MEC-ETS/KiCad_Library/3D_Models/IC/Master_Board.step.SLDASM

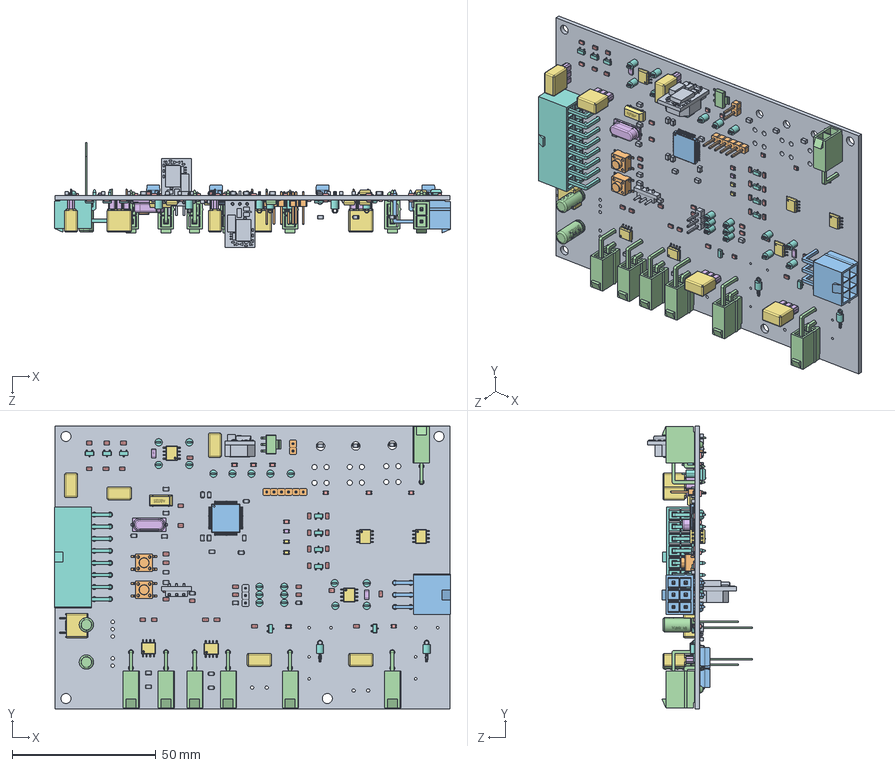
[picture p1: CAD file, 2025-02-11]
3D_Models/IC/Master_Board.step.SLDASM
137.8 x 98.3 x 36.7 mm
COMPOUND.step x 47
COMPOUND-0.step
SOLID.step x 4
COMPOUND-2.step x 2
COMPOUND-5.step x 9
COMPOUND-13.step x 2
COMPOUND-7.step x 2
SOLID-2.step x 11
SOLID-9.step x 2
SOLID-14.step x 5
SOLID-15.step x 5
SOLID-16.step x 5
SOLID-17.step x 5
SOLID-18.step x 5
COMPOUND-19.step x 6
COMPOUND-14.step
COMPOUND-20.step
COMPOUND-16.step
COMPOUND-29.step
COMPOUND-6.step x 7
COMPOUND-1.step x 57
COMPOUND-21.step x 2
SOLID-26.step x 8
COMPOUND-23.step x 21
COMPOUND-24.step x 2
COMPOUND-22.step x 2
SOLID-0.step
SOLID-25.step
SOLID-8.step x 2
SOLID-28.step
SOLID-27.step
SOLID-33.step
COMPOUND-34.step
