MEC-ETS/KiCad_Library/3D_Models/Assembly/KTT0003B.stp

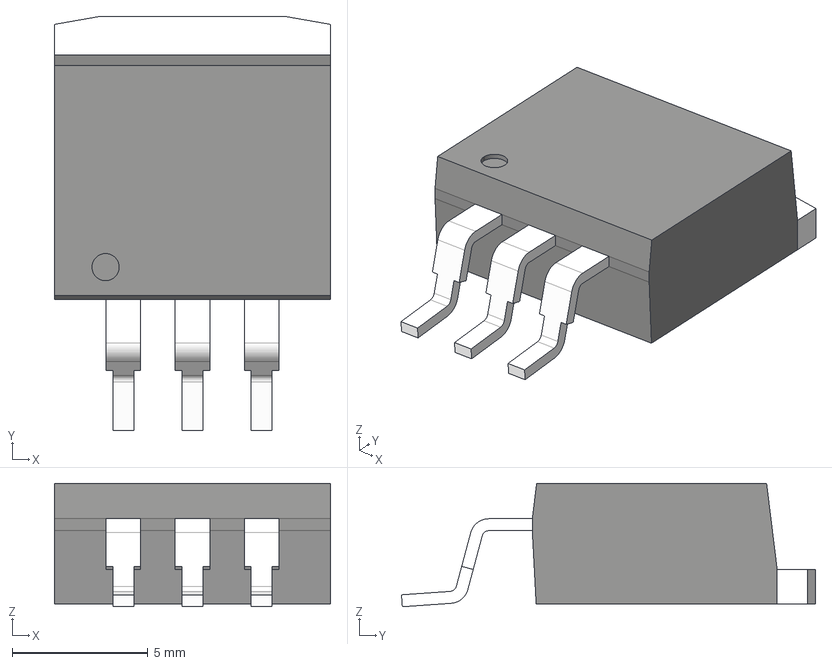
[picture p2: CAD file, 2025-03-18]
3D_Models/Assembly/KTT0003B.stp
10.2 x 15.2 x 4.54 mm
BODY-TO
HTSINK-TO263
LEAD-TO263 x 3
