MEC-ETS/KiCad_Library/3D_Models/Capacitors/DE2E3SA102MN3AY02F.step

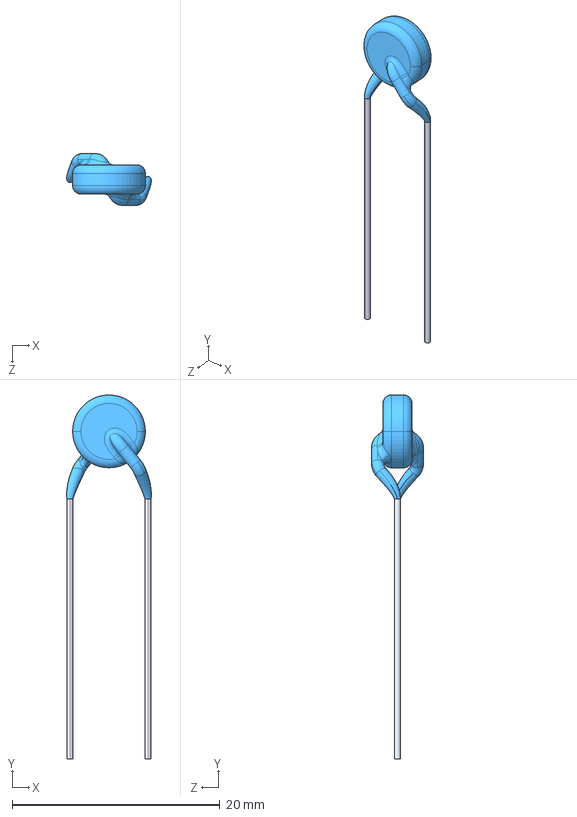
[picture p3: CAD file, 2025-02-28]
3D_Models/Capacitors/DE2E3SA102MN3AY02F.step
8.16 x 35.0 x 5.00 mm
