MEC-ETS/KiCad_Library/3D_Models/Crystals/XTAL_ABL-16_ABR.step

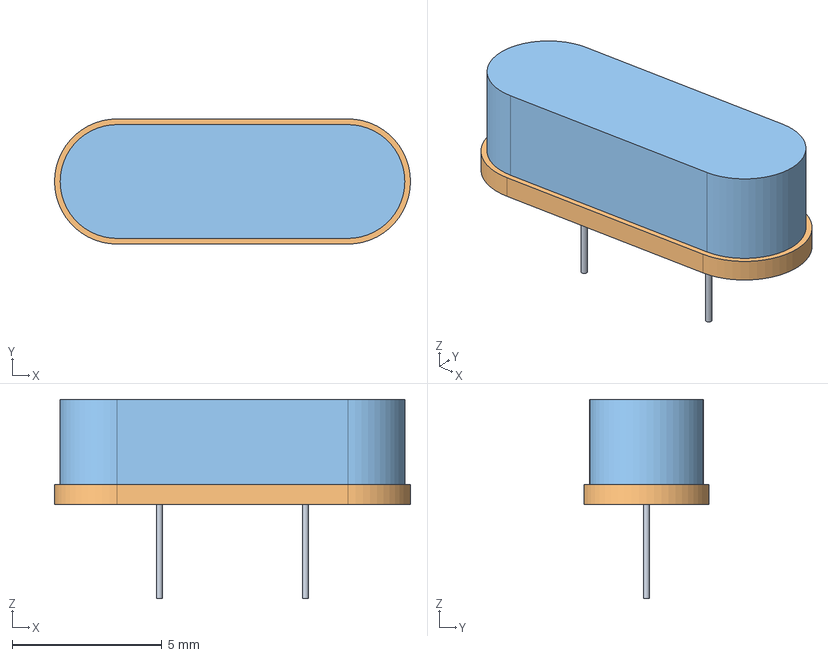
[picture p4: CAD file, 2025-03-23]
3D_Models/Crystals/XTAL_ABL-16_ABR.step
11.9 x 4.18 x 6.65 mm
