MEC-ETS/KiCad_Library/3D_Models/Diodes/CR_DO-41_SDS.step

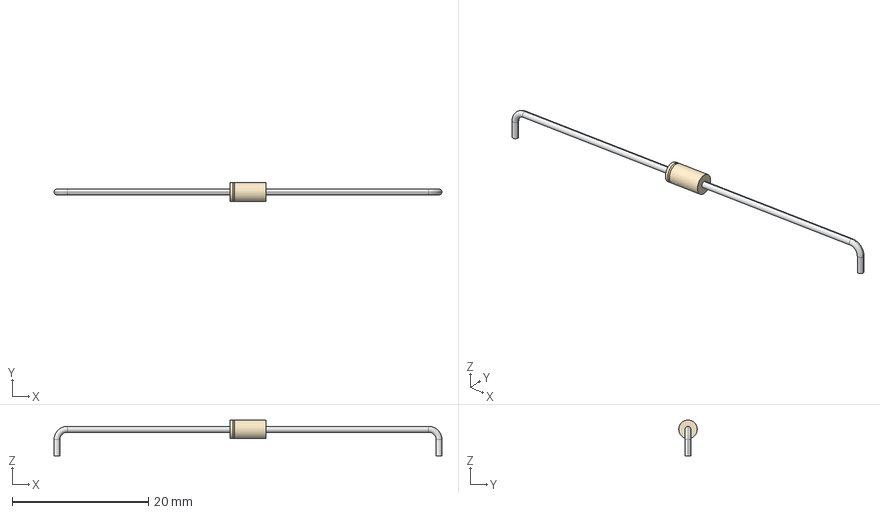
[picture p5: CAD file, 2025-03-19]
3D_Models/Diodes/CR_DO-41_SDS.step
56.9 x 2.72 x 5.26 mm
