MEC-ETS/KiCad_Library/3D_Models/Filter/FB-0603.stp

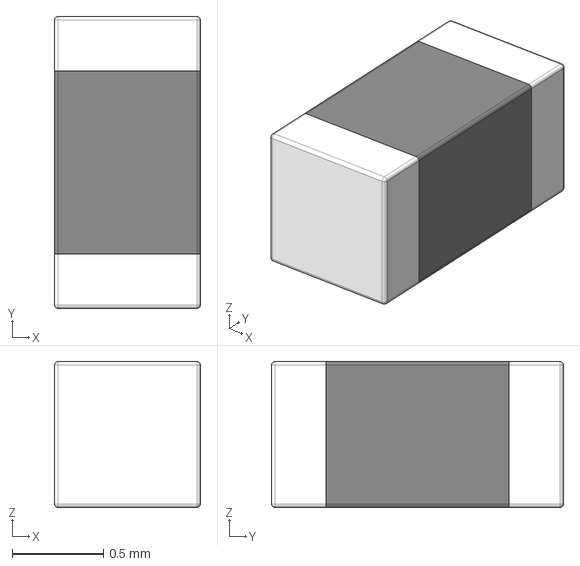
[picture p6: CAD file, 2025-02-11]
3D_Models/Filter/FB-0603.stp
0.8 x 1.60 x 0.8 mm
