MEC-ETS/KiCad_Library/3D_Models/Fuses/4628.step

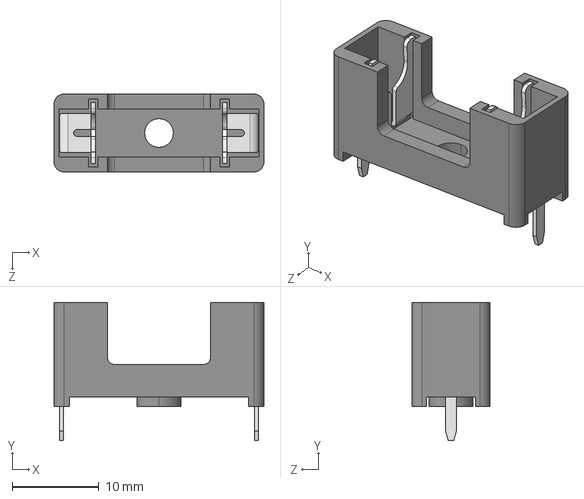
[picture p7: CAD file, 2025-02-28]
3D_Models/Fuses/4628.step
24.2 x 16.0 x 8.99 mm
