MEC-ETS/KiCad_Library/3D_Models/IC/STM32F103C8T6.STEP

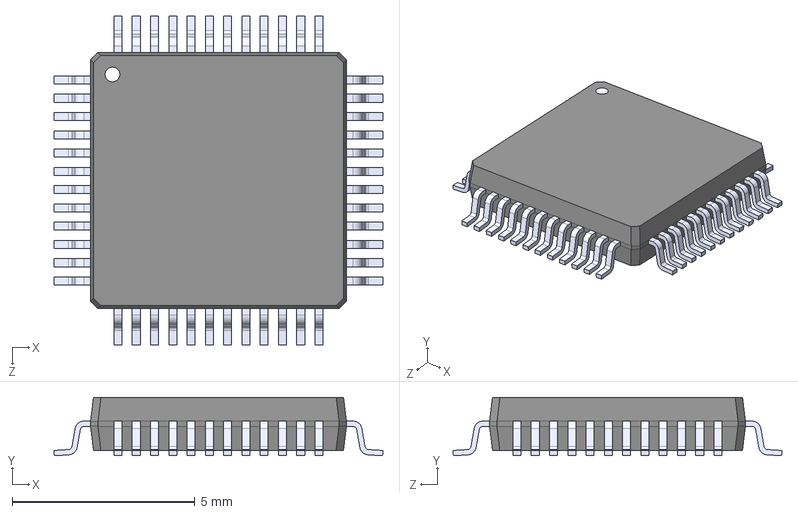
[picture p8: CAD file, 2025-03-27]
3D_Models/IC/STM32F103C8T6.STEP
9.00 x 1.60 x 9.00 mm
