MEC-ETS/KiCad_Library/3D_Models/Inductors/IND_BOURNS_SRR1240.step

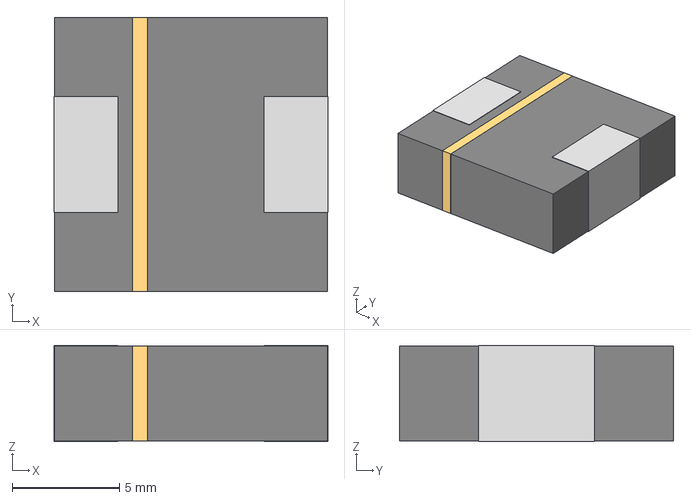
[picture p9: CAD file, 2025-02-28]
3D_Models/Inductors/IND_BOURNS_SRR1240.step
12.8 x 12.8 x 4.50 mm
