MEC-ETS/KiCad_Library/3D_Models/LED/OBJ_GREGS-SK6812MINI-E-DOWN-POINTING.obj

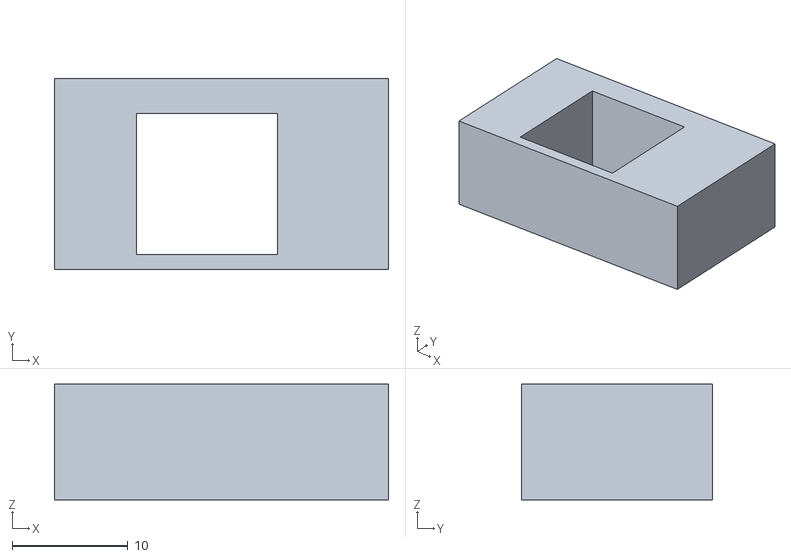
[picture p10: CAD file, 2025-03-18]
3D_Models/LED/OBJ_GREGS-SK6812MINI-E-DOWN-POINTING.obj
28.9 x 16.5 x 10.0
