MEC-ETS/KiCad_Library/3D_Models/Relays/PR23-5V-900-1C.step

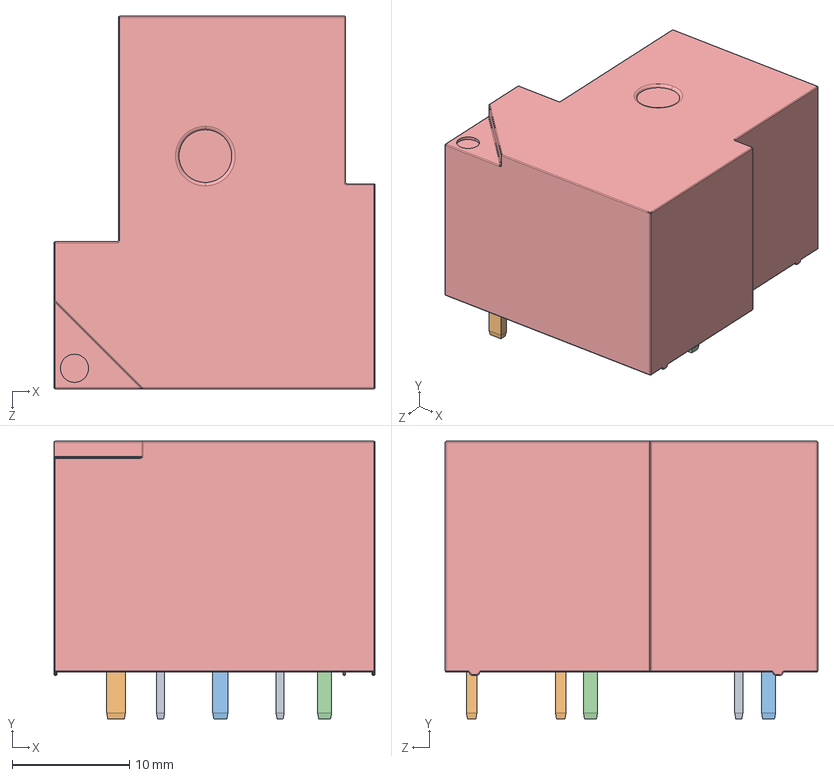
[picture p11: CAD file, 2025-02-28]
3D_Models/Relays/PR23-5V-900-1C.step
27.4 x 23.7 x 31.8 mm
