MEC-ETS/KiCad_Library/3D_Models/Resistors/PT01-D115D-B503.step

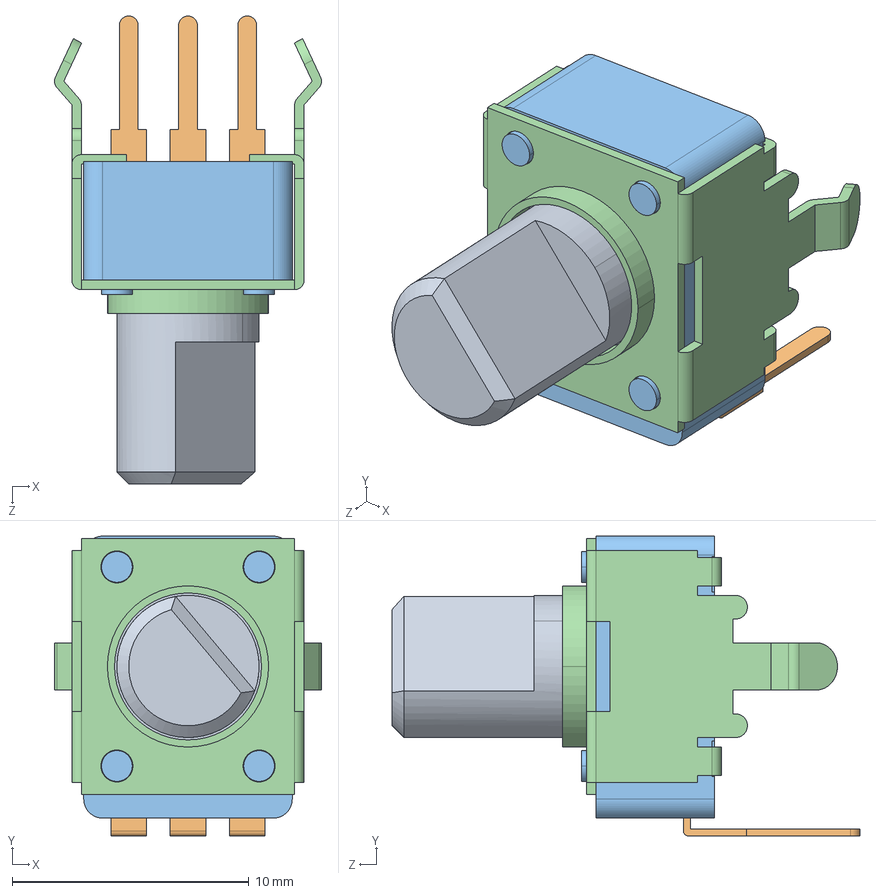
[picture p12: CAD file, 2025-03-23]
3D_Models/Resistors/PT01-D115D-B503.step
11.3 x 12.7 x 19.8 mm
PT01_15D_SHAFT
PT01-D_BODY
PT01-D_SHELL
