MEC-ETS/KiCad_Library/3D_Models/Switches/D501J12S2APQA.stp

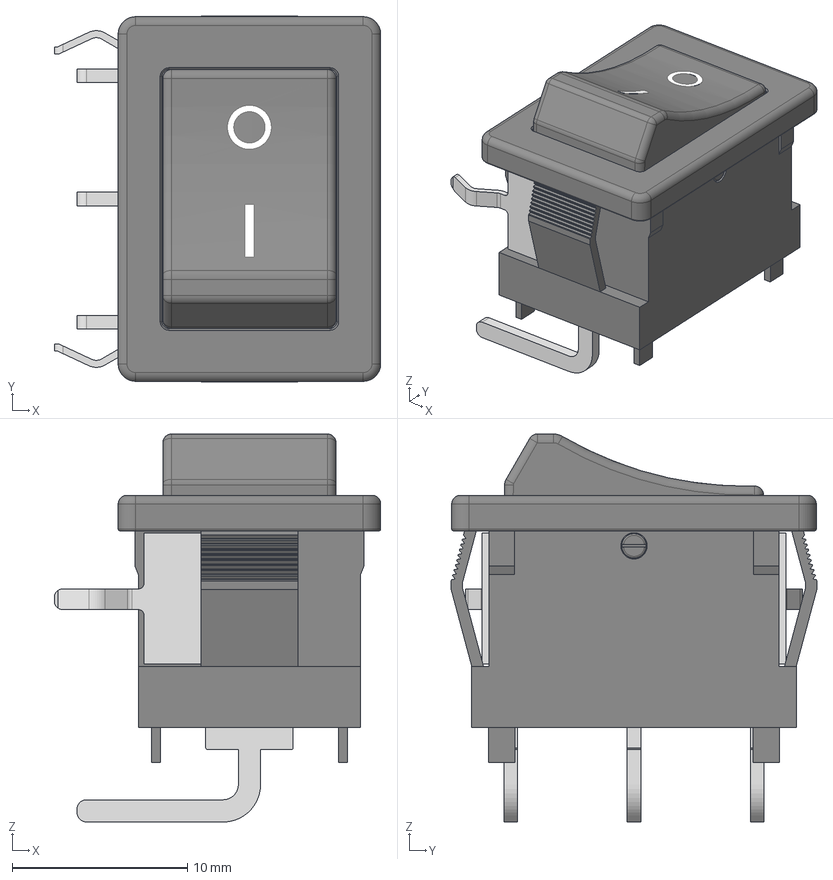
[picture p13: CAD file, 2025-03-18]
3D_Models/Switches/D501J12S2APQA.stp
18.6 x 20.9 x 22.2 mm
