MEC-ETS/KiCad_Library/SRD-05VDC-SL-C.step

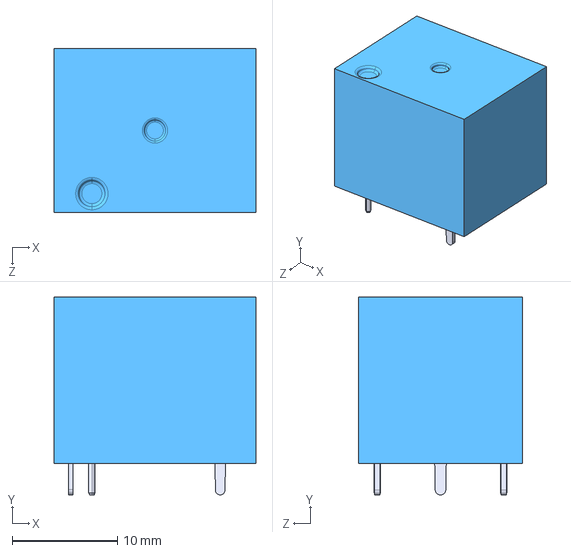
[picture p14: CAD file, 2025-08-30]
SRD-05VDC-SL-C.step
19.2 x 18.8 x 15.6 mm
