MEC-ETS/KiCad_Library/3D_Models/Assembly/LD1117DT33CTR.step

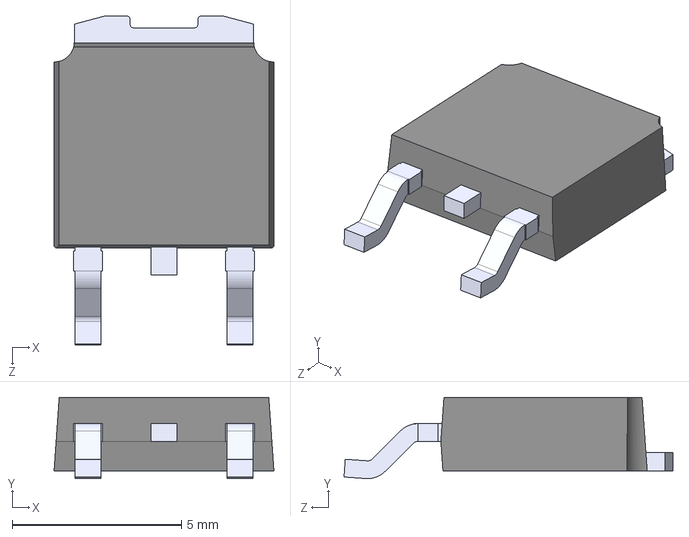
[picture p15: CAD file, 2025-03-18]
3D_Models/Assembly/LD1117DT33CTR.step
6.50 x 2.40 x 9.72 mm
