MEC-ETS/KiCad_Library/3D_Models/Capacitors/CCS_CCSTDNOS_1812_L4.8W3.5T2.3B0.95.step

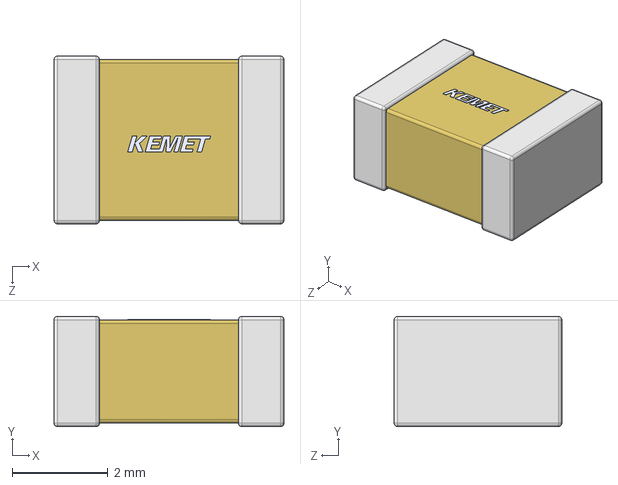
[picture p16: CAD file, 2025-02-28]
3D_Models/Capacitors/CCS_CCSTDNOS_1812_L4.8W3.5T2.3B0.95.step
4.80 x 2.30 x 3.50 mm
