MEC-ETS/KiCad_Library/3D_Models/Crystals/HC49_US.step

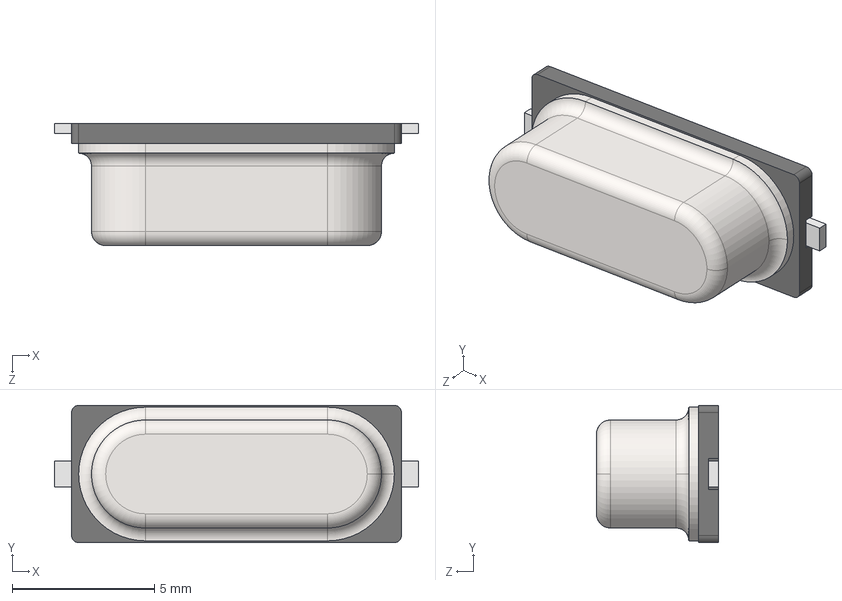
[picture p17: CAD file, 2025-02-11]
3D_Models/Crystals/HC49_US.step
12.8 x 4.83 x 4.30 mm
