MEC-ETS/KiCad_Library/3D_Models/Diodes/DO-35_DO-204AH__MCH.step

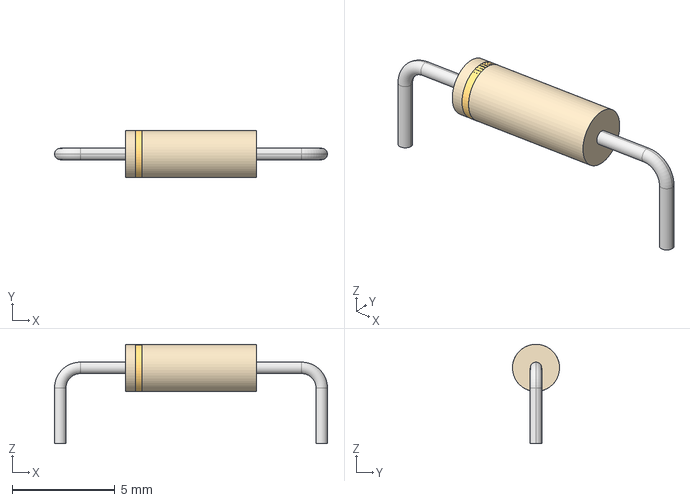
[picture p18: CAD file, 2025-03-19]
3D_Models/Diodes/DO-35_DO-204AH__MCH.step
13.3 x 2.29 x 4.83 mm
