MEC-ETS/KiCad_Library/3D_Models/Filter/WE-CNSW-0603.stp

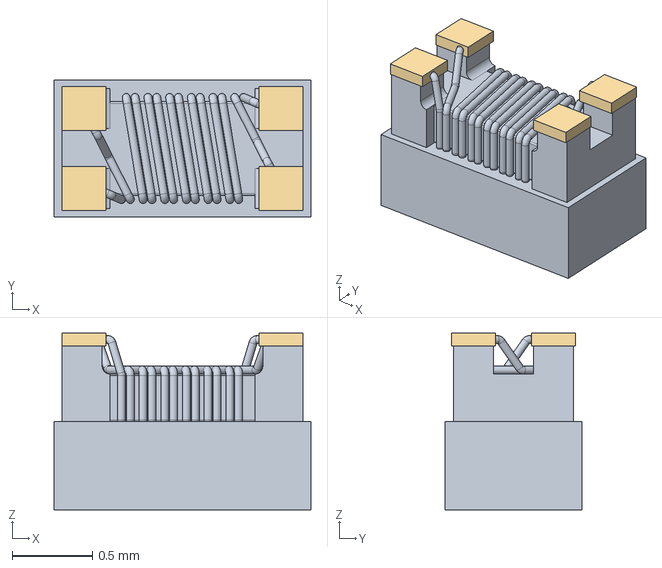
[picture p19: CAD file, 2025-02-11]
3D_Models/Filter/WE-CNSW-0603.stp
1.60 x 0.85 x 1.10 mm
