MEC-ETS/KiCad_Library/3D_Models/Fuses/ATO_BLADE_FUSE.STEP

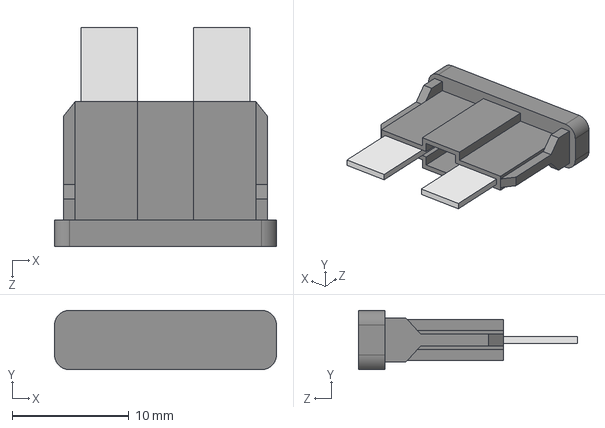
[picture p20: CAD file, 2025-02-11]
3D_Models/Fuses/ATO_BLADE_FUSE.STEP
19.0 x 5.08 x 18.8 mm
