MEC-ETS/KiCad_Library/3D_Models/IC/TO-92_2.step

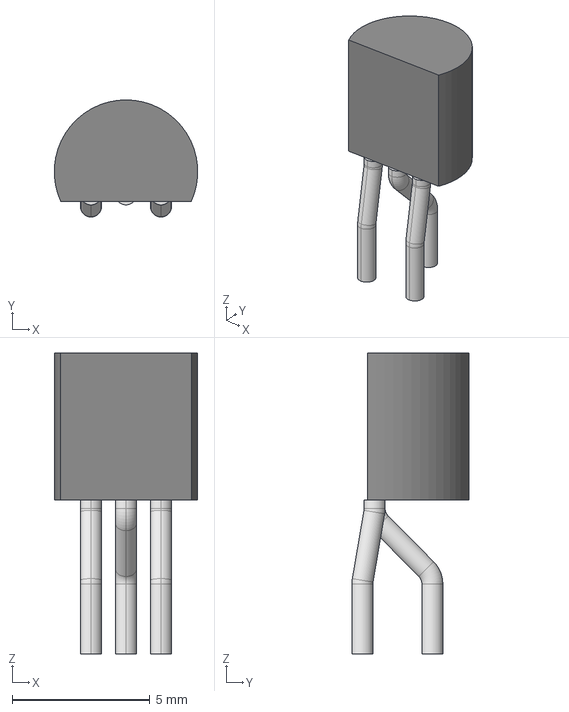
[picture p21: CAD file, 2025-03-19]
3D_Models/IC/TO-92_2.step
5.20 x 4.25 x 10.9 mm
