MEC-ETS/KiCad_Library/3D_Models/LED/SMD WS2812B Mini.step

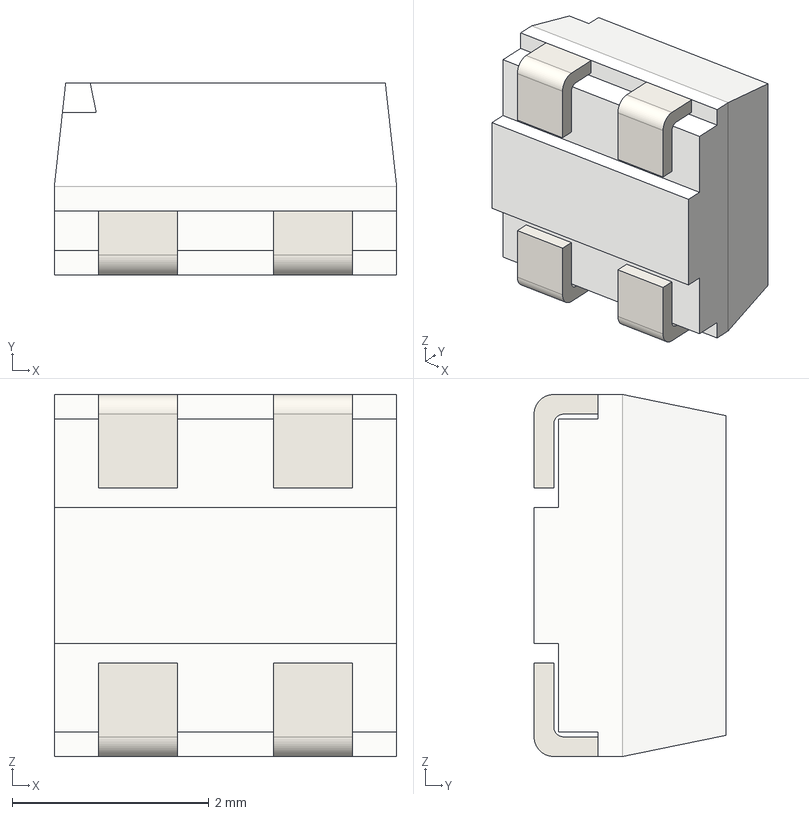
[picture p22: CAD file, 2025-03-18]
3D_Models/LED/SMD WS2812B Mini.step
3.48 x 1.95 x 3.68 mm
