MEC-ETS/KiCad_Library/3D_Models/Relays/G6C_2117P_US.step

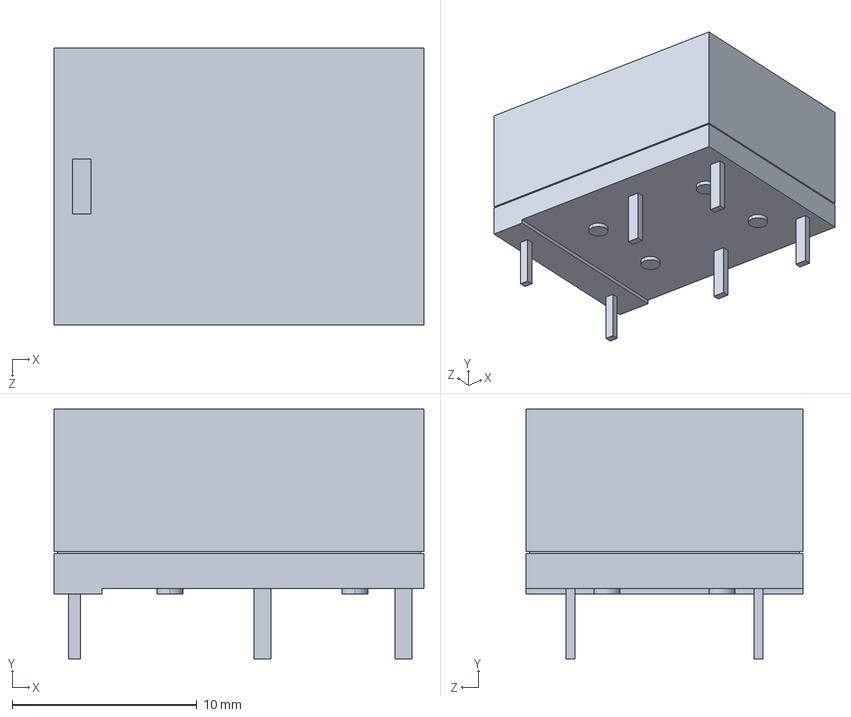
[picture p23: CAD file, 2025-02-11]
3D_Models/Relays/G6C_2117P_US.step
20.0 x 13.5 x 15.0 mm
