MEC-ETS/KiCad_Library/3D_Models/Resistors/RES_2512_SUS.step

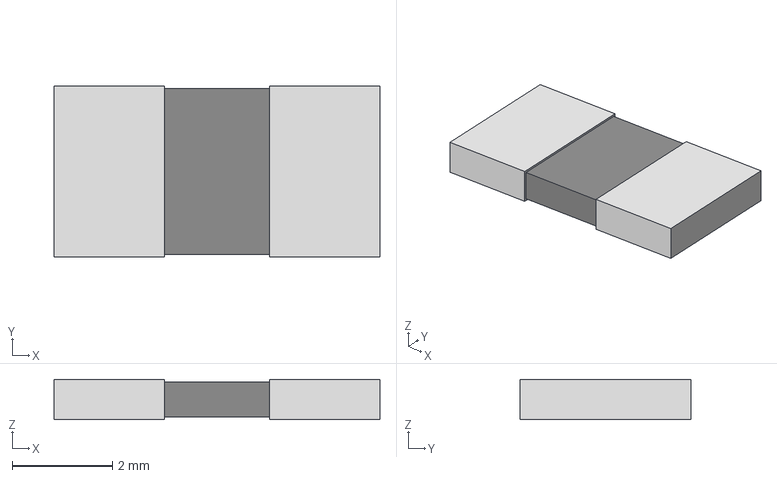
[picture p24: CAD file, 2025-02-28]
3D_Models/Resistors/RES_2512_SUS.step
6.50 x 3.40 x 0.8 mm
