MEC-ETS/KiCad_Library/3D_Models/Transformers/LD30-23BxxR2_MNS.step

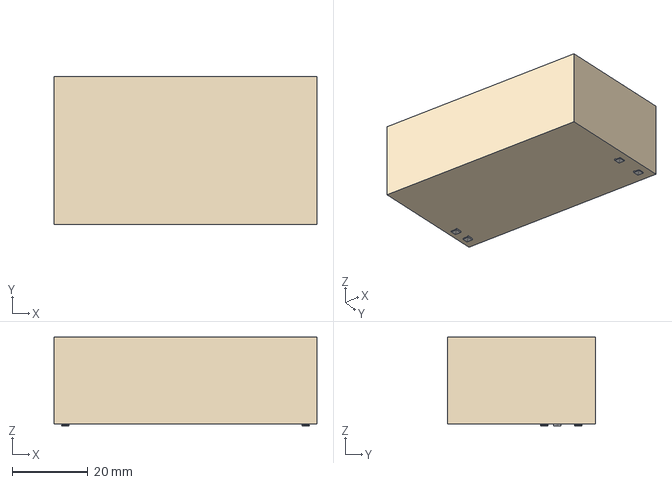
[picture p26: CAD file, 2025-02-28]
3D_Models/Transformers/LD30-23BxxR2_MNS.step
69.5 x 39.0 x 23.5 mm
