MEC-ETS/KiCad_Library/3D_Models/Assembly/74LVC1G14GW_125.step

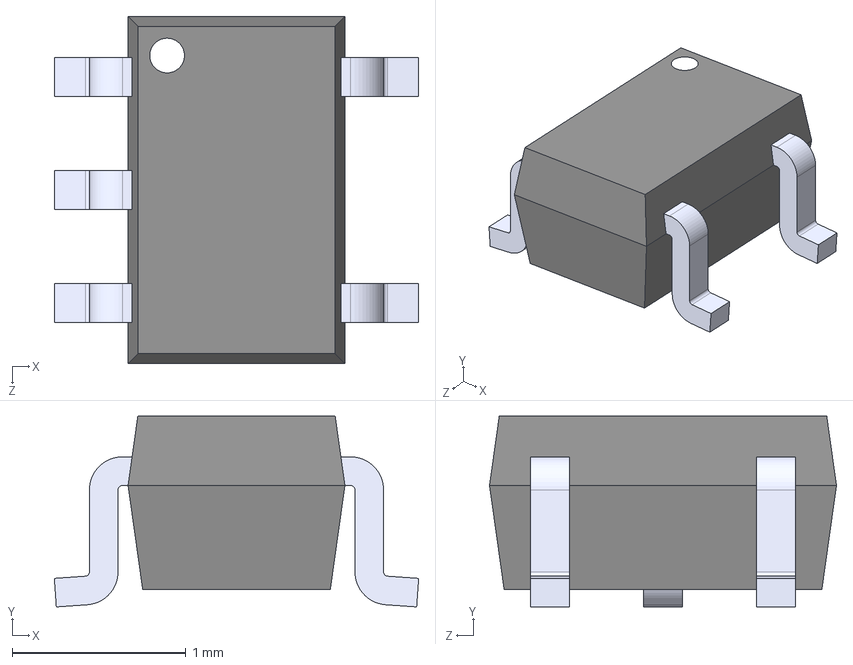
[picture p27: CAD file, 2025-02-28]
3D_Models/Assembly/74LVC1G14GW_125.step
2.10 x 1.10 x 2.00 mm
