MEC-ETS/KiCad_Library/3D_Models/Capacitors/GRM55DR72E105KW01L.step

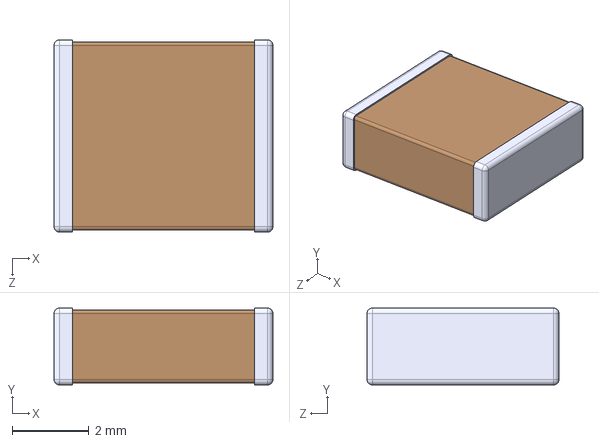
[picture p28: CAD file, 2025-02-28]
3D_Models/Capacitors/GRM55DR72E105KW01L.step
5.70 x 2.00 x 5.00 mm
