MEC-ETS/KiCad_Library/3D_Models/Connectors/3220-14-0100-00.STEP

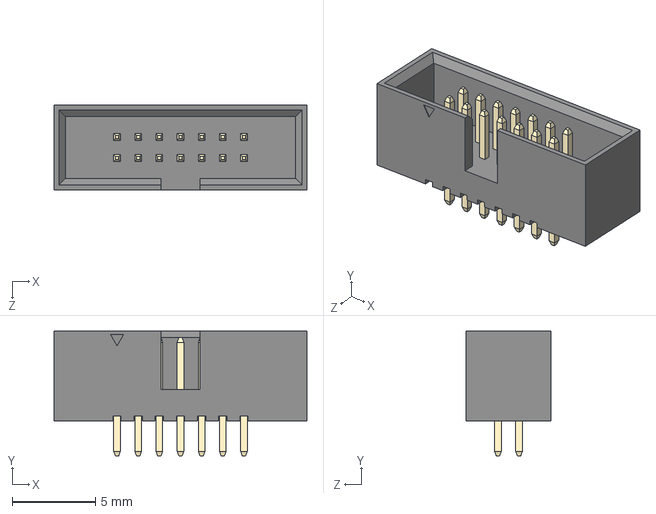
[picture p29: CAD file, 2025-08-23]
3D_Models/Connectors/3220-14-0100-00.STEP
15.2 x 7.50 x 5.10 mm
3220-xx-0100-00 body_14
Pin^3220-xx-0100-00 x 14
