MEC-ETS/KiCad_Library/3D_Models/Crystals/TXC 7A Series.step

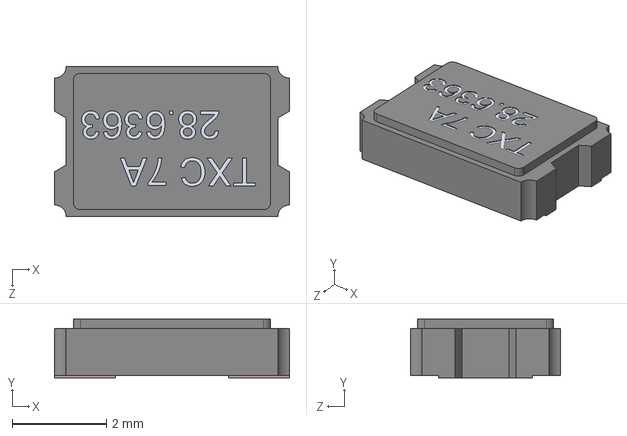
[picture p30: CAD file, 2025-02-11]
3D_Models/Crystals/TXC 7A Series.step
5.00 x 1.25 x 3.20 mm
