MEC-ETS/KiCad_Library/3D_Models/Diodes/DO-35_VIS.step

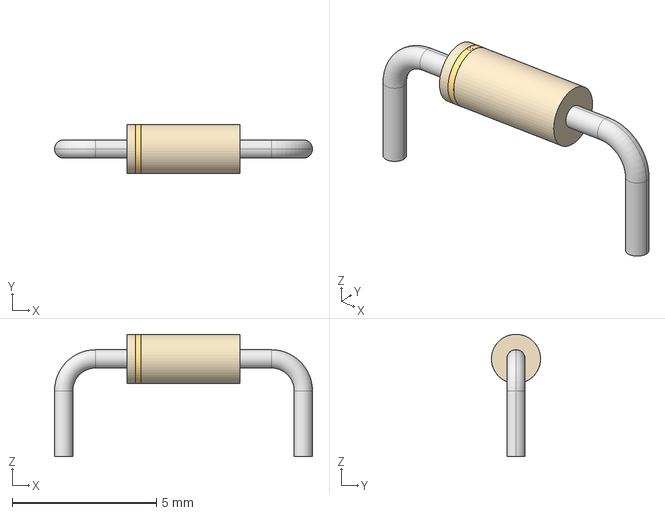
[picture p31: CAD file, 2025-03-19]
3D_Models/Diodes/DO-35_VIS.step
8.94 x 1.71 x 4.24 mm
