MEC-ETS/KiCad_Library/3D_Models/IC/NDE0003B.stp

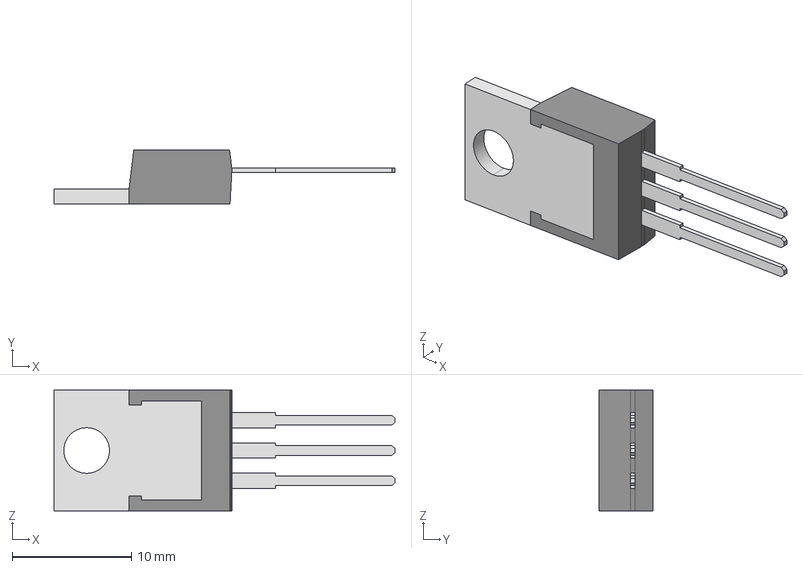
[picture p32: CAD file, 2025-03-19]
3D_Models/IC/NDE0003B.stp
28.7 x 4.57 x 10.2 mm
T03B_BODY
T03B_LEAD x 3
T03B_HS
