MEC-ETS/KiCad_Library/3D_Models/Inductors/WE-TPC-SMD.stp

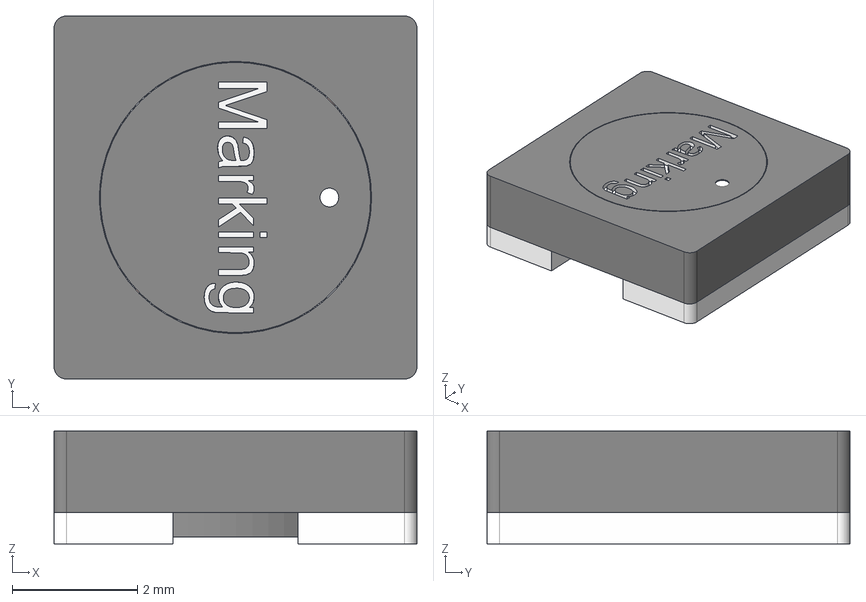
[picture p33: CAD file, 2025-02-11]
3D_Models/Inductors/WE-TPC-SMD.stp
5.80 x 5.80 x 1.80 mm
