MEC-ETS/KiCad_Library/3D_Models/LED/LED_STP_WL-SWTC-3535 (rev1).stp

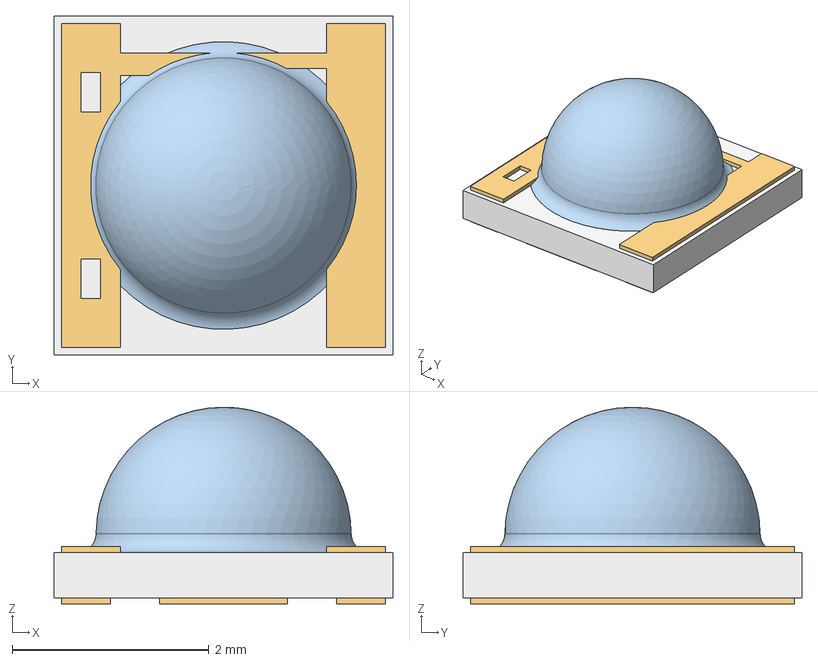
[picture p34: CAD file, 2025-02-11]
3D_Models/LED/LED_STP_WL-SWTC-3535 (rev1).stp
3.45 x 3.45 x 2.00 mm
contact x 3
LED x 2
platte
dome
