MEC-ETS/KiCad_Library/3D_Models/Relays/J107F1CS1224VDC.36.stp

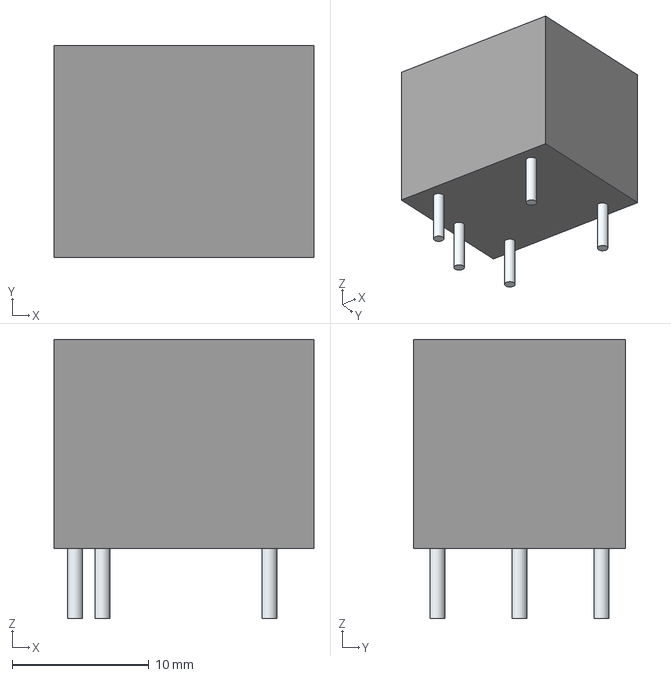
[picture p35: CAD file, 2025-02-11]
3D_Models/Relays/J107F1CS1224VDC.36.stp
19.0 x 15.5 x 20.4 mm
Leads
