MEC-ETS/KiCad_Library/3D_Models/Resistors/VARS_B72214S_15P5X5P6-7P5-2P2_TDK.step

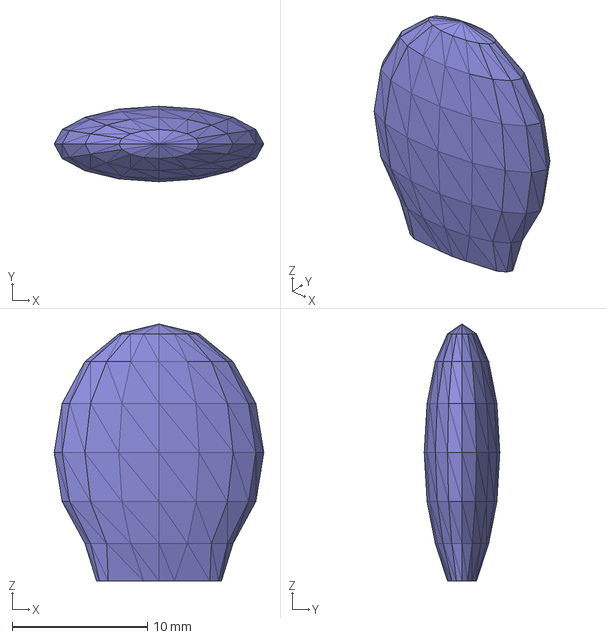
[picture p36: CAD file, 2025-02-28]
3D_Models/Resistors/VARS_B72214S_15P5X5P6-7P5-2P2_TDK.step
15.5 x 5.59 x 19.0 mm
