MEC-ETS/KiCad_Library/3D_Models/Switches/100DPxT1B2M2xE.stp

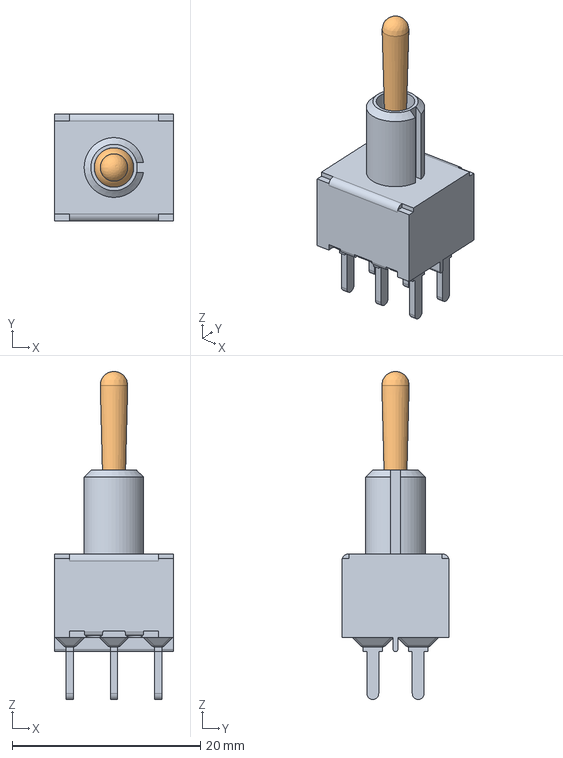
[picture p37: CAD file, 2025-02-11]
3D_Models/Switches/100DPxT1B2M2xE.stp
12.7 x 11.4 x 34.9 mm
