MEC-ETS/KiCad_Library/3D_Models/Transformers/power_supply_irm-30-5.stp

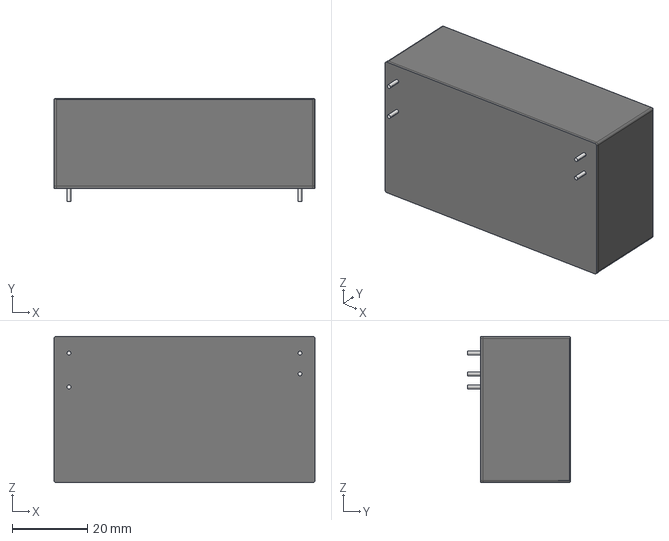
[picture p38: CAD file, 2025-02-26]
3D_Models/Transformers/power_supply_irm-30-5.stp
69.5 x 27.5 x 39.0 mm
