MEC-ETS/KiCad_Library/3D_Models/Capacitors/C5750X7R2E105K230KA.step

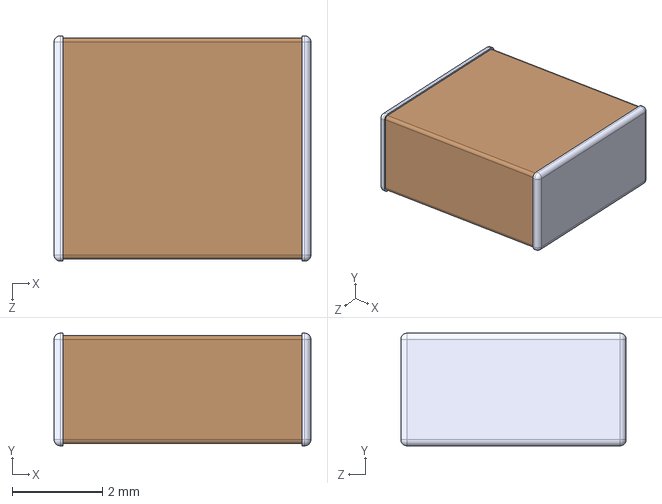
[picture p39: CAD file, 2025-02-28]
3D_Models/Capacitors/C5750X7R2E105K230KA.step
5.70 x 2.50 x 5.00 mm
