MEC-ETS/KiCad_Library/3D_Models/Crystals/ABS25.STEP

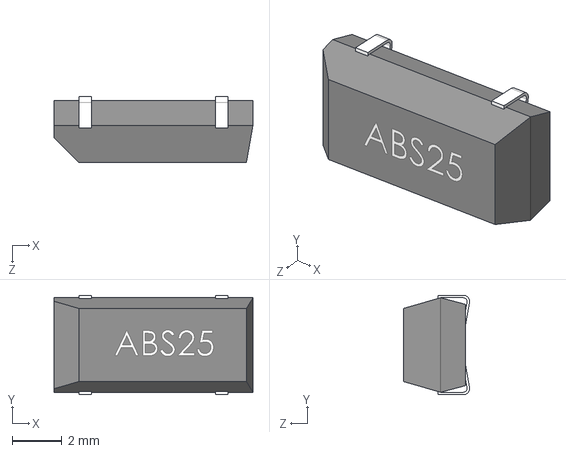
[picture p40: CAD file, 2025-02-11]
3D_Models/Crystals/ABS25.STEP
8.00 x 4.00 x 2.66 mm
