MEC-ETS/KiCad_Library/3D_Models/Diodes/SOT-23_ONS.step

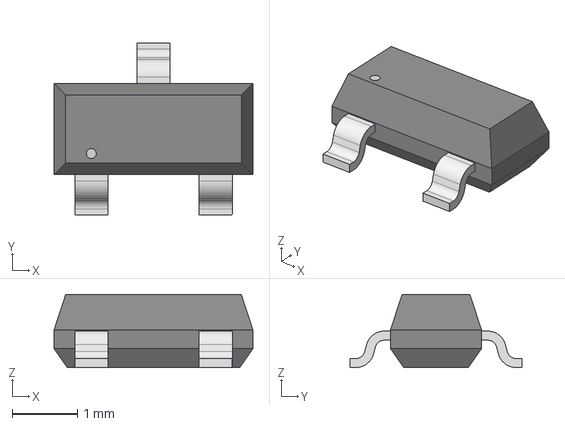
[picture p41: CAD file, 2025-03-18]
3D_Models/Diodes/SOT-23_ONS.step
3.05 x 2.64 x 1.12 mm
