MEC-ETS/KiCad_Library/3D_Models/Fuses/Littelfuse_TE5_395.step

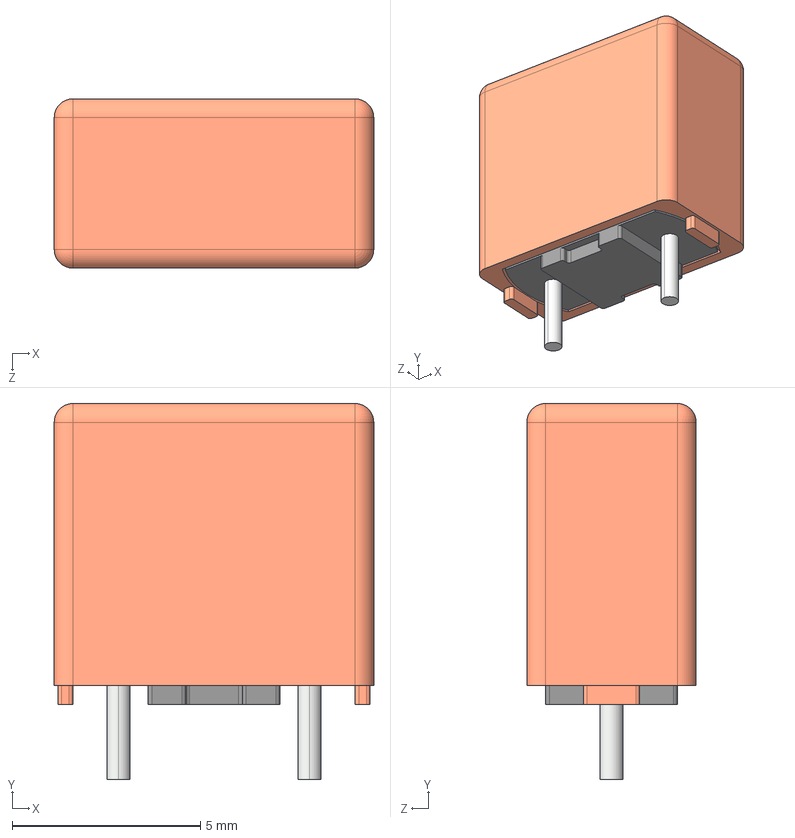
[picture p42: CAD file, 2025-02-11]
3D_Models/Fuses/Littelfuse_TE5_395.step
8.50 x 10.0 x 4.50 mm
