MEC-ETS/KiCad_Library/3D_Models/IC/TO-92-3_4P58X4P58_ONS.step

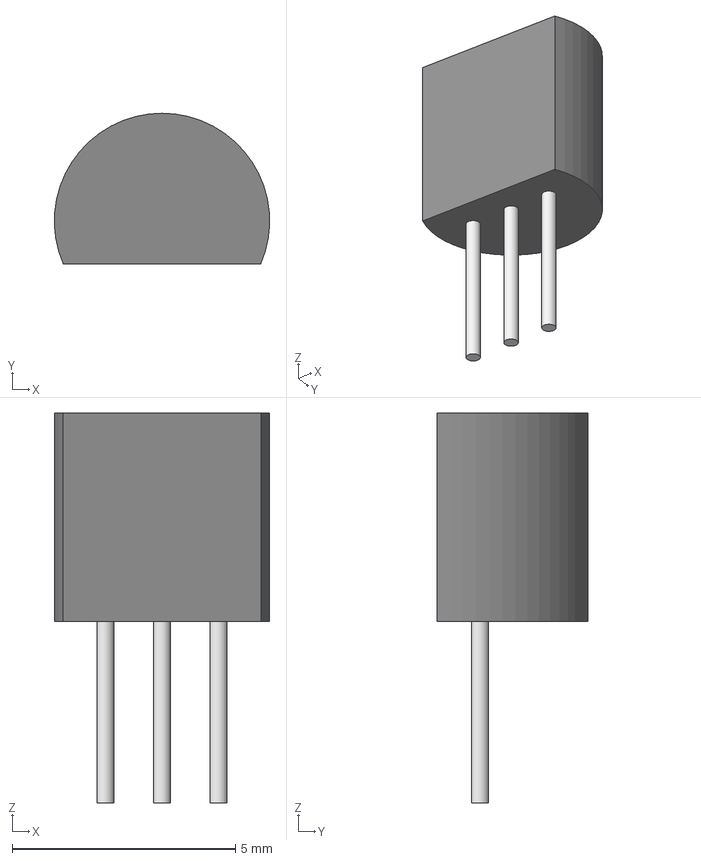
[picture p43: CAD file, 2025-03-19]
3D_Models/IC/TO-92-3_4P58X4P58_ONS.step
4.83 x 3.38 x 8.74 mm
