MEC-ETS/KiCad_Library/3D_Models/Inductors/LQH32PN100MNCL.step

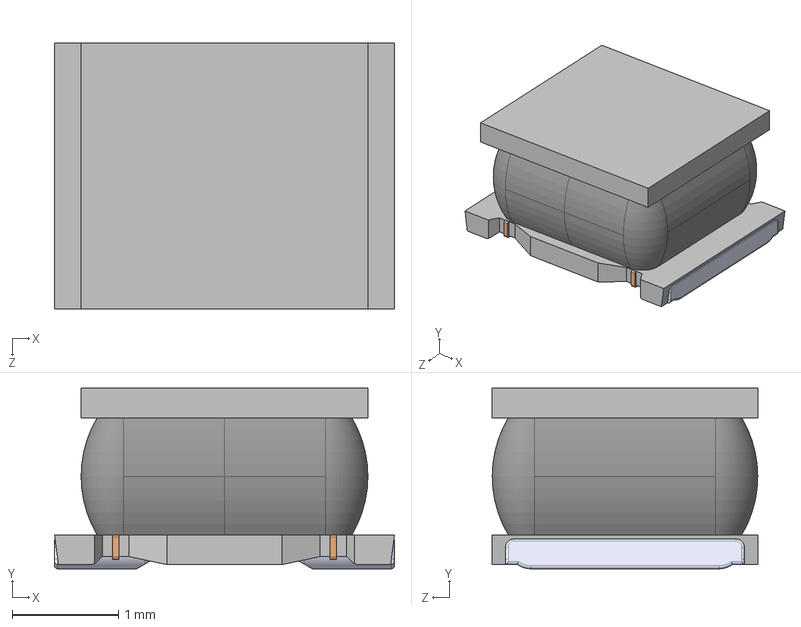
[picture p44: CAD file, 2025-02-11]
3D_Models/Inductors/LQH32PN100MNCL.step
3.20 x 1.70 x 2.50 mm
