MEC-ETS/KiCad_Library/3D_Models/LED/LED_D3.0mm_Horizontal_O1.27mm_Z2.0mm_Clear.step

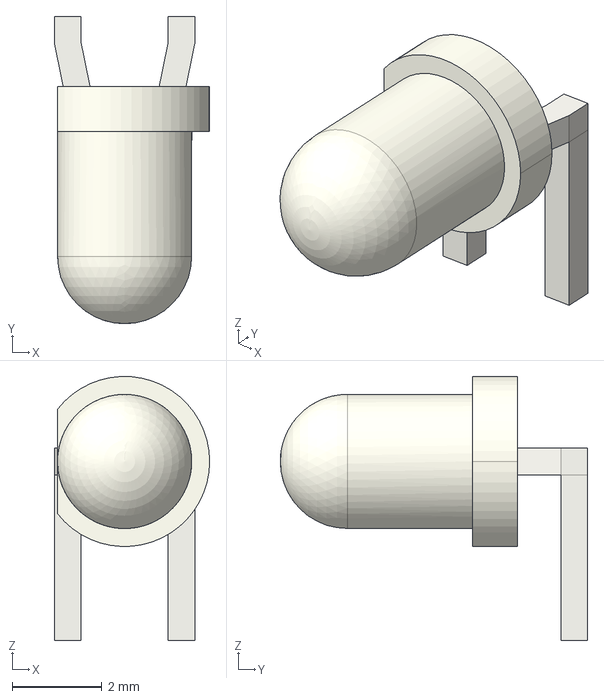
[picture p45: CAD file, 2025-02-11]
3D_Models/LED/LED_D3.0mm_Horizontal_O1.27mm_Z2.0mm_Clear.step
3.47 x 6.87 x 5.90 mm
