MEC-ETS/KiCad_Library/3D_Models/Relays/c-4-1462037-7-b5-3d.stp

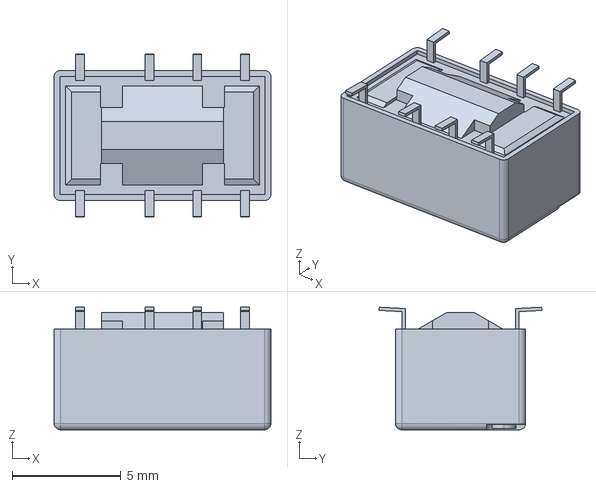
[picture p46: CAD file, 2025-02-11]
3D_Models/Relays/c-4-1462037-7-b5-3d.stp
10.0 x 7.50 x 5.65 mm
