MEC-ETS/KiCad_Library/3D_Models/Switches/Tactile_switch_6x6x5mm.step

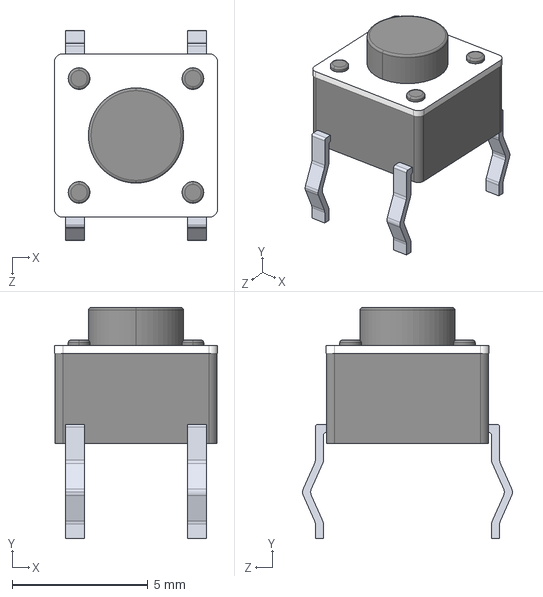
[picture p47: CAD file, 2025-02-11]
3D_Models/Switches/Tactile_switch_6x6x5mm.step
6.03 x 8.52 x 7.74 mm
