MEC-ETS/KiCad_Library/3D_Models/Capacitors/cap_10x10x10-1.STEP

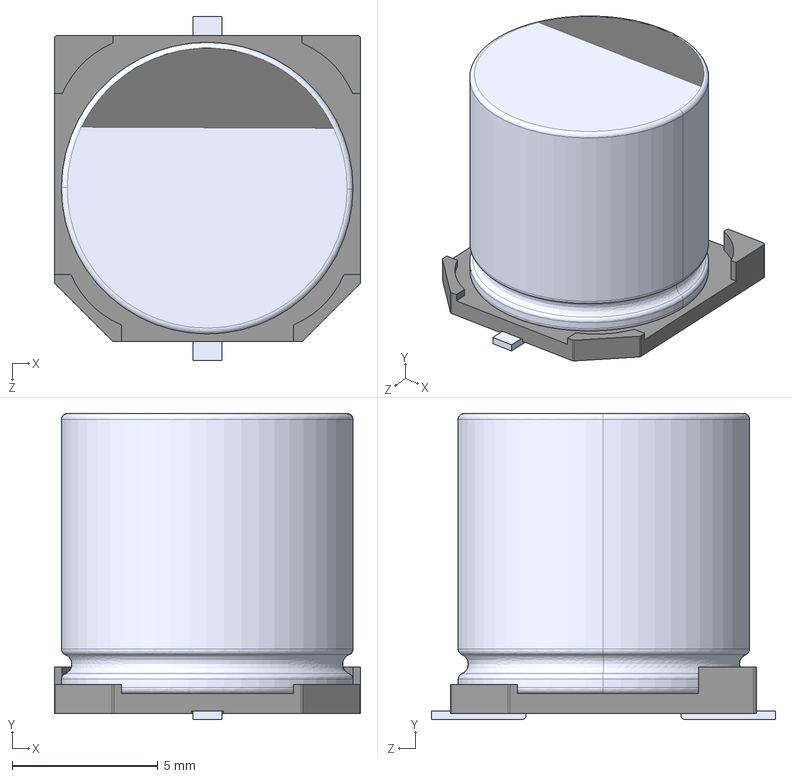
[picture p48: CAD file, 2025-02-11]
3D_Models/Capacitors/cap_10x10x10-1.STEP
10.5 x 10.5 x 11.8 mm
User Library-cap_10x10x10-1_can_10x10_1
User Library-cap_10x10x10-1_foot_cap_10x10_1 x 2
User Library-cap_10x10x10-1_alelcap_sm10x10_1
