MEC-ETS/KiCad_Library/3D_Models/Crystals/7M-16.000MAAJ-T.step

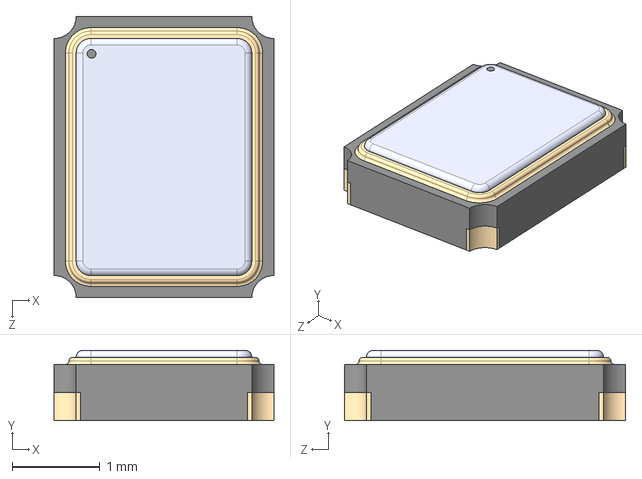
[picture p49: CAD file, 2025-02-11]
3D_Models/Crystals/7M-16.000MAAJ-T.step
2.50 x 0.8 x 3.20 mm
