MEC-ETS/KiCad_Library/3D_Models/Diodes/SMBJSeries_LTF.step

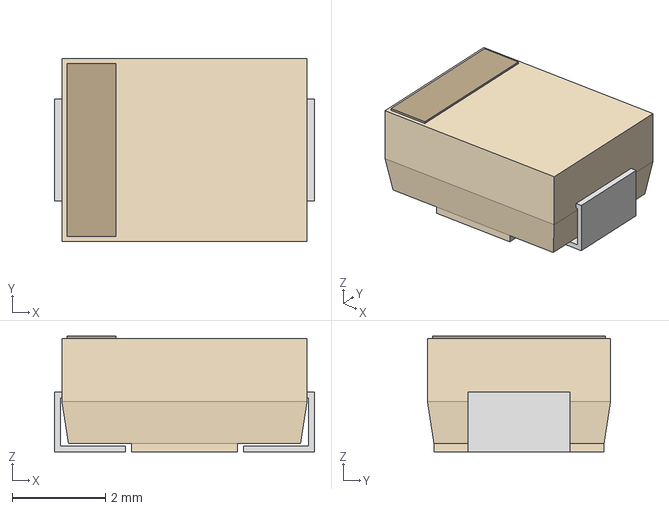
[picture p50: CAD file, 2025-02-28]
3D_Models/Diodes/SMBJSeries_LTF.step
5.59 x 3.94 x 2.49 mm
