MEC-ETS/KiCad_Library/3D_Models/Fuses/Littelfuse_562.stp

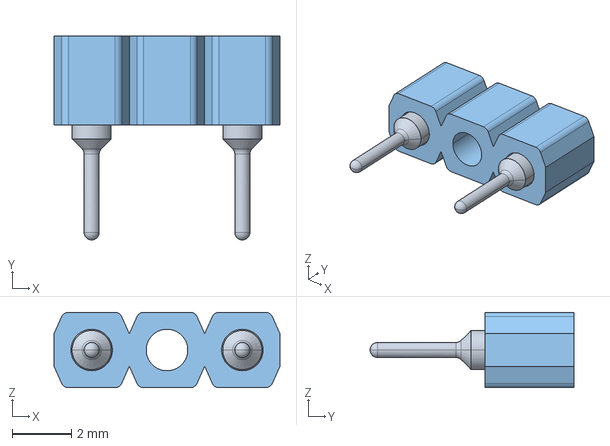
[picture p51: CAD file, 2025-02-11]
3D_Models/Fuses/Littelfuse_562.stp
7.62 x 6.88 x 2.54 mm
