MEC-ETS/KiCad_Library/3D_Models/IC/LQFP144-20x20mm.step

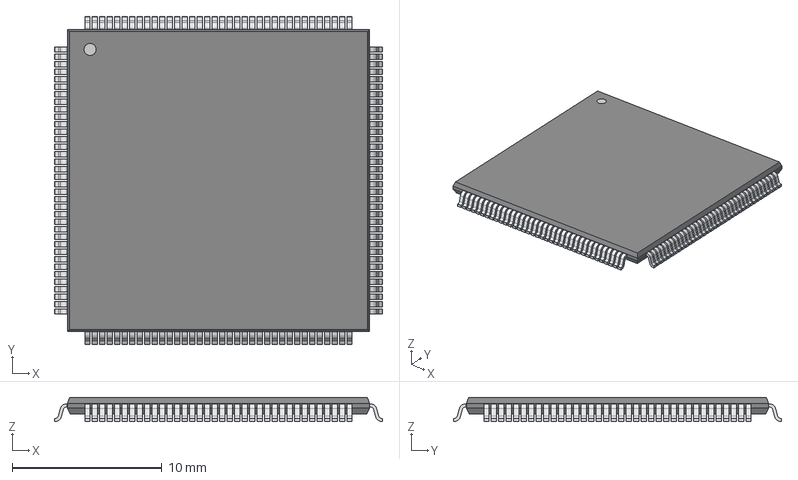
[picture p52: CAD file, 2025-03-18]
3D_Models/IC/LQFP144-20x20mm.step
21.9 x 21.9 x 1.60 mm
