MEC-ETS/KiCad_Library/3D_Models/Inductors/I1206.step

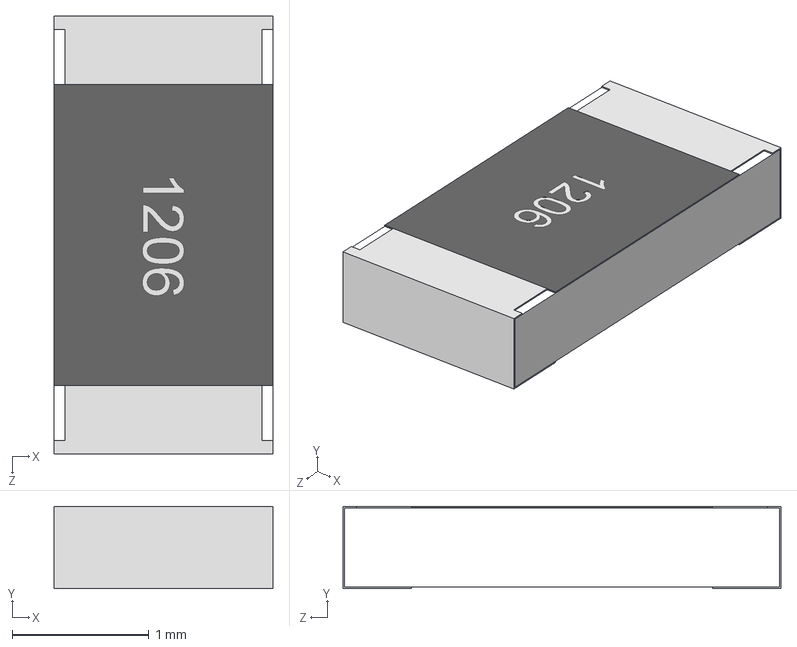
[picture p53: CAD file, 2025-02-11]
3D_Models/Inductors/I1206.step
1.60 x 0.6 x 3.20 mm
