MEC-ETS/KiCad_Library/3D_Models/Relays/adw11・・hlw.igs

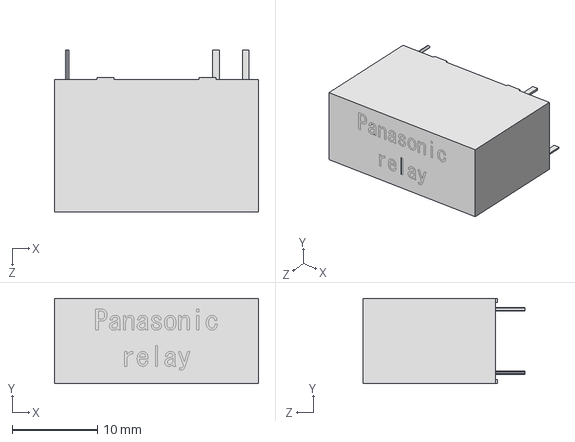
[picture p54: CAD file, 2025-02-11]
3D_Models/Relays/adw11・・hlw.igs
24.0 x 10.0 x 19.0 mm
