MEC-ETS/KiCad_Library/3D_Models/Switches/800AWSP9M2xE.stp

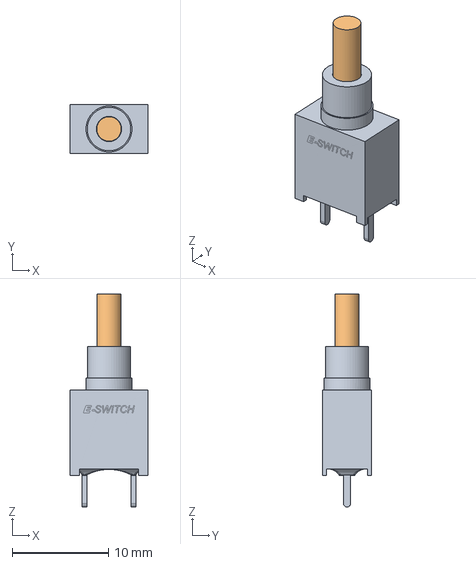
[picture p55: CAD file, 2025-02-11]
3D_Models/Switches/800AWSP9M2xE.stp
8.13 x 5.08 x 22.2 mm
