MEC-ETS/KiCad_Library/3D_Models/Assembly/4525DO-DS5AI001DP.stp

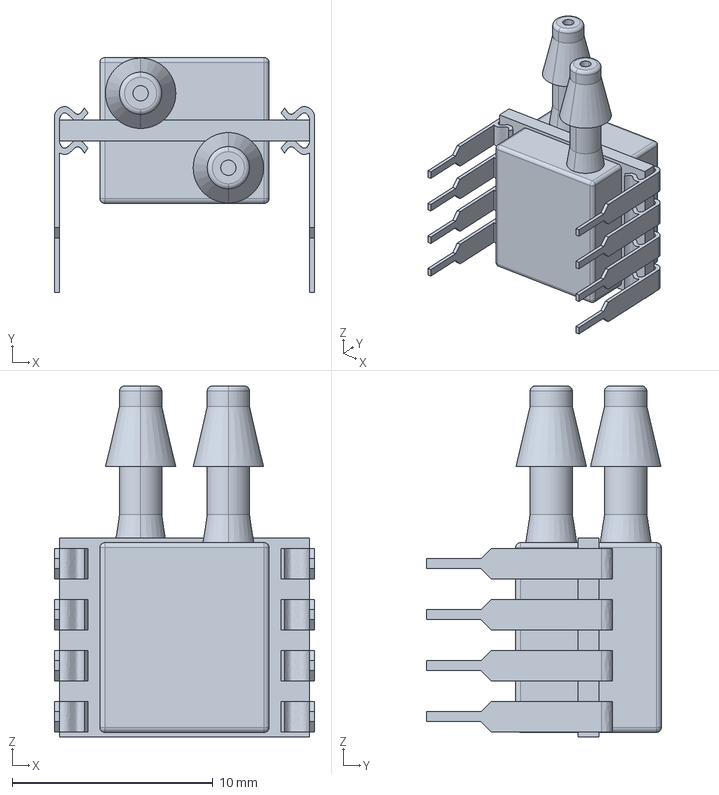
[picture p56: CAD file, 2025-02-11]
3D_Models/Assembly/4525DO-DS5AI001DP.stp
13.0 x 11.7 x 17.5 mm
