MEC-ETS/KiCad_Library/3D_Models/Capacitors/C1206.step

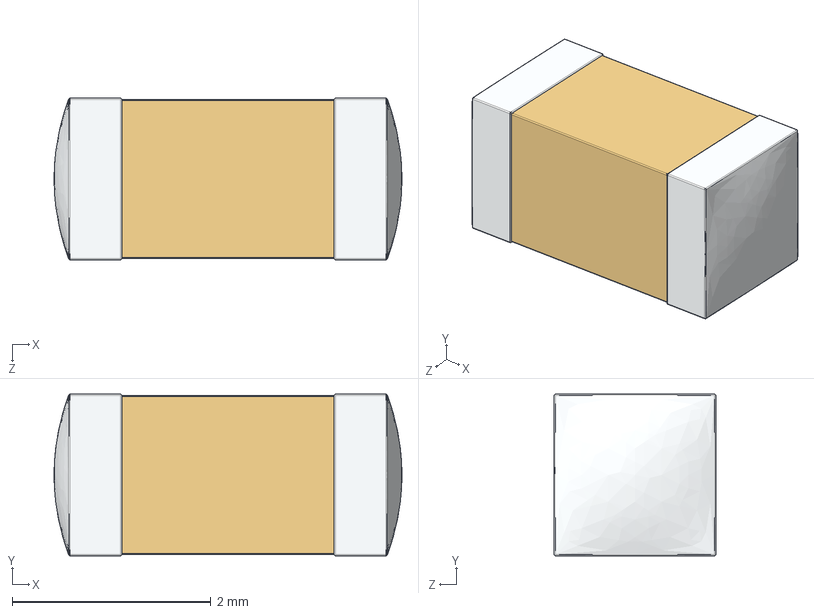
[picture p57: CAD file, 2025-02-11]
3D_Models/Capacitors/C1206.step
3.50 x 1.63 x 1.62 mm
