MEC-ETS/KiCad_Library/3D_Models/Diodes/DO-214AA_SMB.step

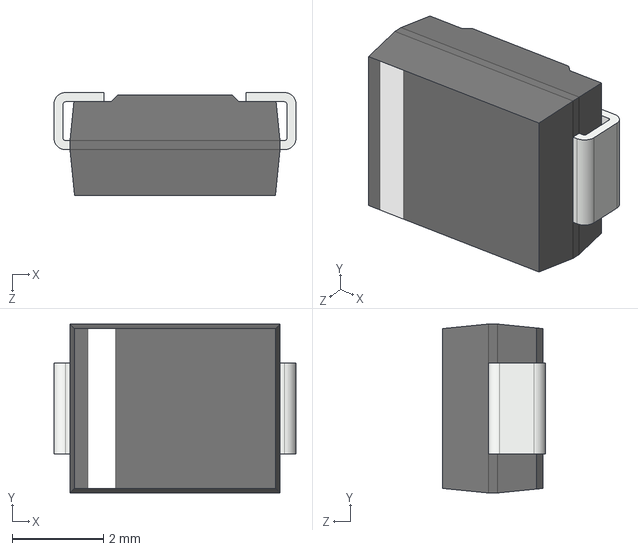
[picture p58: CAD file, 2025-02-11]
3D_Models/Diodes/DO-214AA_SMB.step
5.30 x 3.70 x 2.25 mm
