MEC-ETS/KiCad_Library/3D_Models/Relays/G5CA_1A_E.step

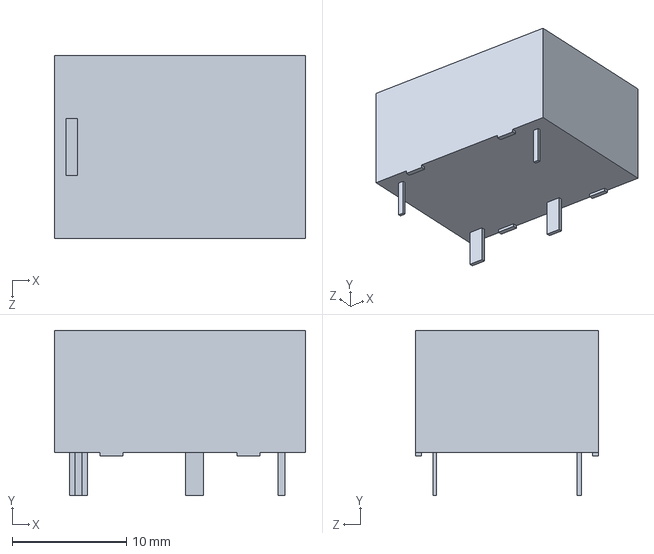
[picture p59: CAD file, 2025-02-11]
3D_Models/Relays/G5CA_1A_E.step
22.0 x 14.5 x 16.0 mm
