MEC-ETS/KiCad_Library/3D_Models/Resistors/R1218.step

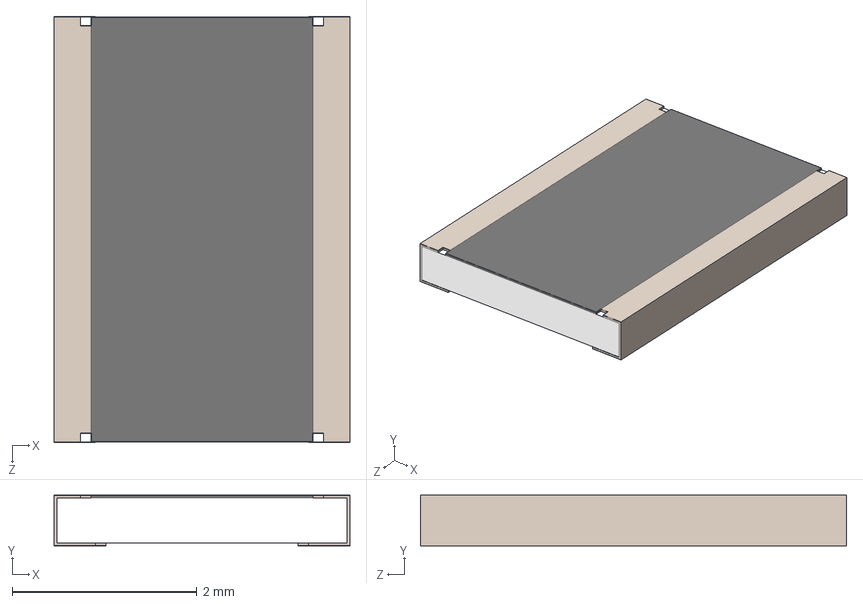
[picture p60: CAD file, 2025-02-11]
3D_Models/Resistors/R1218.step
3.20 x 0.55 x 4.61 mm
