MEC-ETS/KiCad_Library/3D_Models/Switches/GW12LBP.STEP

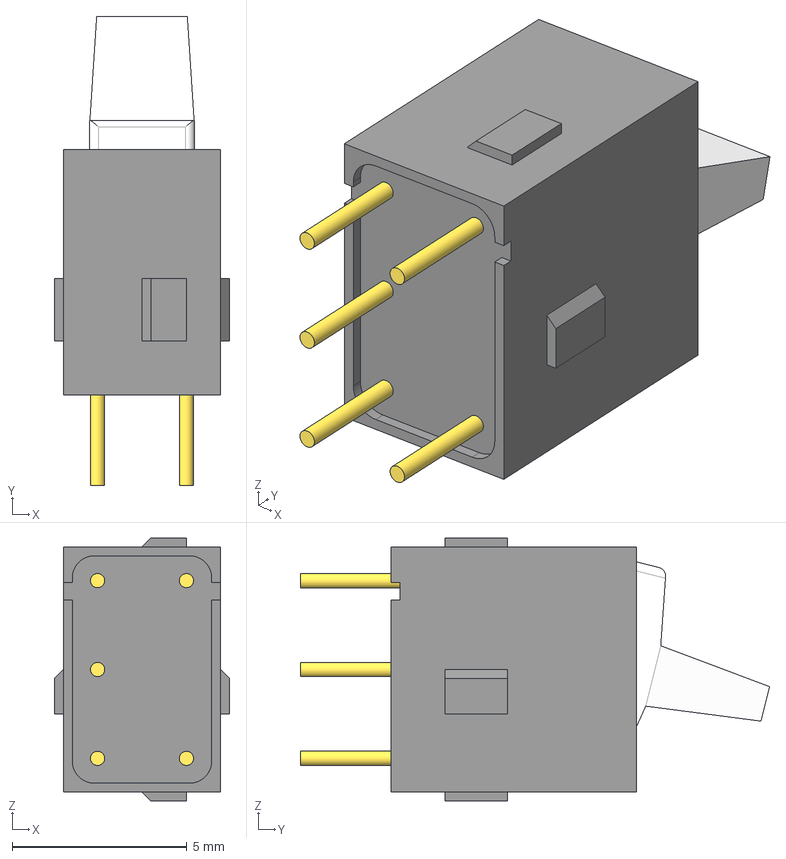
[picture p61: CAD file, 2025-02-11]
3D_Models/Switches/GW12LBP.STEP
5.00 x 13.4 x 7.52 mm
_GW1L-body-noill
_GW1P-terminals-noill
_GWLB-actuator-noill
