MEC-ETS/KiCad_Library/3D_Models/Assembly/mps_dcdc_oki_78sr_horiz_a.step

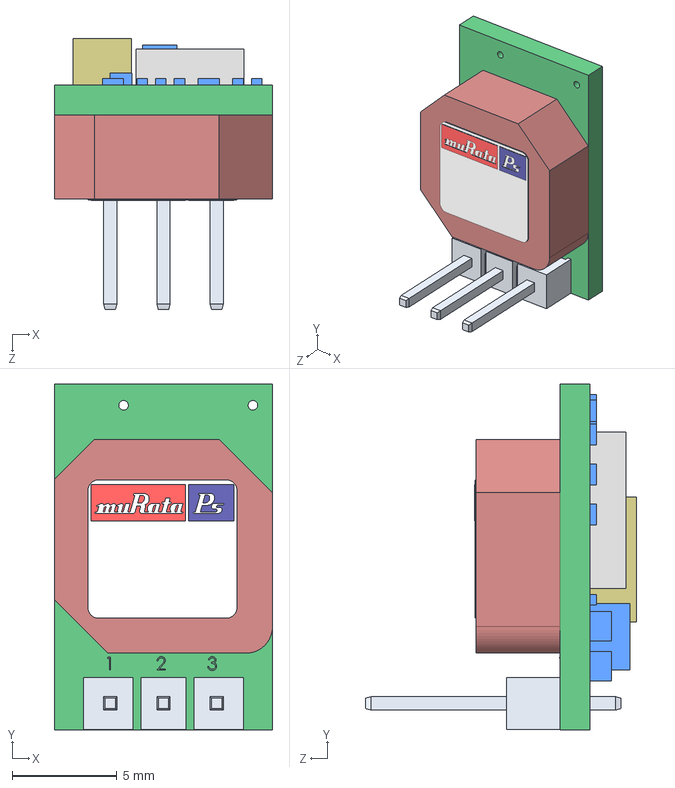
[picture p62: CAD file, 2025-02-11]
3D_Models/Assembly/mps_dcdc_oki_78sr_horiz_a.step
10.4 x 16.5 x 12.9 mm
