MEC-ETS/KiCad_Library/3D_Models/Capacitors/CAP_UCY_18X46_NCH.step

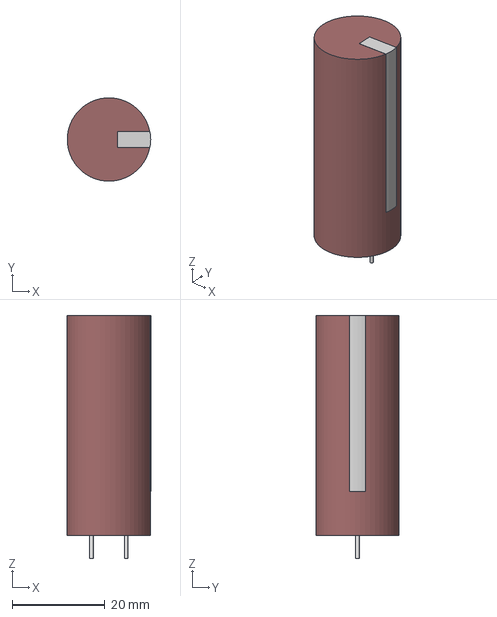
[picture p63: CAD file, 2025-02-11]
3D_Models/Capacitors/CAP_UCY_18X46_NCH.step
18.0 x 18.0 x 52.5 mm
