MEC-ETS/KiCad_Library/3D_Models/Diodes/D-FLAT.step

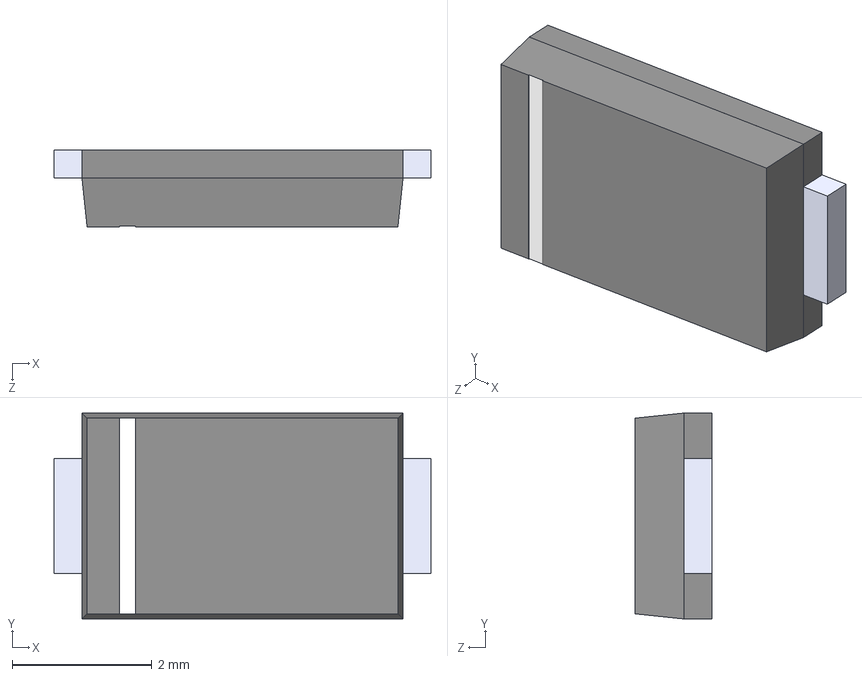
[picture p64: CAD file, 2025-02-11]
3D_Models/Diodes/D-FLAT.step
5.40 x 2.95 x 1.10 mm
