MEC-ETS/KiCad_Library/3D_Models/IC/TO-220_STM.step

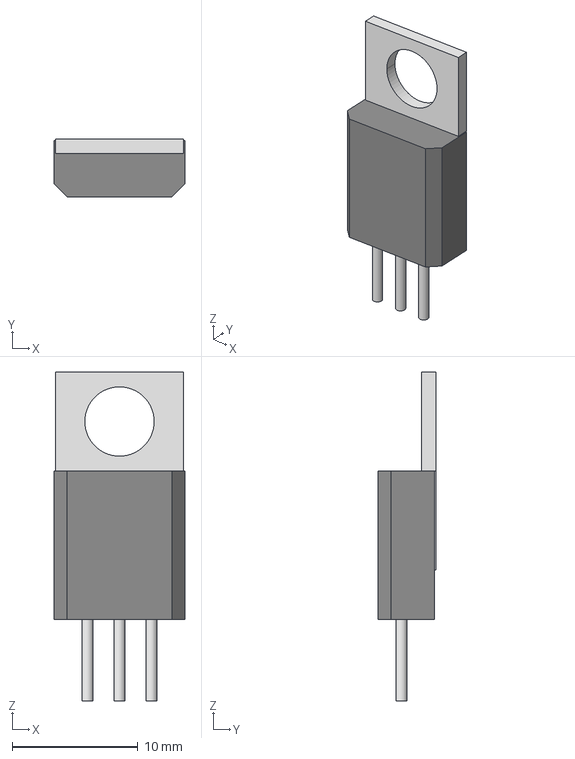
[picture p65: CAD file, 2025-03-04]
3D_Models/IC/TO-220_STM.step
10.4 x 4.60 x 26.2 mm
