MEC-ETS/KiCad_Library/3D_Models/Inductors/IND-1245.stp

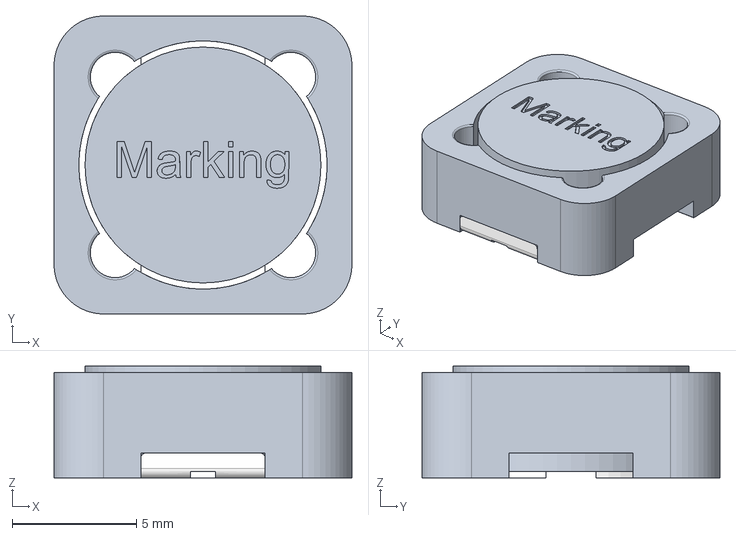
[picture p66: CAD file, 2025-02-11]
3D_Models/Inductors/IND-1245.stp
12.0 x 12.0 x 4.50 mm
