MEC-ETS/KiCad_Library/3D_Models/Resistors/T93YA.stp

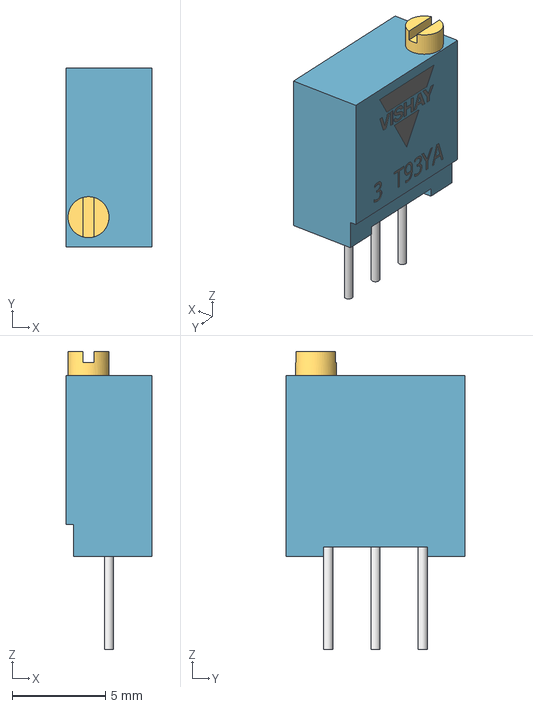
[picture p67: CAD file, 2025-02-11]
3D_Models/Resistors/T93YA.stp
4.60 x 9.60 x 16.0 mm
