MEC-ETS/KiCad_Library/3D_Models/Assembly/ACZ11BR4E.step

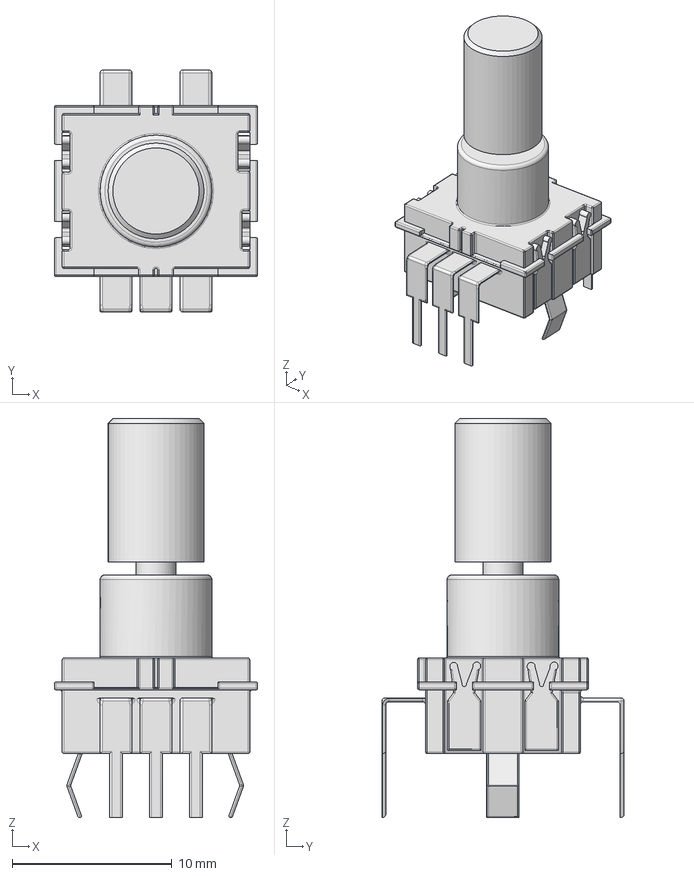
[picture p68: CAD file, 2025-02-11]
3D_Models/Assembly/ACZ11BR4E.step
12.8 x 15.2 x 25.0 mm
