MEC-ETS/KiCad_Library/3D_Models/Capacitors/CapAluRadial_D100H125P50.STEP

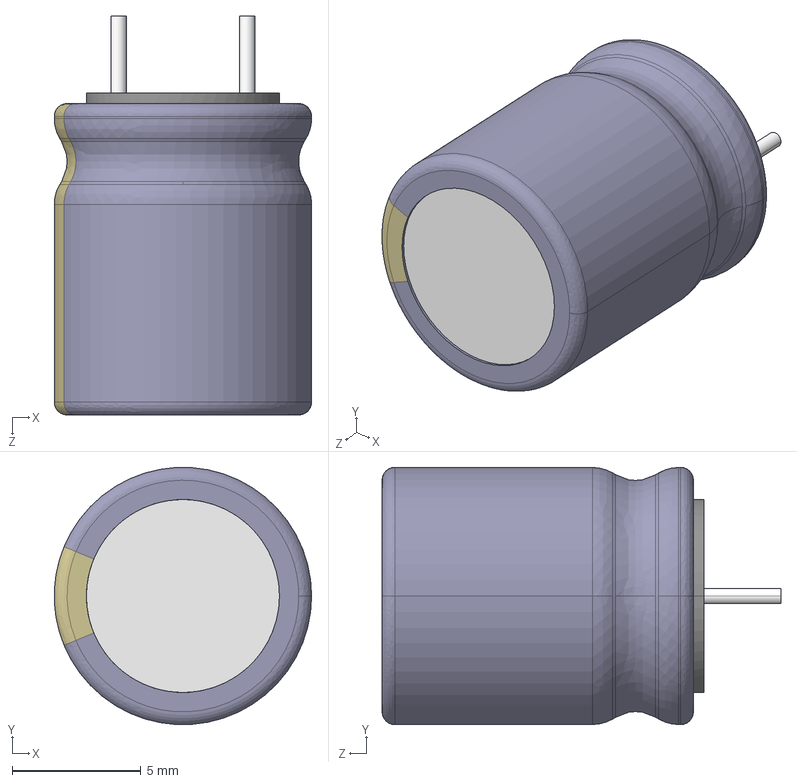
[picture p69: CAD file, 2025-02-11]
3D_Models/Capacitors/CapAluRadial_D100H125P50.STEP
9.99 x 9.99 x 15.5 mm
