MEC-ETS/KiCad_Library/3D_Models/Diodes/TO-277A.STEP

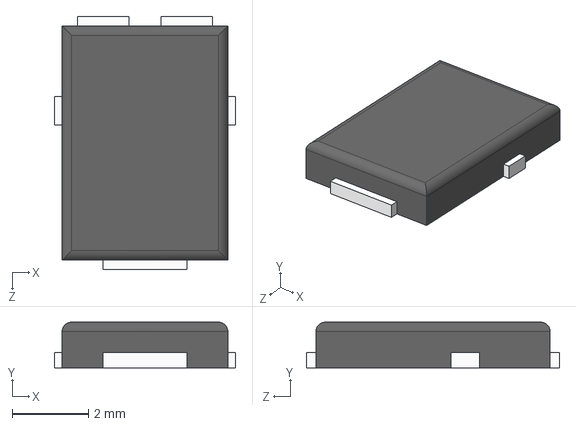
[picture p70: CAD file, 2025-02-11]
3D_Models/Diodes/TO-277A.STEP
4.75 x 1.20 x 6.65 mm
