MEC-ETS/KiCad_Library/3D_Models/IC/DBV0006A.stp

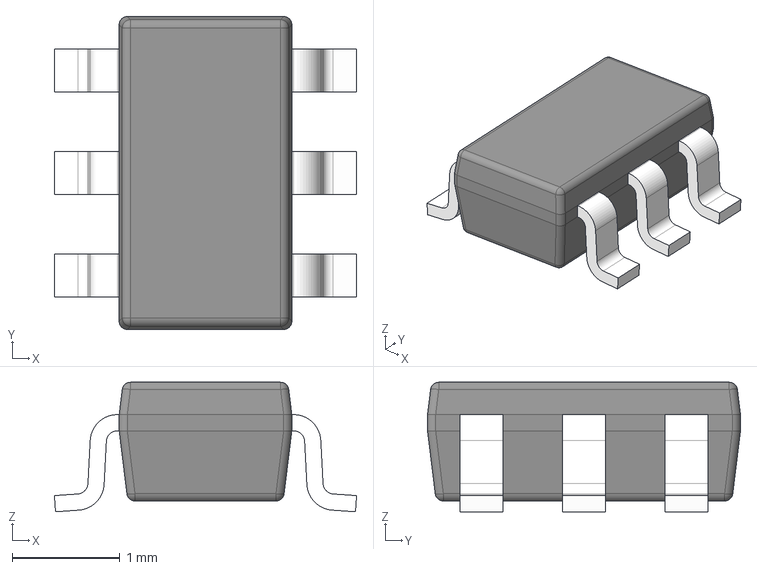
[picture p71: CAD file, 2025-03-04]
3D_Models/IC/DBV0006A.stp
2.80 x 2.90 x 1.20 mm
BODY-SOT
LEAD-SOT x 6
