MEC-ETS/KiCad_Library/3D_Models/Inductors/I0805.step

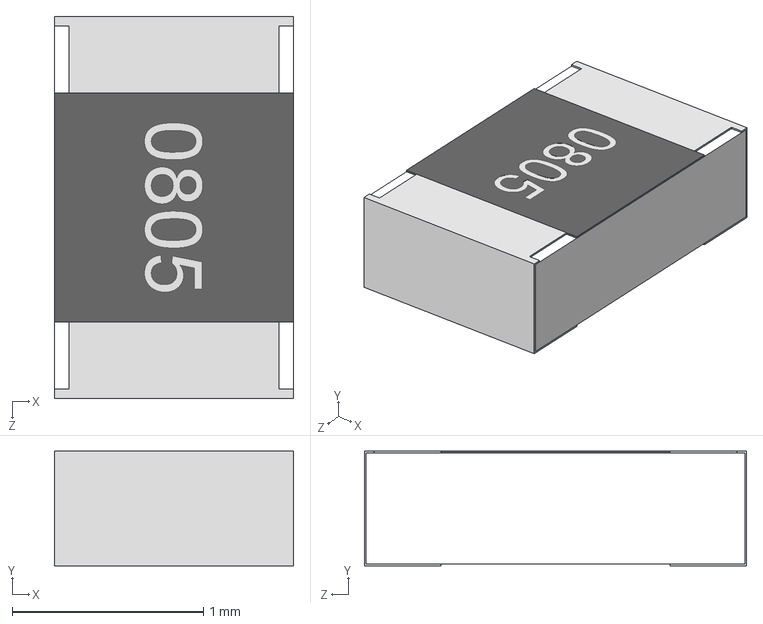
[picture p72: CAD file, 2025-02-11]
3D_Models/Inductors/I0805.step
1.25 x 0.6 x 2.00 mm
