MEC-ETS/KiCad_Library/3D_Models/Relays/c-9-1393792-0-c-3d.stp

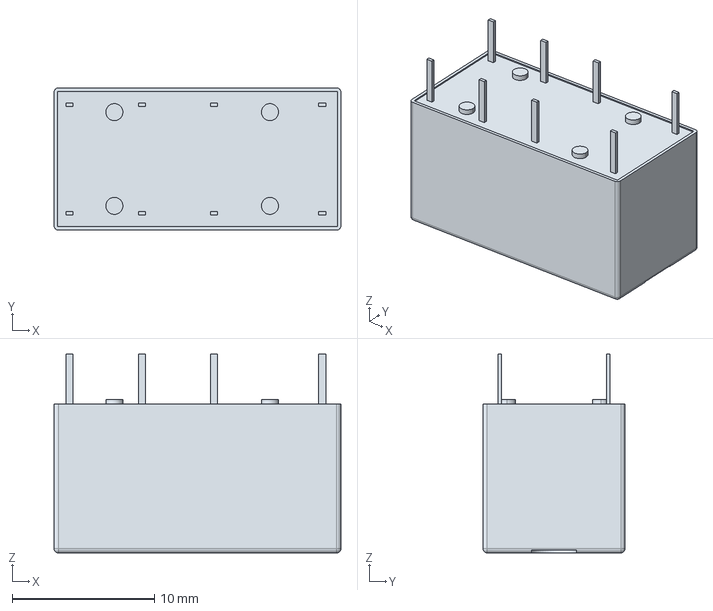
[picture p73: CAD file, 2025-02-11]
3D_Models/Relays/c-9-1393792-0-c-3d.stp
20.2 x 10.0 x 14.0 mm
