MEC-ETS/KiCad_Library/3D_Models/Switches/GW12LJPCF.stp

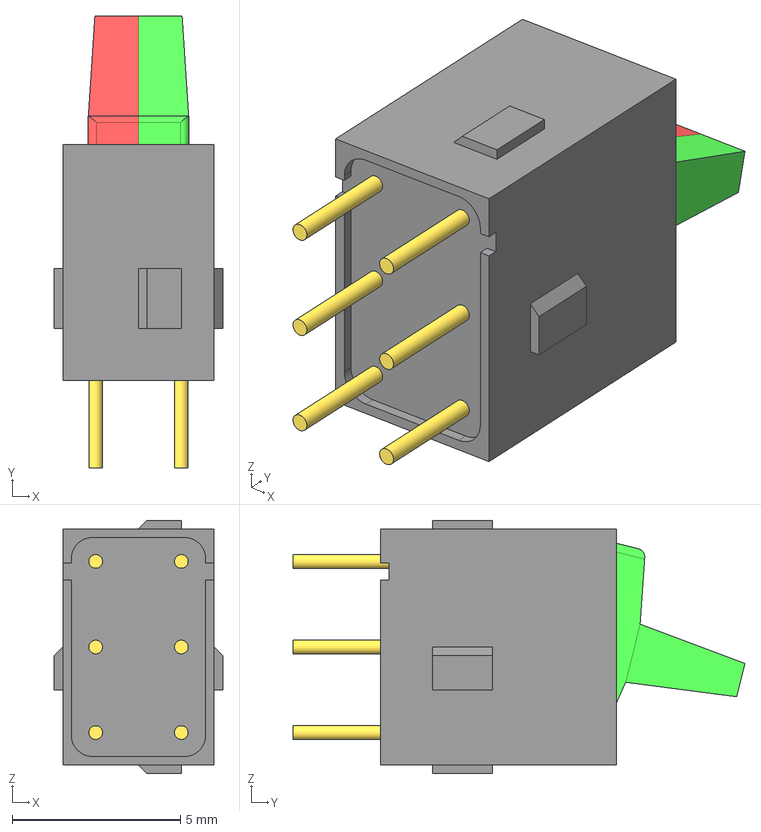
[picture p74: CAD file, 2025-02-11]
3D_Models/Switches/GW12LJPCF.stp
5.00 x 13.4 x 7.52 mm
_GW1-body
_GWP-terminals
_GWCF-act_green
_GWCF-act_red
