MEC-ETS/KiCad_Library/3D_Models/Assembly/ACZ09BRXE.STEP

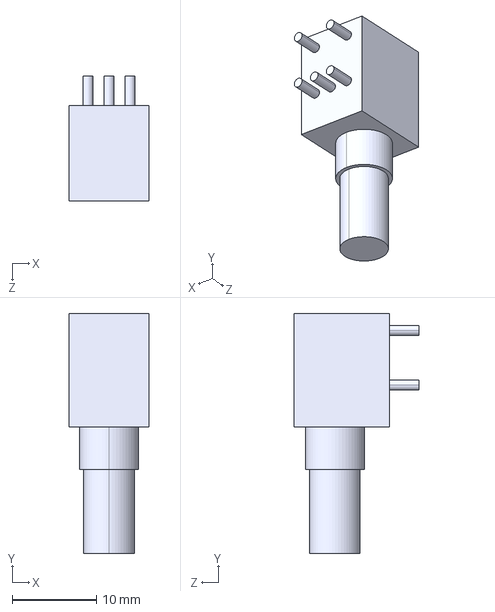
[picture p75: CAD file, 2025-02-11]
3D_Models/Assembly/ACZ09BRXE.STEP
9.50 x 28.5 x 14.8 mm
