MEC-ETS/KiCad_Library/3D_Models/Capacitors/C0603.stp

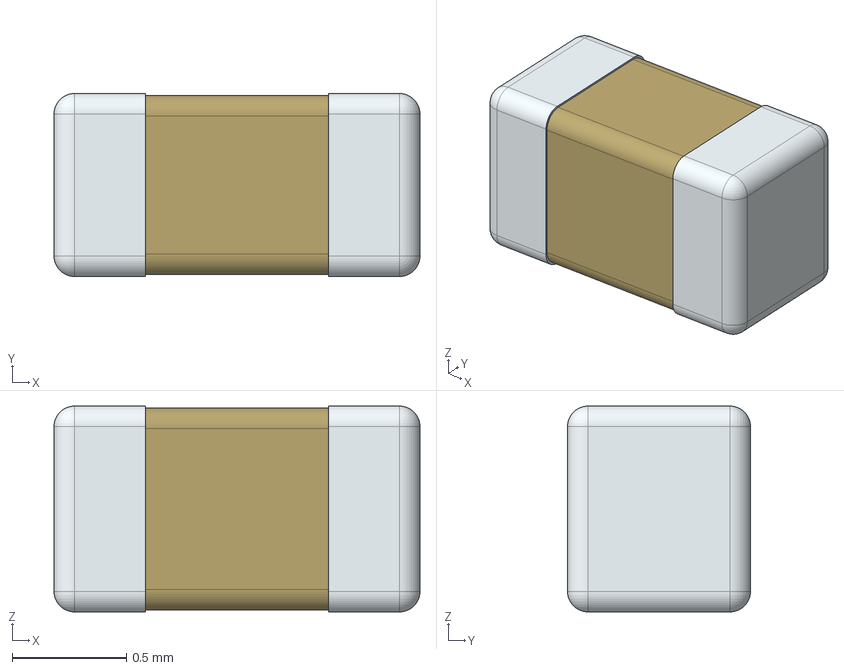
[picture p76: CAD file, 2025-02-11]
3D_Models/Capacitors/C0603.stp
1.60 x 0.8 x 0.9 mm
