MEC-ETS/KiCad_Library/3D_Models/Diodes/DIO_RFU02VS_ROM.step

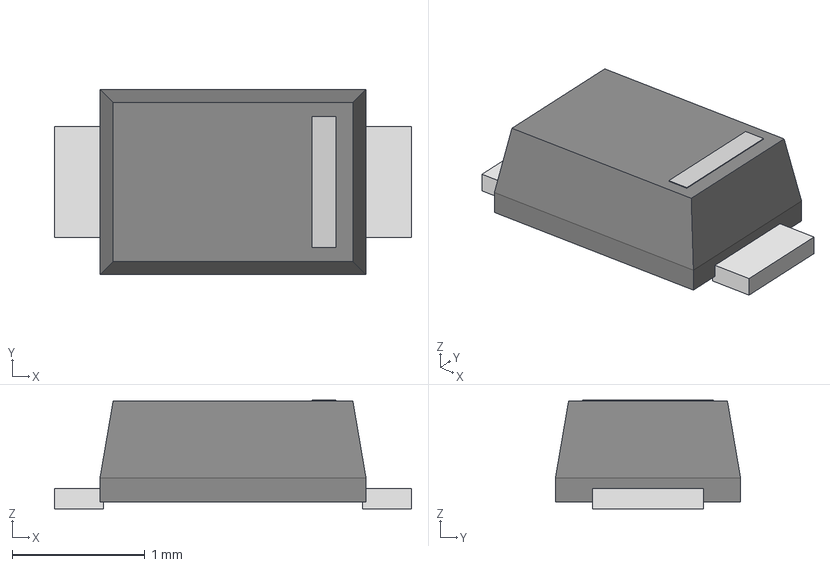
[picture p77: CAD file, 2025-02-11]
3D_Models/Diodes/DIO_RFU02VS_ROM.step
2.69 x 1.40 x 0.819 mm
