MEC-ETS/KiCad_Library/3D_Models/IC/SOIC8_4P9X3P9MC_MCH.step

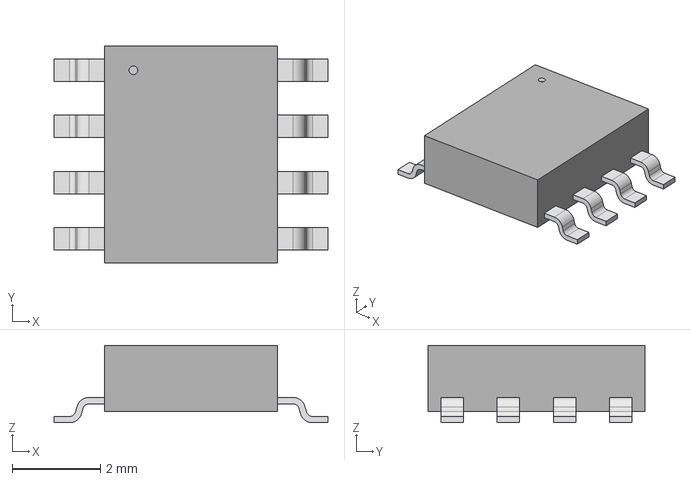
[picture p78: CAD file, 2025-02-28]
3D_Models/IC/SOIC8_4P9X3P9MC_MCH.step
6.20 x 4.90 x 1.75 mm
