MEC-ETS/KiCad_Library/3D_Models/Inductors/LBC3225.stp

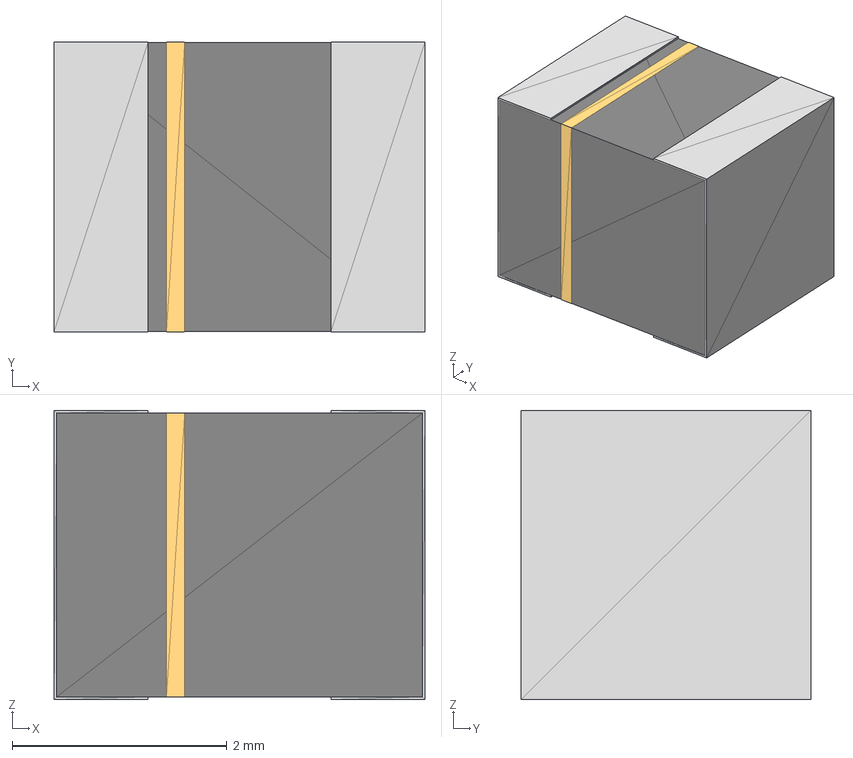
[picture p79: CAD file, 2025-02-11]
3D_Models/Inductors/LBC3225.stp
3.45 x 2.70 x 2.69 mm
