MEC-ETS/KiCad_Library/3D_Models/Relays/G5CA-1A-E-DC24.stp

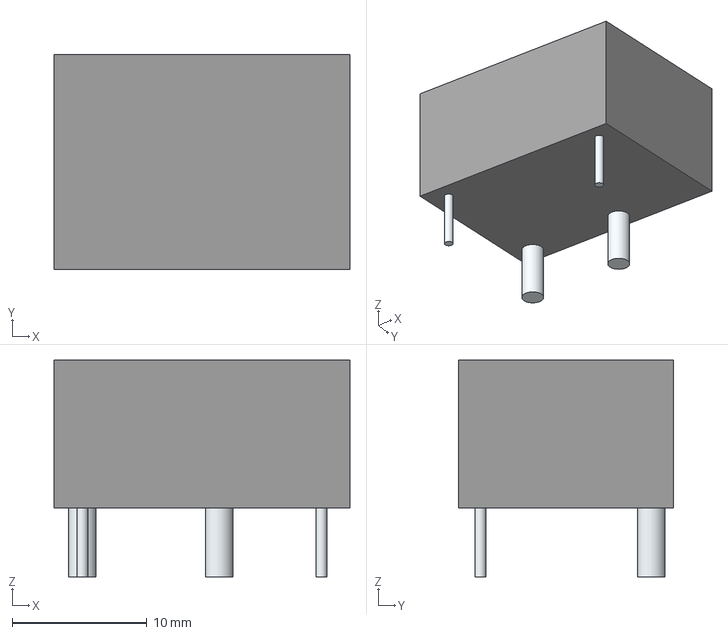
[picture p80: CAD file, 2025-02-11]
3D_Models/Relays/G5CA-1A-E-DC24.stp
22.0 x 16.0 x 16.1 mm
Leads
