MEC-ETS/KiCad_Library/3D_Models/Resistors/R2512.step

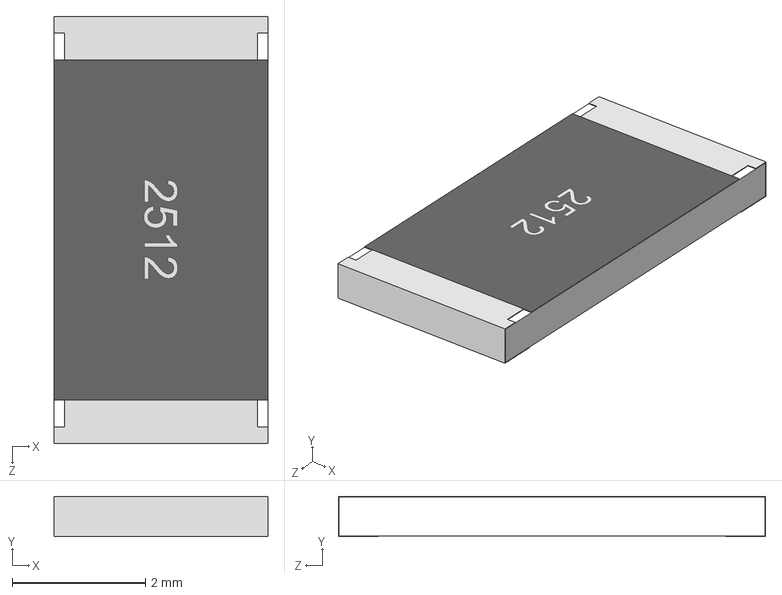
[picture p81: CAD file, 2025-02-11]
3D_Models/Resistors/R2512.step
3.20 x 0.6 x 6.40 mm
