MEC-ETS/KiCad_Library/3D_Models/Assembly/antenna_WiFi_RP-SMA_conn.step

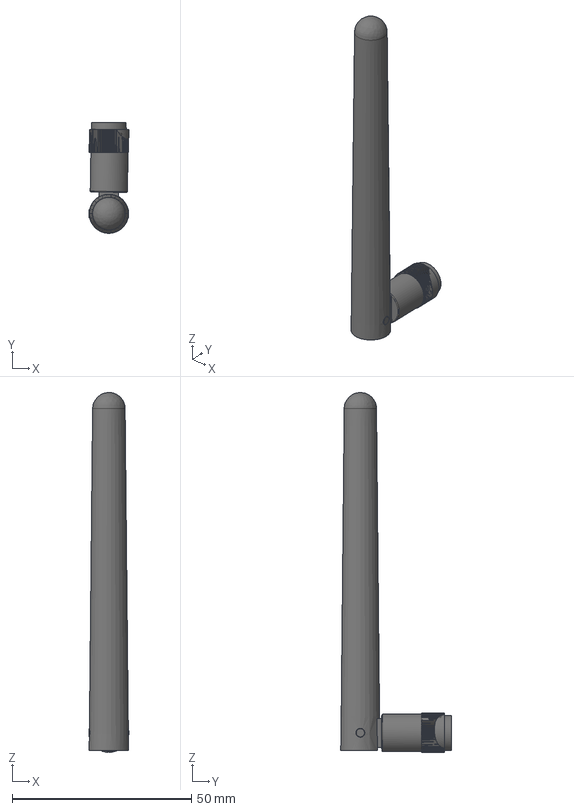
[picture p82: CAD file, 2025-02-11]
3D_Models/Assembly/antenna_WiFi_RP-SMA_conn.step
11.1 x 30.9 x 100.5 mm
ant
conn_body
SMA_threads
socket
