MEC-ETS/KiCad_Library/3D_Models/Capacitors/E-CAP 1500UF_SUNCON.STEP

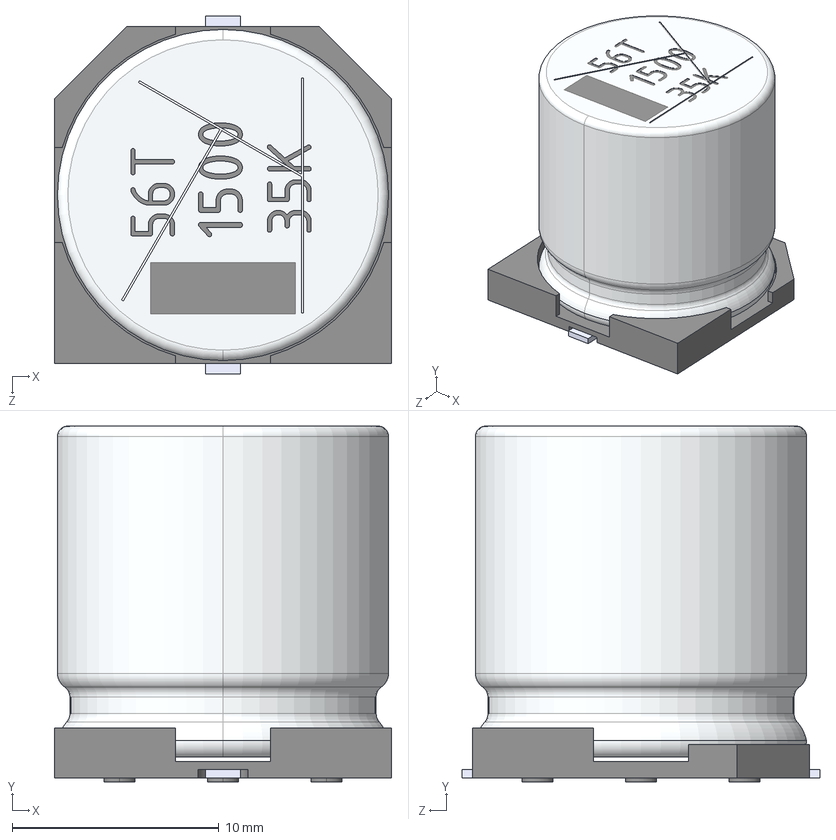
[picture p83: CAD file, 2025-02-11]
3D_Models/Capacitors/E-CAP 1500UF_SUNCON.STEP
16.3 x 17.2 x 17.3 mm
