MEC-ETS/KiCad_Library/3D_Models/Connectors/XT60PW MALE.STEP

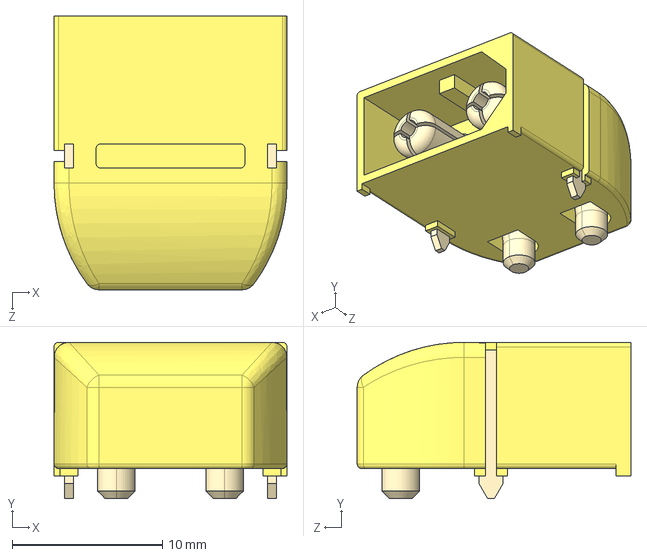
[picture p84: CAD file, 2025-03-14]
3D_Models/Connectors/XT60PW MALE.STEP
15.5 x 10.4 x 18.2 mm
