MEC-ETS/KiCad_Library/3D_Models/Diodes/R-6.step

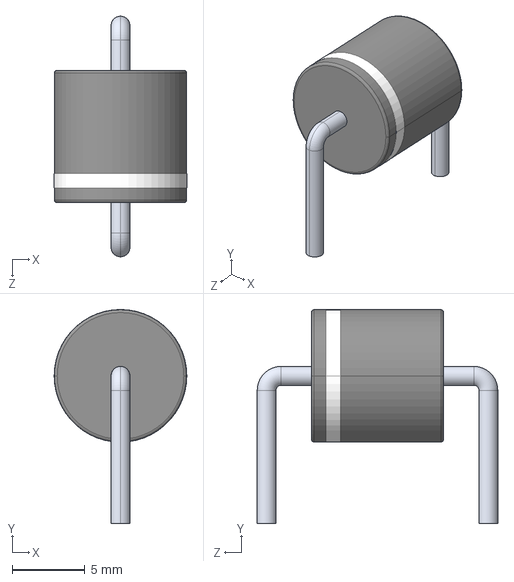
[picture p85: CAD file, 2025-02-11]
3D_Models/Diodes/R-6.step
9.12 x 14.7 x 16.5 mm
