MEC-ETS/KiCad_Library/3D_Models/IC/SOIC-20-300.STEP

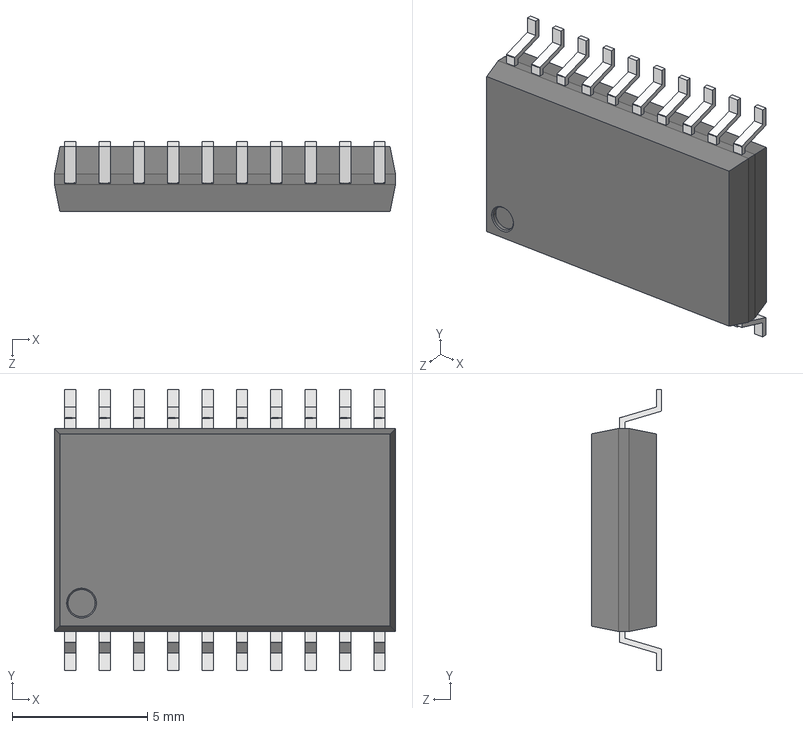
[picture p86: CAD file, 2025-02-11]
3D_Models/IC/SOIC-20-300.STEP
12.6 x 10.4 x 2.60 mm
User Library-SOIC_20-300_pino1
User Library-SOIC_20-300_pino002
User Library-SOIC_20-300_pino003
User Library-SOIC_20-300_pino004
User Library-SOIC_20-300_pino005
User Library-SOIC_20-300_pino006
User Library-SOIC_20-300_pino007
User Library-SOIC_20-300_pino008
User Library-SOIC_20-300_pino009
User Library-SOIC_20-300_pino010
User Library-SOIC_20-300_pino015
User Library-SOIC_20-300_pino016
User Library-SOIC_20-300_pino017
User Library-SOIC_20-300_pino018
User Library-SOIC_20-300_pino019
User Library-SOIC_20-300_pino020
User Library-SOIC_20-300_pino021
User Library-SOIC_20-300_pino022
User Library-SOIC_20-300_pino023
User Library-SOIC_20-300_pino024
User Library-SOIC_20-300_body_finished
