MEC-ETS/KiCad_Library/3D_Models/Relays/J104D2C24VDC.20S.stp

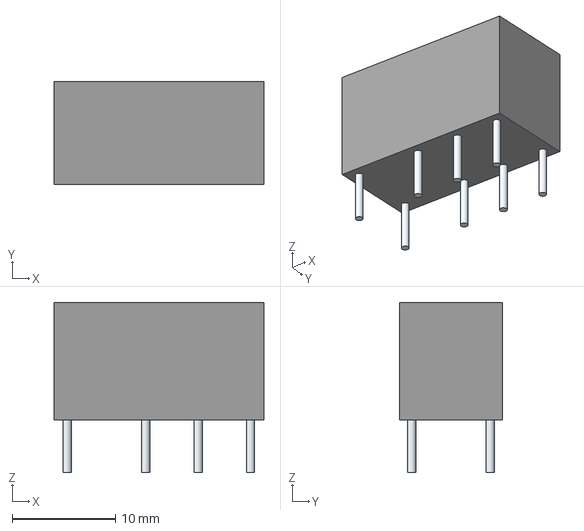
[picture p87: CAD file, 2025-02-11]
3D_Models/Relays/J104D2C24VDC.20S.stp
20.4 x 9.97 x 16.5 mm
Leads
