MEC-ETS/KiCad_Library/3D_Models/Resistors/R0603.step

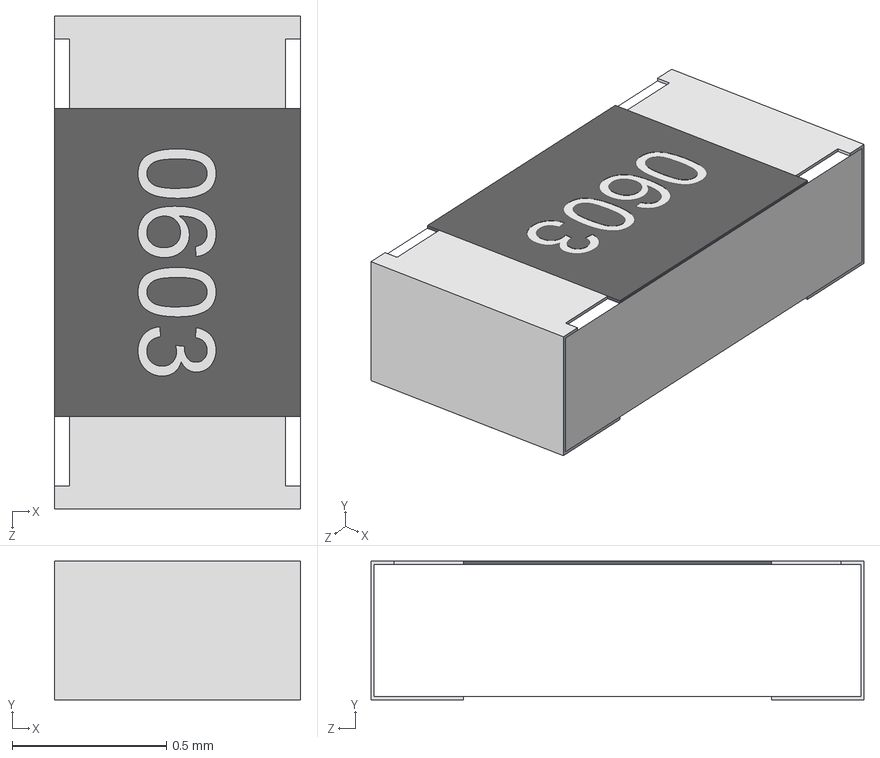
[picture p88: CAD file, 2025-02-11]
3D_Models/Resistors/R0603.step
0.8 x 0.45 x 1.60 mm
