MEC-ETS/KiCad_Library/3D_Models/Switches/K12PBK15N.step

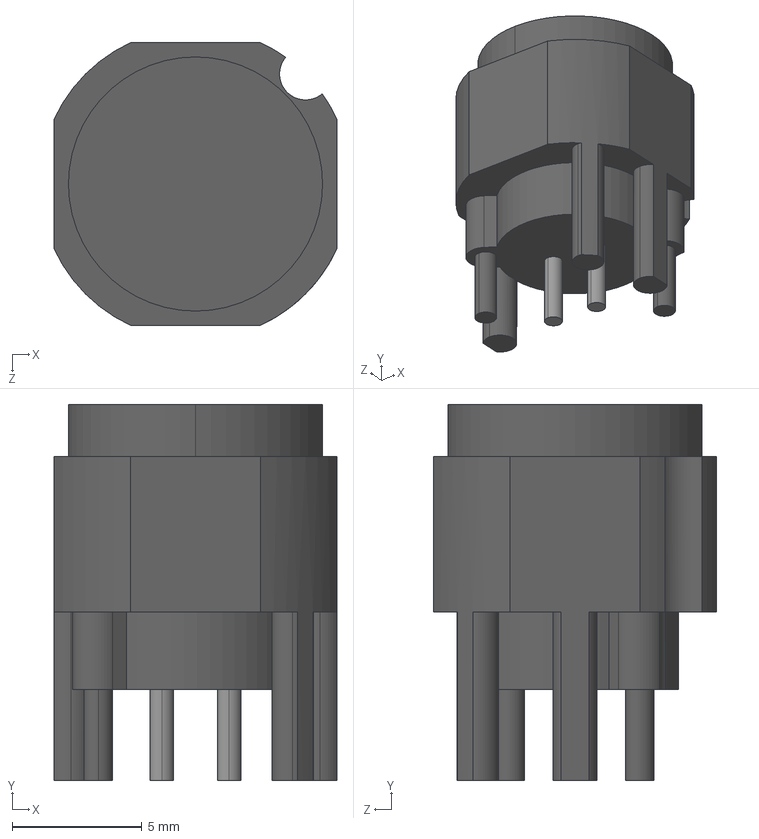
[picture p89: CAD file, 2025-02-11]
3D_Models/Switches/K12PBK15N.step
10.9 x 14.5 x 10.9 mm
