MEC-ETS/KiCad_Library/3D_Models/Assembly/pqmc3.stp

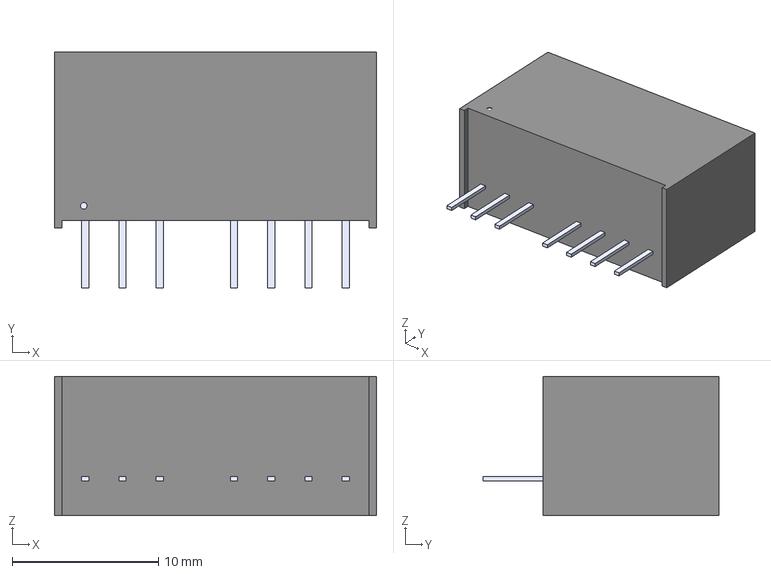
[picture p90: CAD file, 2025-02-11]
3D_Models/Assembly/pqmc3.stp
22.0 x 16.1 x 9.50 mm
