MEC-ETS/KiCad_Library/3D_Models/Capacitors/C1210.step

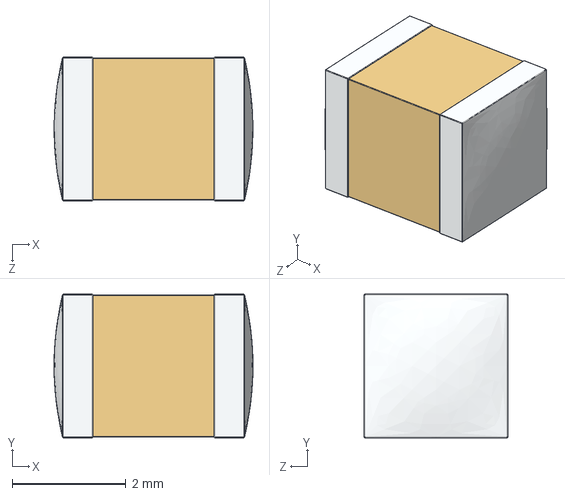
[picture p91: CAD file, 2025-02-11]
3D_Models/Capacitors/C1210.step
3.50 x 2.52 x 2.53 mm
