MEC-ETS/KiCad_Library/3D_Models/Connectors/B2B-XH-A.step

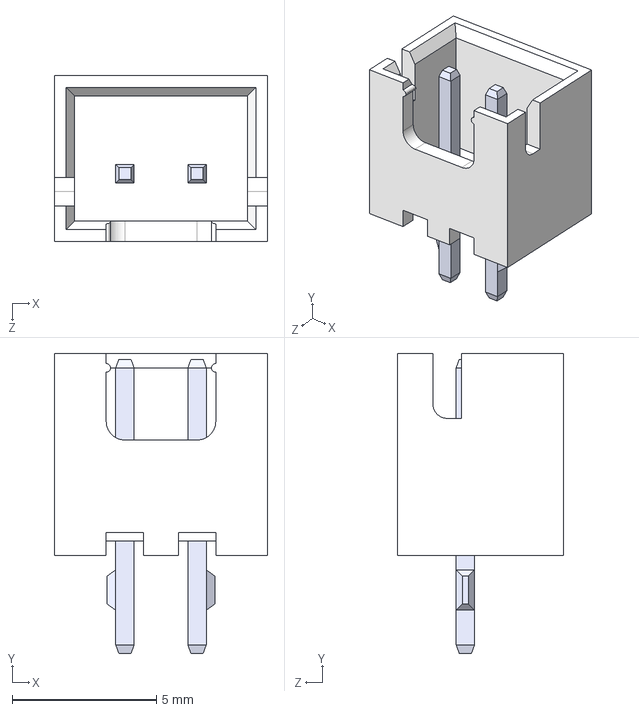
[picture p92: CAD file, 2025-03-13]
3D_Models/Connectors/B2B-XH-A.step
7.40 x 10.4 x 5.75 mm
