MEC-ETS/KiCad_Library/3D_Models/Diodes/SOD-523.step

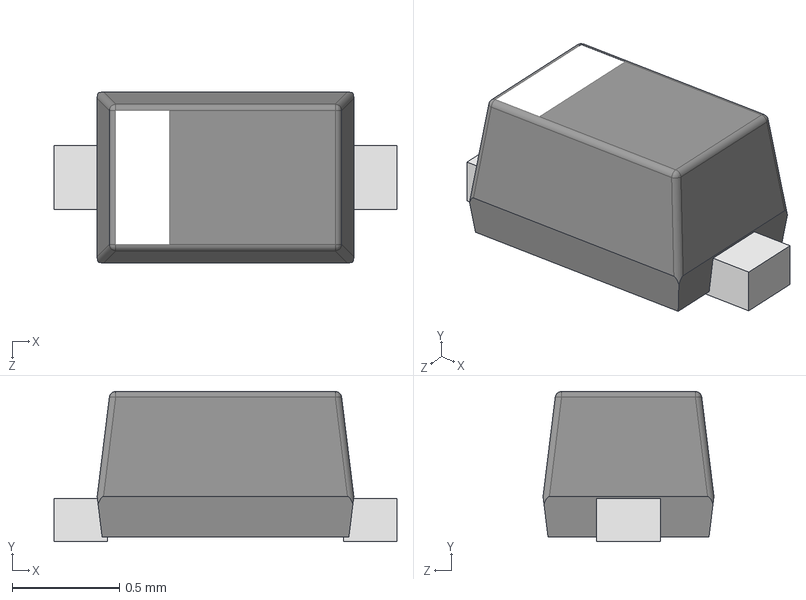
[picture p93: CAD file, 2025-02-11]
3D_Models/Diodes/SOD-523.step
1.60 x 0.7 x 0.798 mm
