MEC-ETS/KiCad_Library/3D_Models/IC/4-SOP.step

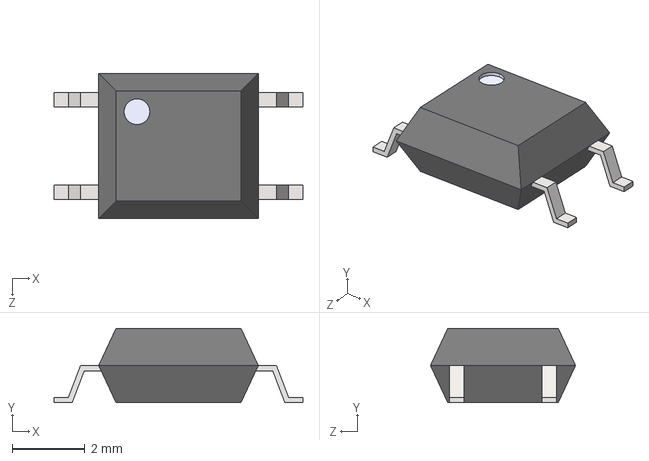
[picture p94: CAD file, 2025-02-11]
3D_Models/IC/4-SOP.step
6.86 x 2.05 x 4.00 mm
