MEC-ETS/KiCad_Library/3D_Models/Inductors/IND_8095-WE-TI_8p3x10x5_WRE.step

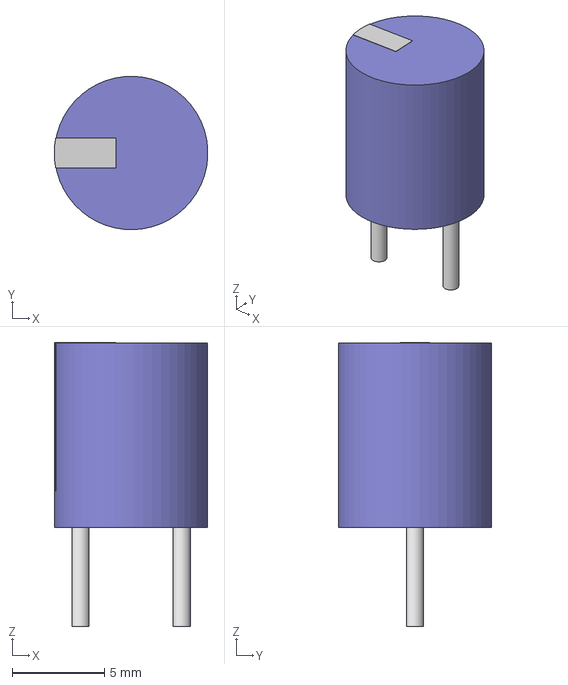
[picture p95: CAD file, 2025-02-11]
3D_Models/Inductors/IND_8095-WE-TI_8p3x10x5_WRE.step
8.31 x 8.30 x 15.4 mm
