MEC-ETS/KiCad_Library/3D_Models/Relays/ALQ112.stp

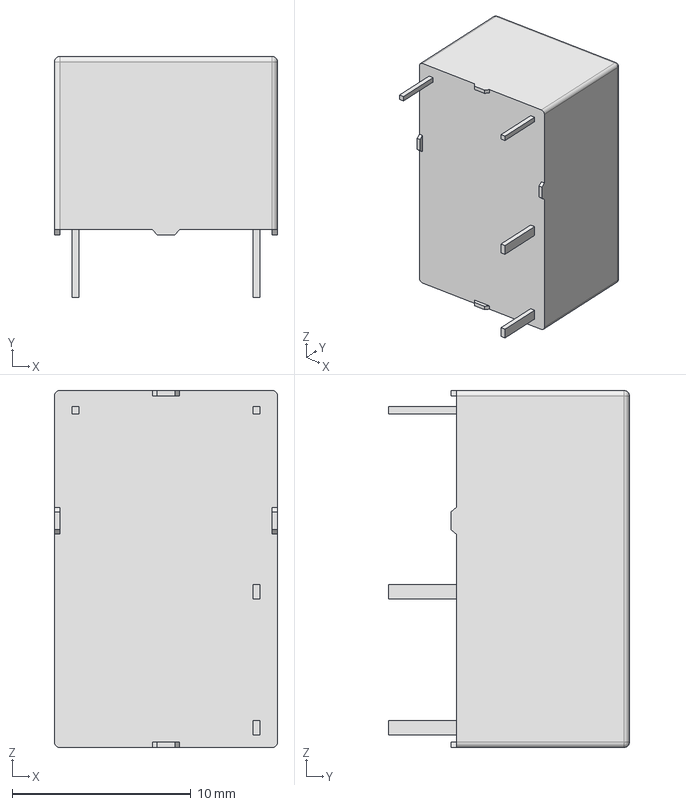
[picture p96: CAD file, 2025-02-11]
3D_Models/Relays/ALQ112.stp
12.5 x 13.5 x 20.0 mm
