MEC-ETS/KiCad_Library/3D_Models/Resistors/ohmite_TWW5J39RE.stp

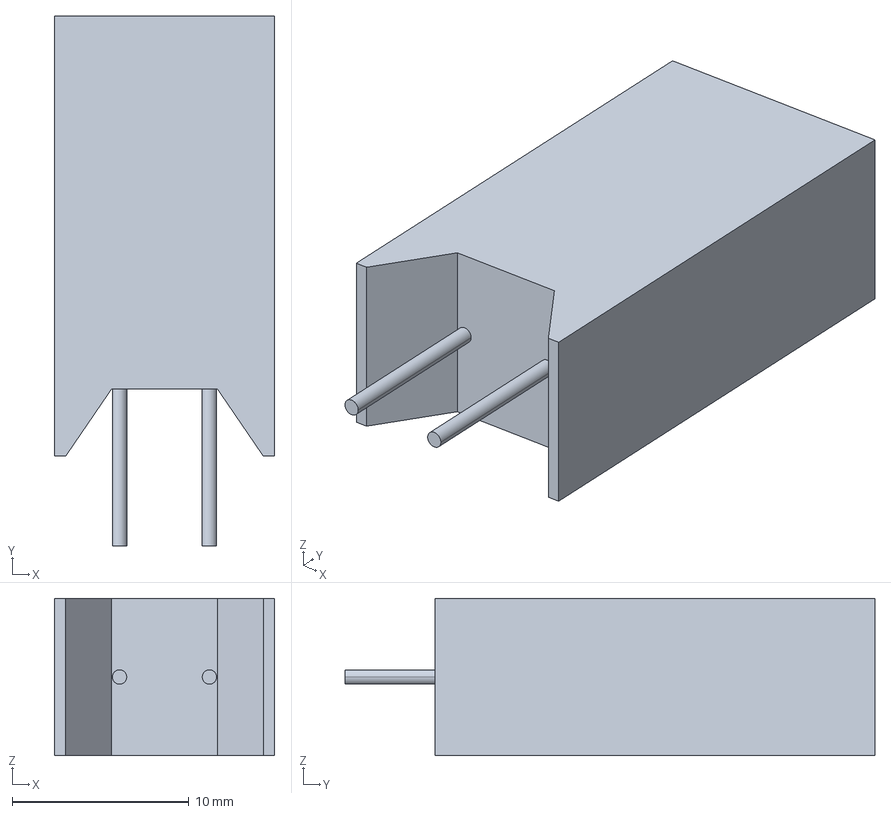
[picture p97: CAD file, 2025-02-11]
3D_Models/Resistors/ohmite_TWW5J39RE.stp
12.4 x 30.0 x 8.89 mm
