MEC-ETS/KiCad_Library/3D_Models/Assembly/mps_dcdc_oki_78sr_vert_a.step

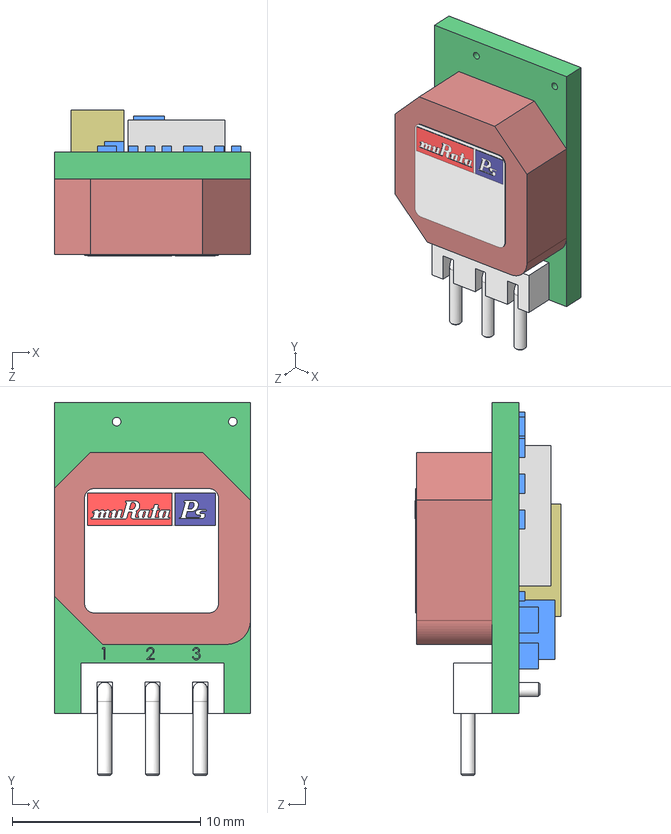
[picture p98: CAD file, 2025-02-11]
3D_Models/Assembly/mps_dcdc_oki_78sr_vert_a.step
10.4 x 19.8 x 7.73 mm
