MEC-ETS/KiCad_Library/3D_Models/Capacitors/CapAluRadial_D125H200P50.STEP

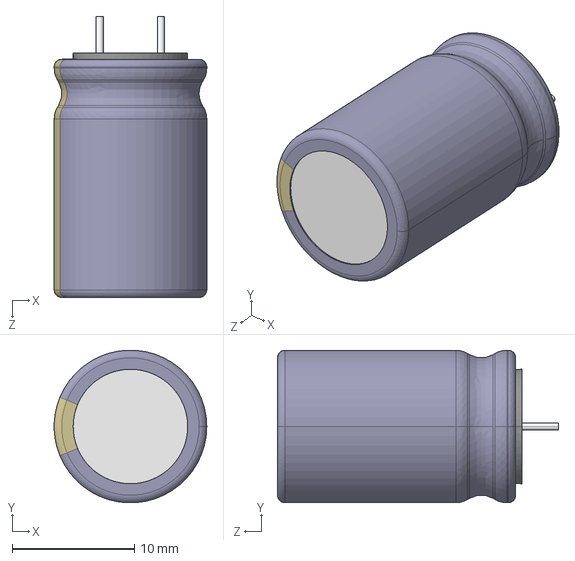
[picture p99: CAD file, 2025-02-11]
3D_Models/Capacitors/CapAluRadial_D125H200P50.STEP
12.5 x 12.5 x 23.0 mm
