MEC-ETS/KiCad_Library/3D_Models/Connectors/B5B-XH-A.step

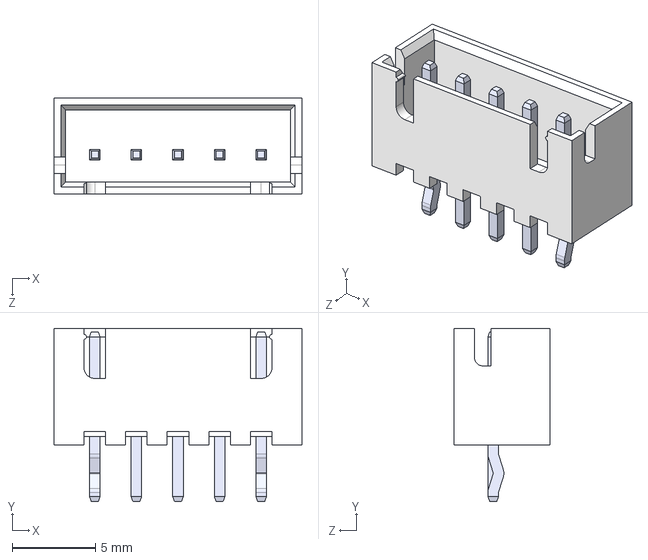
[picture p100: CAD file, 2025-03-13]
3D_Models/Connectors/B5B-XH-A.step
14.9 x 10.4 x 5.75 mm
