MEC-ETS/KiCad_Library/3D_Models/Diodes/SP0503BAHTG.step

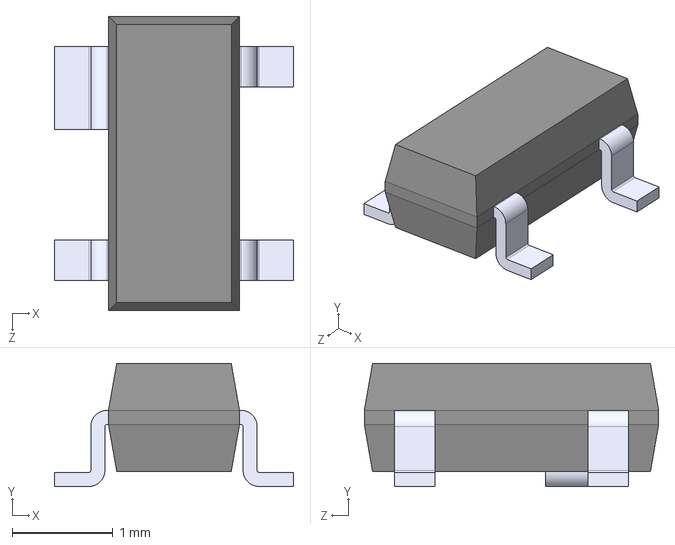
[picture p101: CAD file, 2025-02-11]
3D_Models/Diodes/SP0503BAHTG.step
2.37 x 1.22 x 2.92 mm
