MEC-ETS/KiCad_Library/3D_Models/IC/mps_dcdc_cre1s_sc_a.step

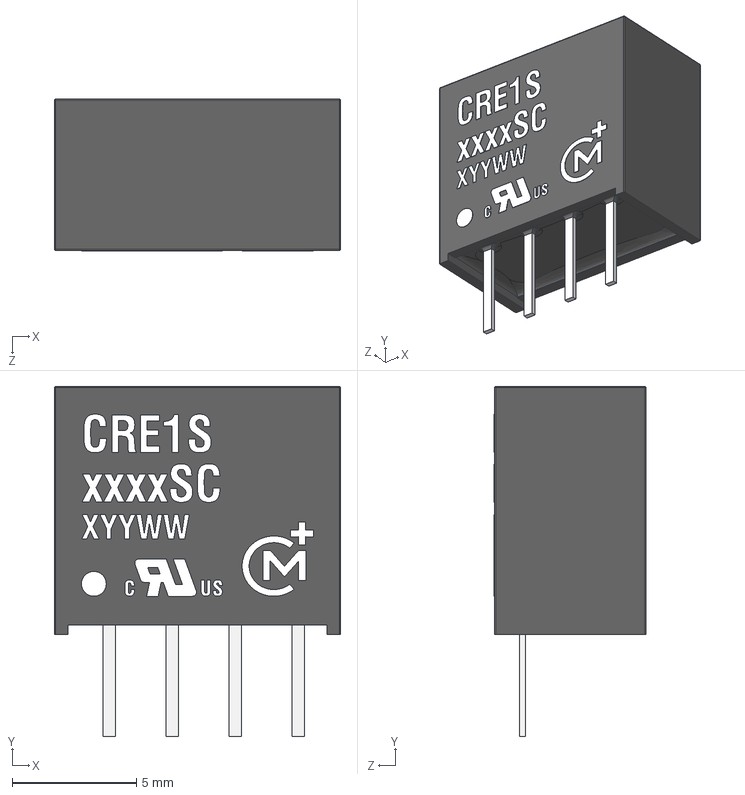
[picture p102: CAD file, 2025-02-11]
3D_Models/IC/mps_dcdc_cre1s_sc_a.step
11.5 x 14.1 x 6.12 mm
