MEC-ETS/KiCad_Library/3D_Models/Inductors/WE-RCIT-7847121020.stp

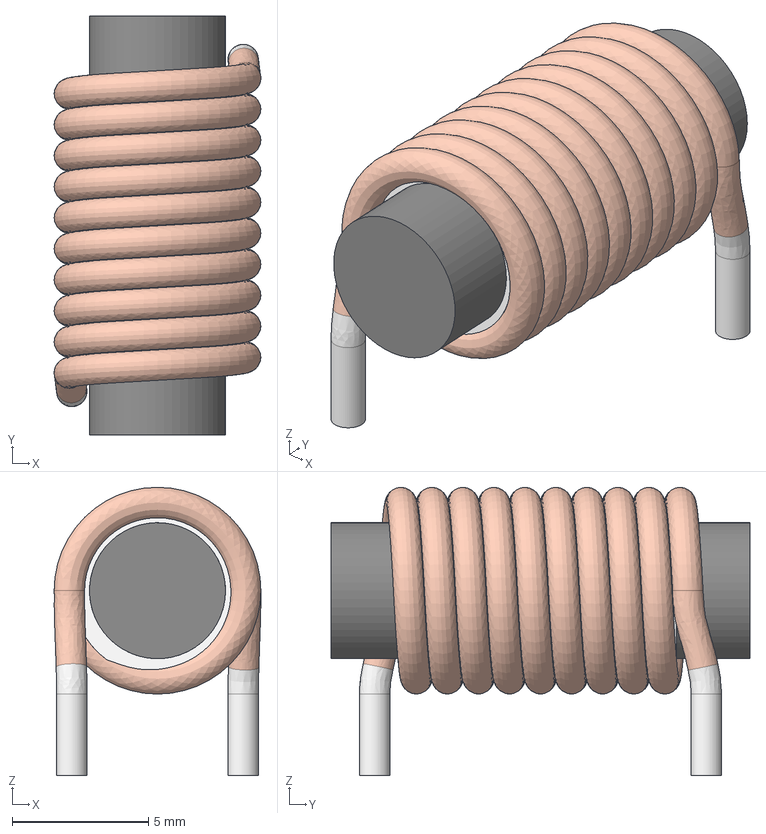
[picture p103: CAD file, 2025-02-11]
3D_Models/Inductors/WE-RCIT-7847121020.stp
7.60 x 15.4 x 10.6 mm
core
coil
glue
