MEC-ETS/KiCad_Library/3D_Models/Relays/9007-12-01.stp

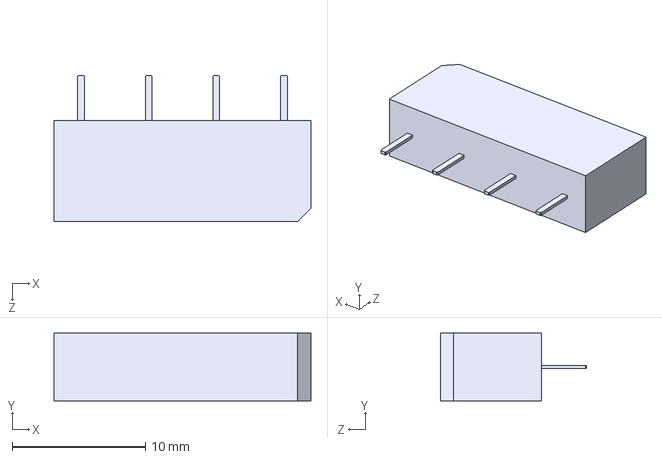
[picture p104: CAD file, 2025-02-11]
3D_Models/Relays/9007-12-01.stp
19.3 x 5.08 x 11.0 mm
