MEC-ETS/KiCad_Library/3D_Models/Resistors/R0402.step

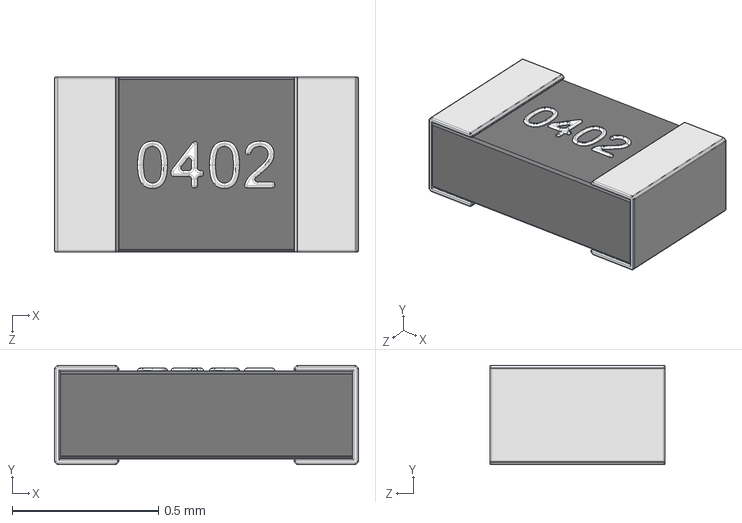
[picture p105: CAD file, 2025-02-11]
3D_Models/Resistors/R0402.step
1.04 x 0.34 x 0.6 mm
