MEC-ETS/KiCad_Library/3D_Models/Assembly/ACZ11BR1E-15KQA1-12C.stp

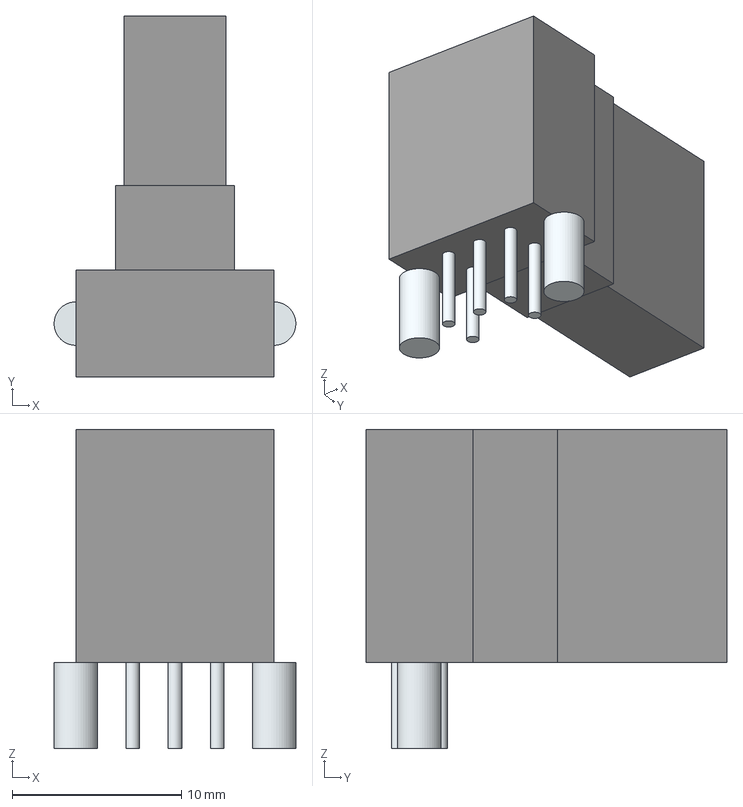
[picture p106: CAD file, 2025-02-11]
3D_Models/Assembly/ACZ11BR1E-15KQA1-12C.stp
14.3 x 21.3 x 18.9 mm
Leads x 7
