MEC-ETS/KiCad_Library/3D_Models/Capacitors/CAP_SLPX_C1_CND.step

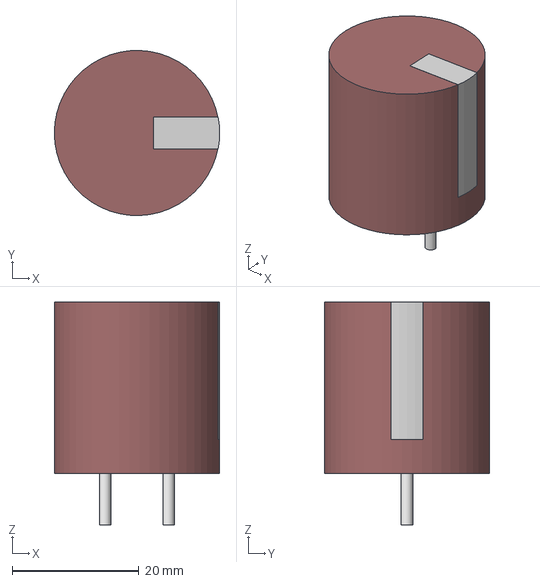
[picture p107: CAD file, 2025-02-11]
3D_Models/Capacitors/CAP_SLPX_C1_CND.step
26.0 x 26.0 x 35.1 mm
