MEC-ETS/KiCad_Library/3D_Models/Connectors/B3B-XH-A.step

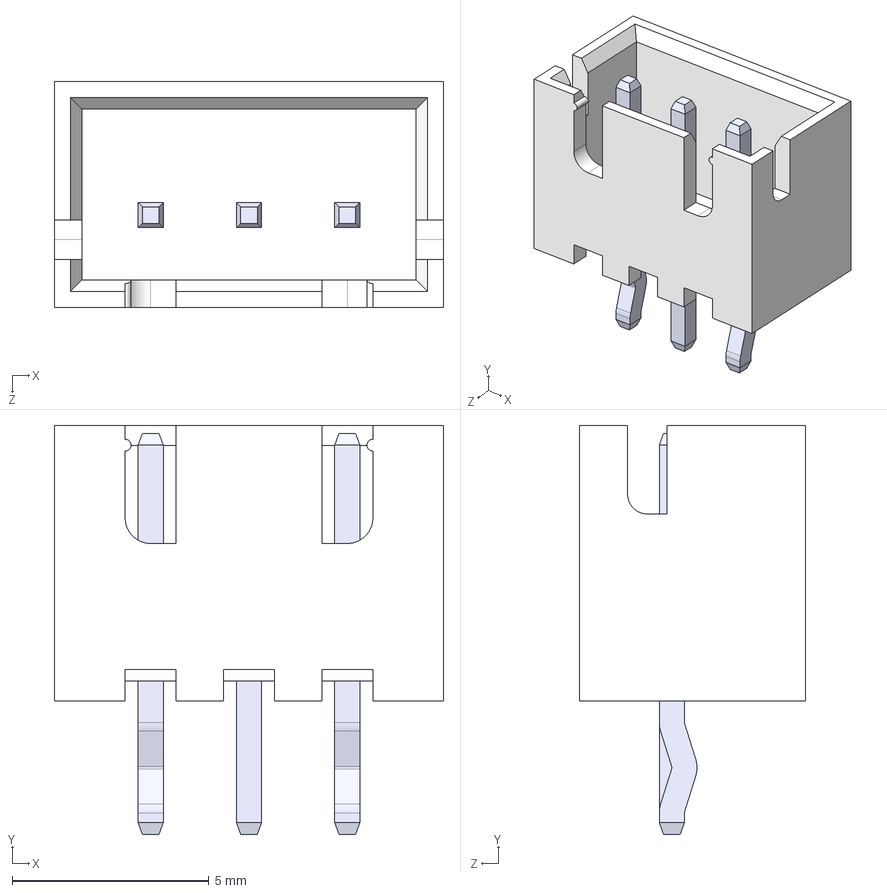
[picture p108: CAD file, 2025-03-13]
3D_Models/Connectors/B3B-XH-A.step
9.90 x 10.4 x 5.75 mm
