MEC-ETS/KiCad_Library/3D_Models/Diodes/SMASeries_LTF.step

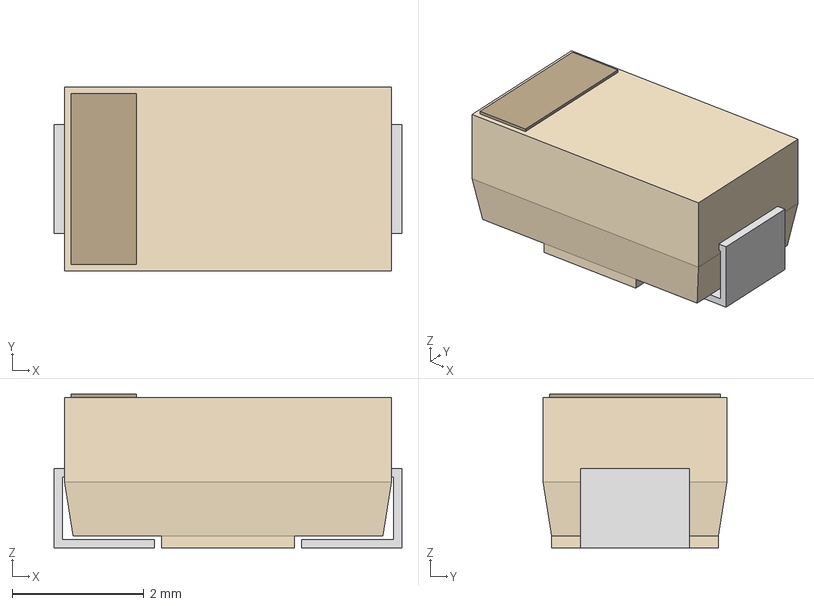
[picture p109: CAD file, 2025-02-11]
3D_Models/Diodes/SMASeries_LTF.step
5.28 x 2.79 x 2.34 mm
