MEC-ETS/KiCad_Library/3D_Models/IC/QFN24_4X4_SIL.step

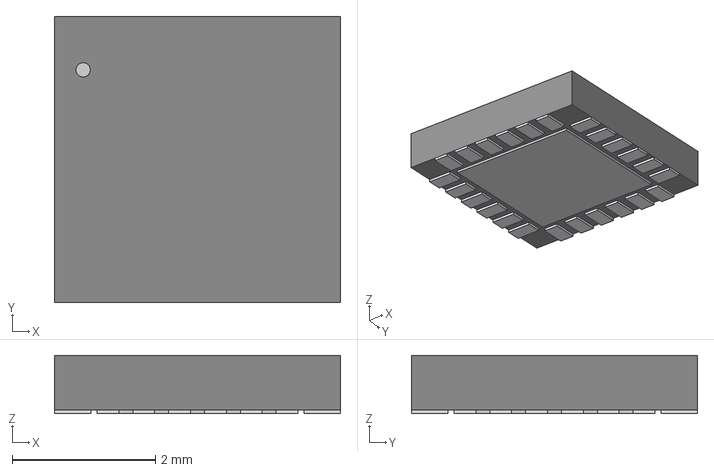
[picture p110: CAD file, 2025-02-11]
3D_Models/IC/QFN24_4X4_SIL.step
3.99 x 3.99 x 0.815 mm
