MEC-ETS/KiCad_Library/3D_Models/Inductors/PA4304.STEP

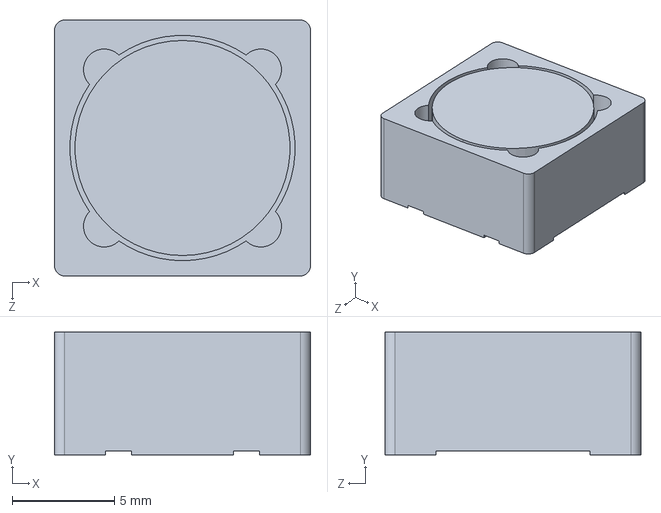
[picture p111: CAD file, 2025-02-11]
3D_Models/Inductors/PA4304.STEP
12.5 x 6.00 x 12.5 mm
