MEC-ETS/KiCad_Library/3D_Models/Resistors/R1812.step

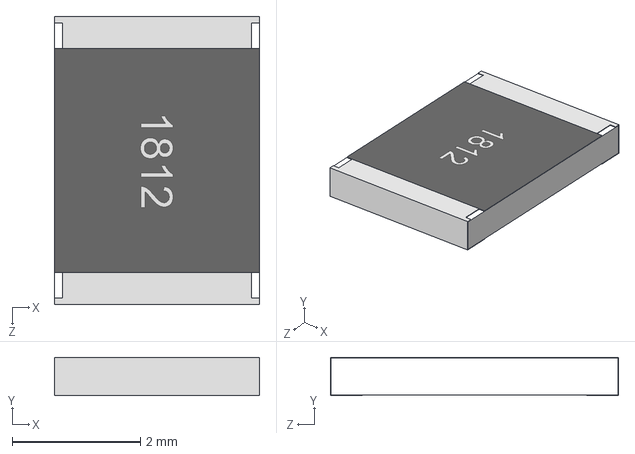
[picture p113: CAD file, 2025-02-11]
3D_Models/Resistors/R1812.step
3.20 x 0.6 x 4.50 mm
