MEC-ETS/KiCad_Library/3D_Models/Connectors/B4B-XH-A.step

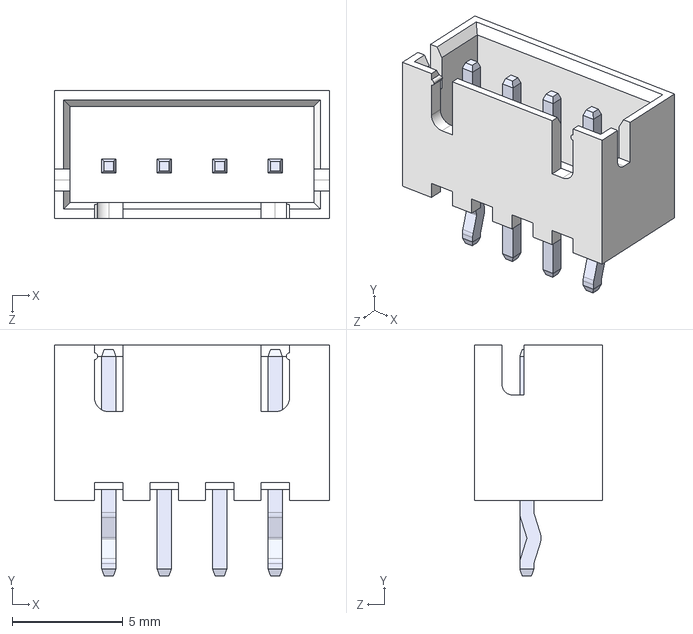
[picture p114: CAD file, 2025-03-13]
3D_Models/Connectors/B4B-XH-A.step
12.4 x 10.4 x 5.75 mm
