MEC-ETS/KiCad_Library/3D_Models/Diodes/WL_SMCW-0805_GREEN.stp

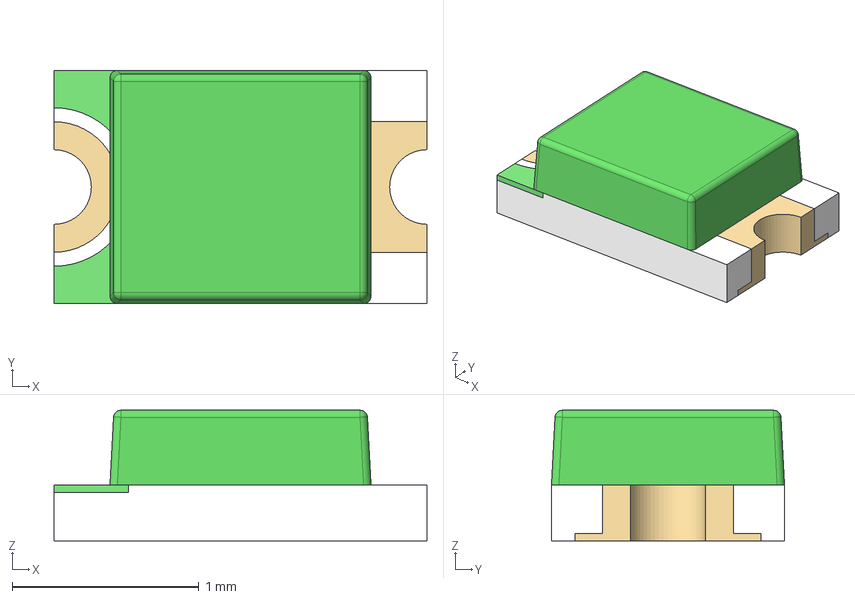
[picture p115: CAD file, 2025-02-11]
3D_Models/Diodes/WL_SMCW-0805_GREEN.stp
2.00 x 1.25 x 0.7 mm
marking x 2
base
base_2
housing
cover
