MEC-ETS/KiCad_Library/3D_Models/IC/TSOT-23-6.step

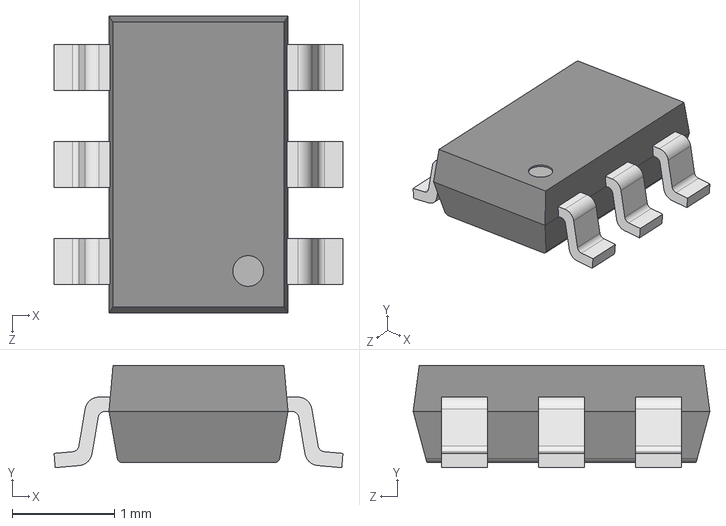
[picture p116: CAD file, 2025-02-11]
3D_Models/IC/TSOT-23-6.step
2.82 x 1.00 x 2.90 mm
