MEC-ETS/KiCad_Library/3D_Models/Inductors/WE-HCI-7040.stp

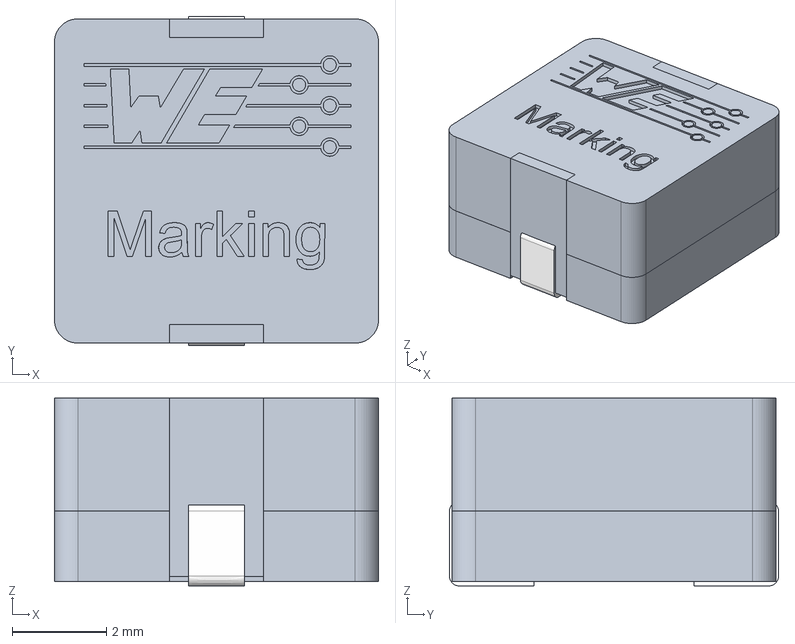
[picture p117: CAD file, 2025-02-11]
3D_Models/Inductors/WE-HCI-7040.stp
6.90 x 7.00 x 4.00 mm
