MEC-ETS/KiCad_Library/3D_Models/Relays/LI05-1A85.stp

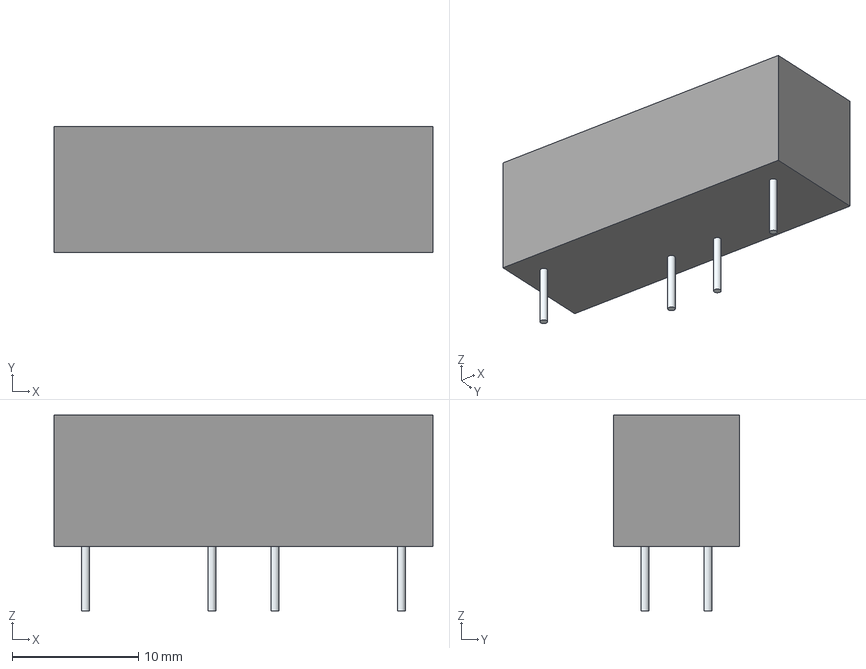
[picture p118: CAD file, 2025-02-11]
3D_Models/Relays/LI05-1A85.stp
30.0 x 10.0 x 15.5 mm
Leads
