MEC-ETS/KiCad_Library/3D_Models/Resistors/67W.step

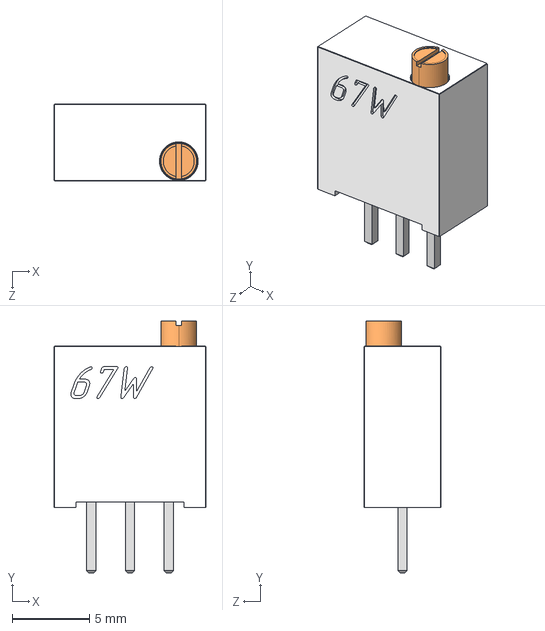
[picture p119: CAD file, 2025-02-11]
3D_Models/Resistors/67W.step
9.80 x 16.3 x 4.95 mm
