MEC-ETS/KiCad_Library/3D_Models/Capacitors/C2220.step

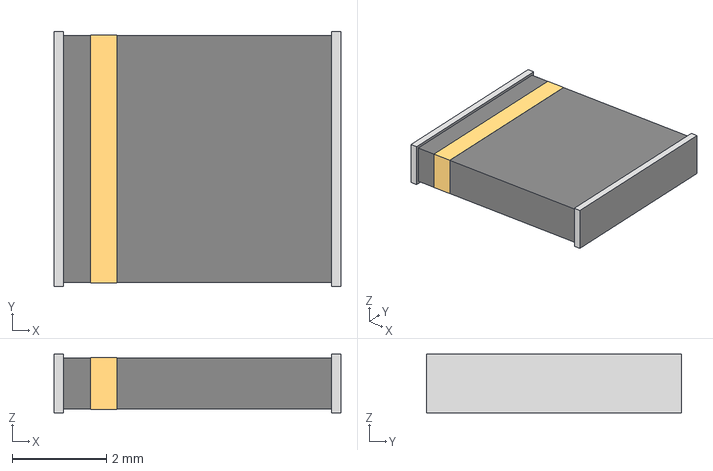
[picture p120: CAD file, 2025-02-11]
3D_Models/Capacitors/C2220.step
6.10 x 5.41 x 1.25 mm
