MEC-ETS/KiCad_Library/3D_Models/Connectors/6120XX21621_61201021621.step

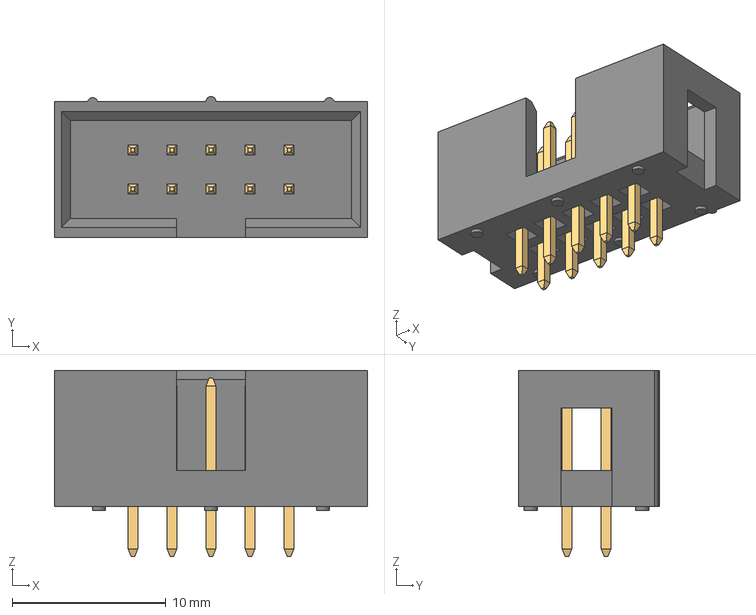
[picture p121: CAD file, 2025-03-10]
3D_Models/Connectors/6120XX21621_61201021621.step
20.4 x 9.18 x 12.1 mm
6120xx21621_PIN x 10
