MEC-ETS/KiCad_Library/3D_Models/Diodes/SOD-128.step

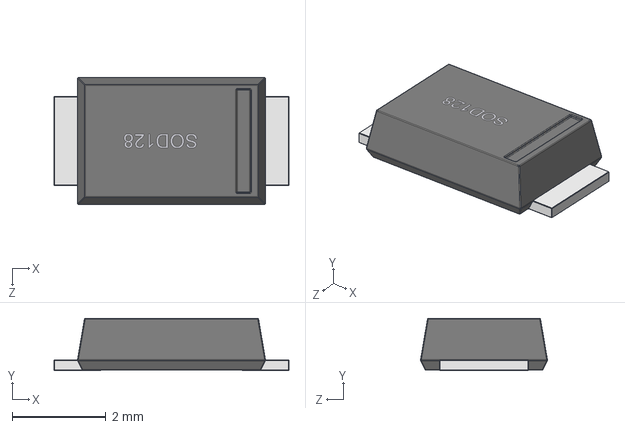
[picture p122: CAD file, 2025-02-11]
3D_Models/Diodes/SOD-128.step
5.00 x 1.11 x 2.70 mm
