MEC-ETS/KiCad_Library/3D_Models/IC/AP2210N-3.3TRG1.step

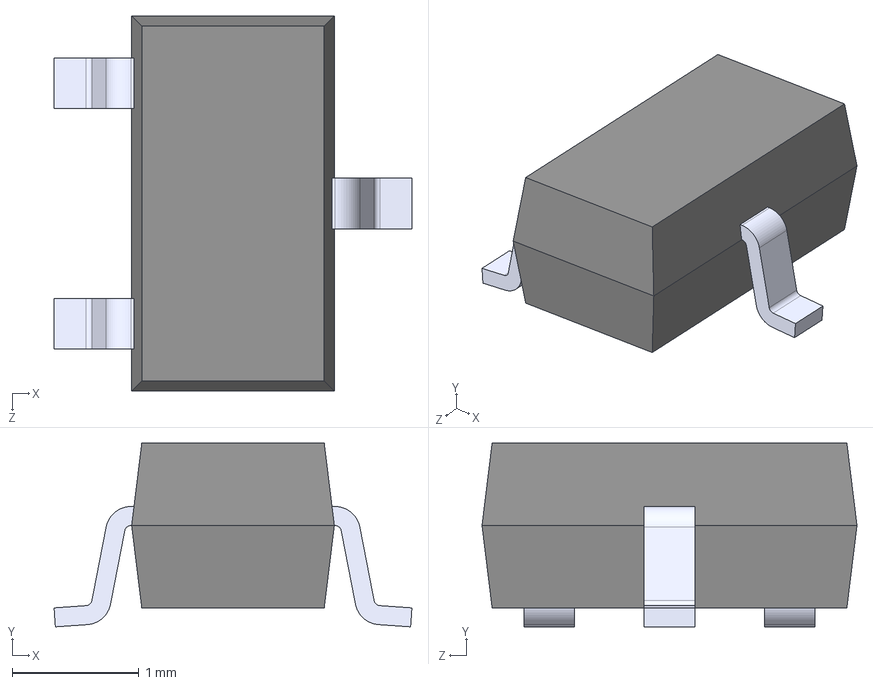
[picture p123: CAD file, 2025-02-11]
3D_Models/IC/AP2210N-3.3TRG1.step
2.83 x 1.45 x 2.96 mm
