MEC-ETS/KiCad_Library/3D_Models/Inductors/PQ35x35.step

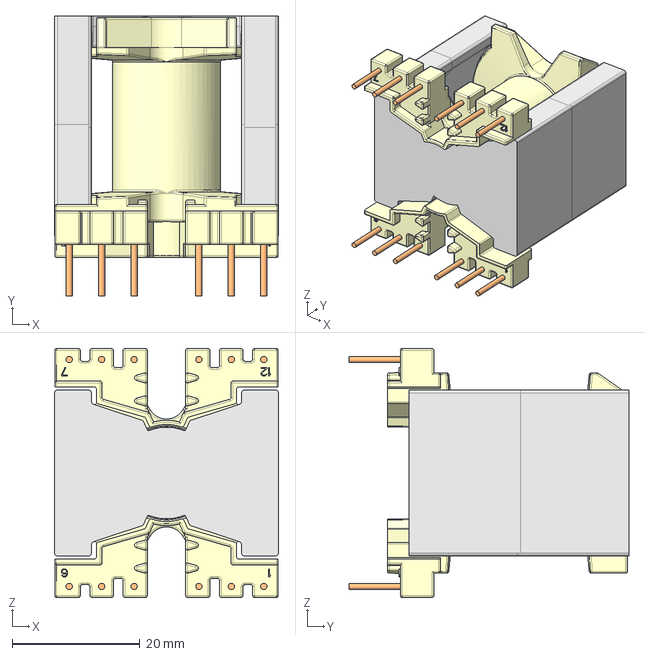
[picture p124: CAD file, 2025-02-11]
3D_Models/Inductors/PQ35x35.step
35.1 x 43.8 x 39.0 mm
PRT0001
PQ35_35_DG150_N95_N97 x 2
