MEC-ETS/KiCad_Library/3D_Models/Resistors/R2010.step

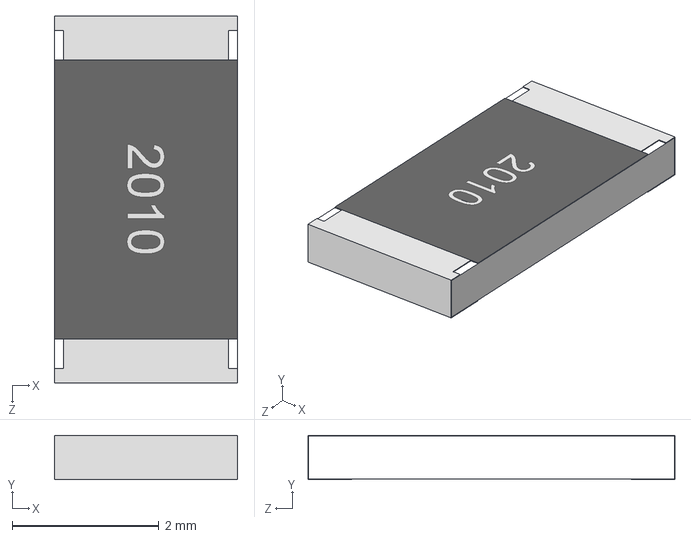
[picture p125: CAD file, 2025-02-11]
3D_Models/Resistors/R2010.step
2.50 x 0.6 x 5.00 mm
