MEC-ETS/KiCad_Library/3D_Models/Capacitors/CAP_WURTH_P10L13W5.stp

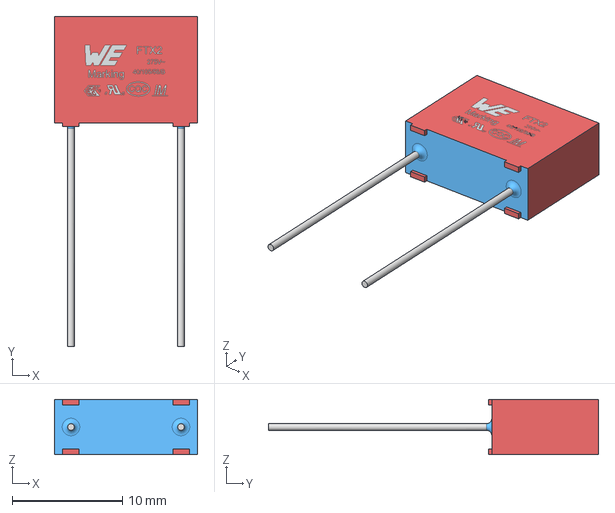
[picture p126: CAD file, 2025-02-11]
3D_Models/Capacitors/CAP_WURTH_P10L13W5.stp
13.0 x 30.0 x 5.00 mm
