MEC-ETS/KiCad_Library/3D_Models/Connectors/1-796949-3.step

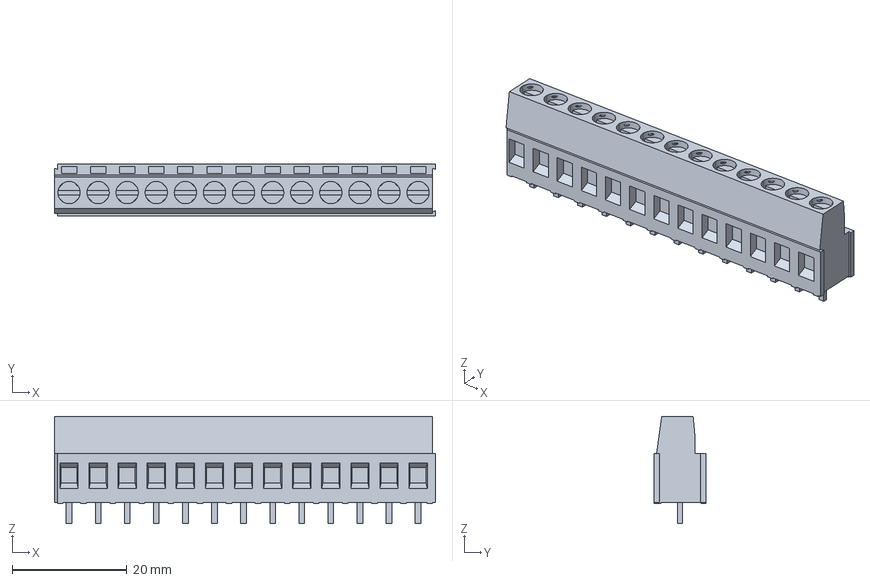
[picture p127: CAD file, 2025-03-08]
3D_Models/Connectors/1-796949-3.step
66.5 x 9.00 x 18.7 mm
