MEC-ETS/KiCad_Library/3D_Models/Capacitors/CapAluRadial_D125H400P50.step

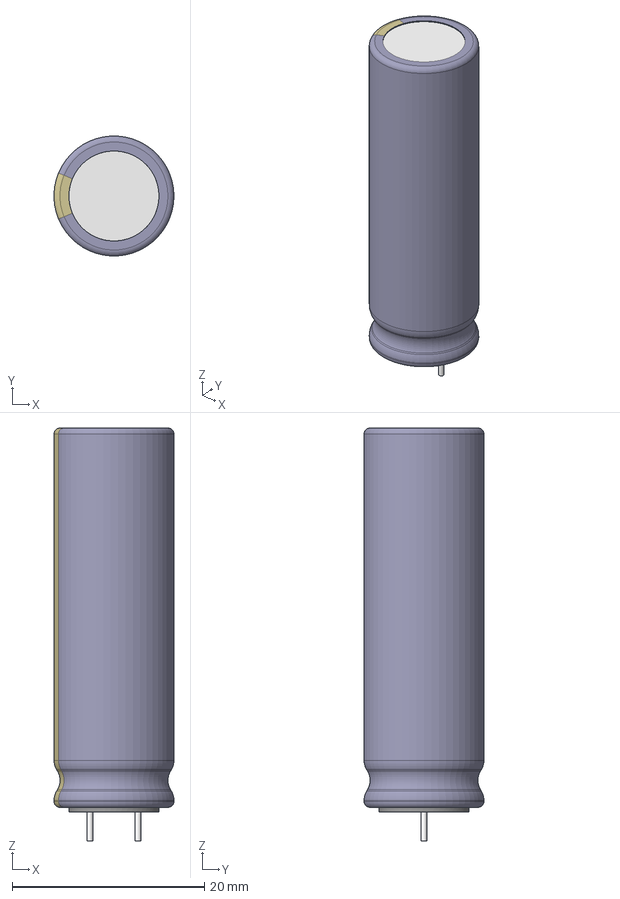
[picture p128: CAD file, 2025-02-11]
3D_Models/Capacitors/CapAluRadial_D125H400P50.step
12.5 x 12.5 x 43.0 mm
