MEC-ETS/KiCad_Library/3D_Models/Connectors/PJ-002A.step

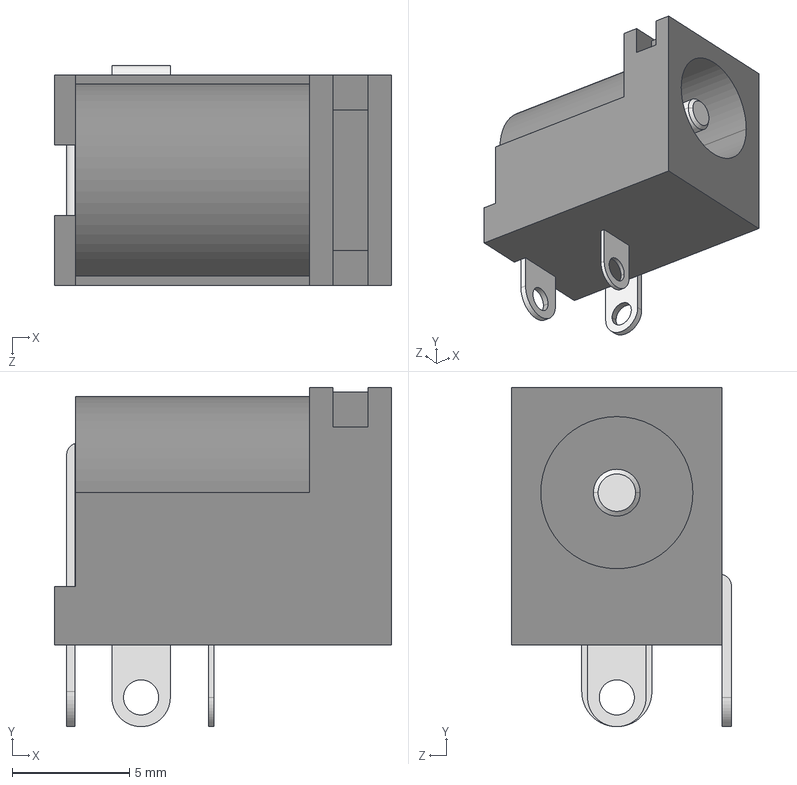
[picture p129: CAD file, 2025-03-04]
3D_Models/Connectors/PJ-002A.step
14.4 x 14.5 x 9.40 mm
