MEC-ETS/KiCad_Library/3D_Models/Diodes/SOD-923.step

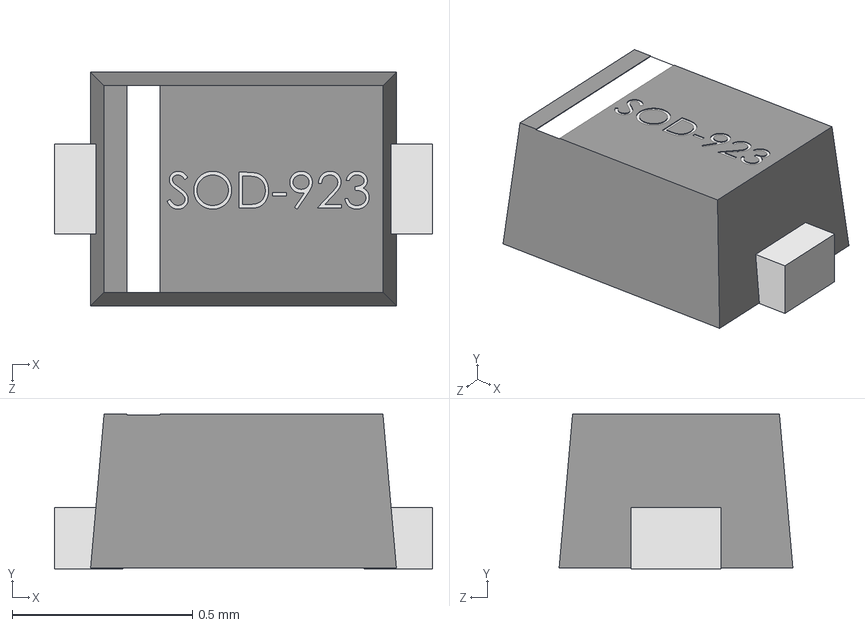
[picture p130: CAD file, 2025-02-11]
3D_Models/Diodes/SOD-923.step
1.05 x 0.43 x 0.65 mm
