MEC-ETS/KiCad_Library/3D_Models/IC/SOIC-8.step

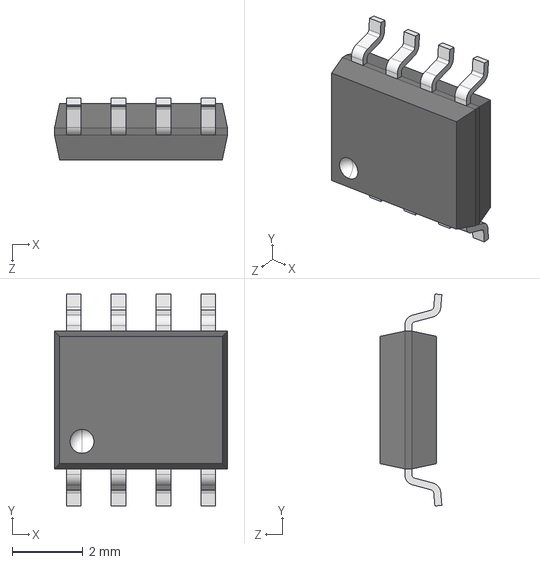
[picture p131: CAD file, 2025-02-11]
3D_Models/IC/SOIC-8.step
4.90 x 6.00 x 1.75 mm
