MEC-ETS/KiCad_Library/3D_Models/Resistors/TR50.stp

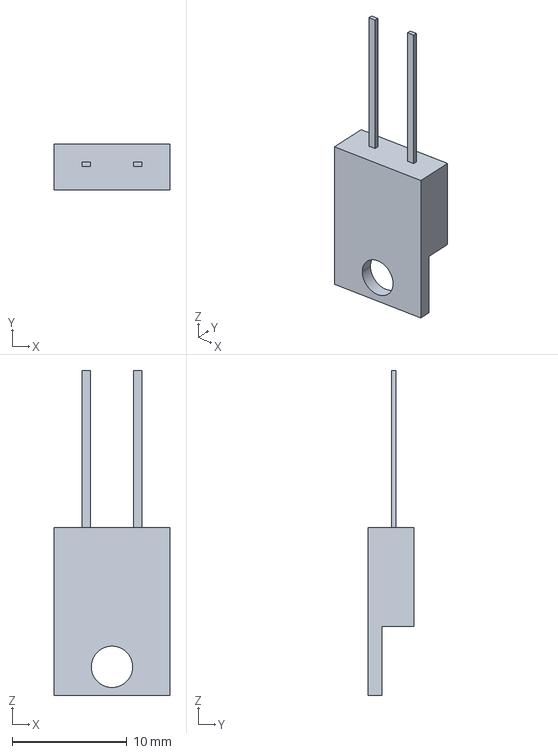
[picture p132: CAD file, 2025-02-11]
3D_Models/Resistors/TR50.stp
10.1 x 4.00 x 28.3 mm
