MEC-ETS/KiCad_Library/3D_Models/Capacitors/C0805.step

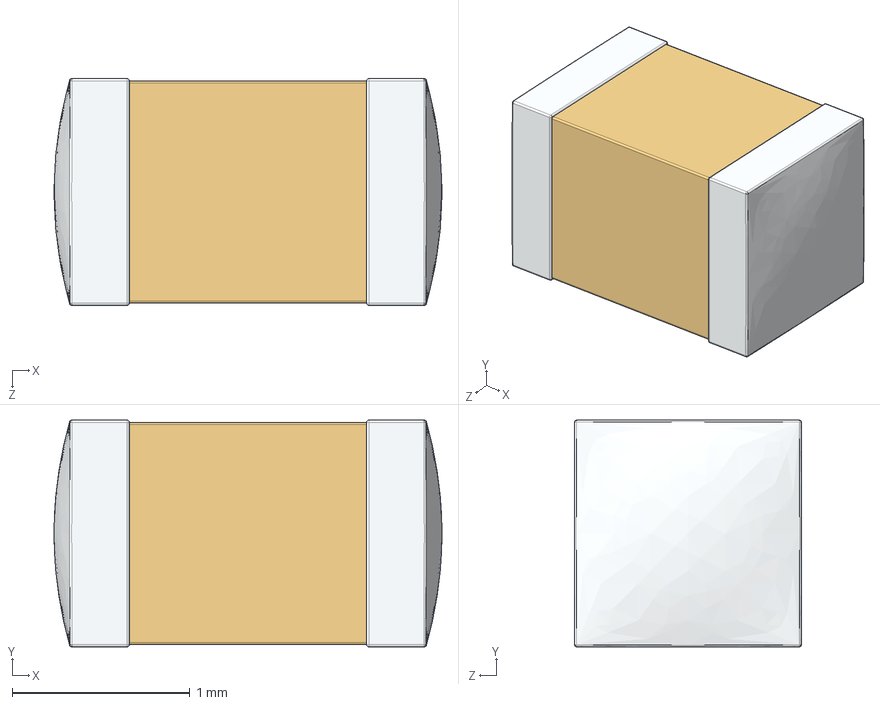
[picture p133: CAD file, 2025-02-11]
3D_Models/Capacitors/C0805.step
2.18 x 1.27 x 1.27 mm
