MEC-ETS/KiCad_Library/3D_Models/Connectors/TBL004-508-24BE-2GY.step

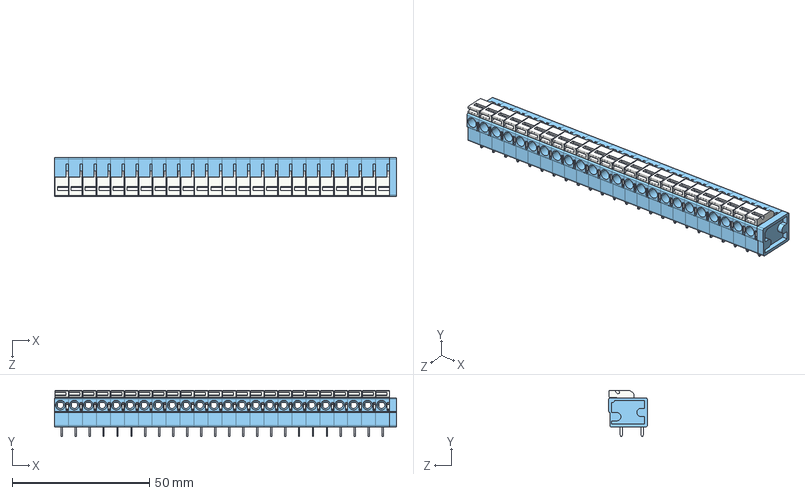
[picture p134: CAD file, 2025-03-04]
3D_Models/Connectors/TBL004-508-24BE-2GY.step
124.4 x 16.8 x 14.1 mm
TBL004-508 - END CAP_Blue
TBL004-508 - BODY_Blue x 24
TBL004-508 - PUSH BUTTON_Gray x 24
