MEC-ETS/KiCad_Library/3D_Models/Diodes/TO-220-2.step

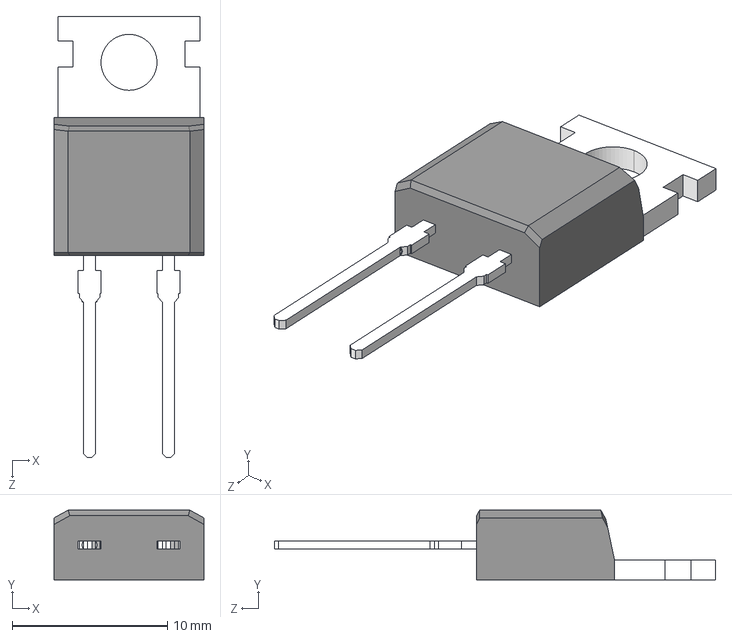
[picture p135: CAD file, 2025-02-11]
3D_Models/Diodes/TO-220-2.step
9.65 x 4.50 x 28.4 mm
