MEC-ETS/KiCad_Library/3D_Models/IC/SOT-23-5.step

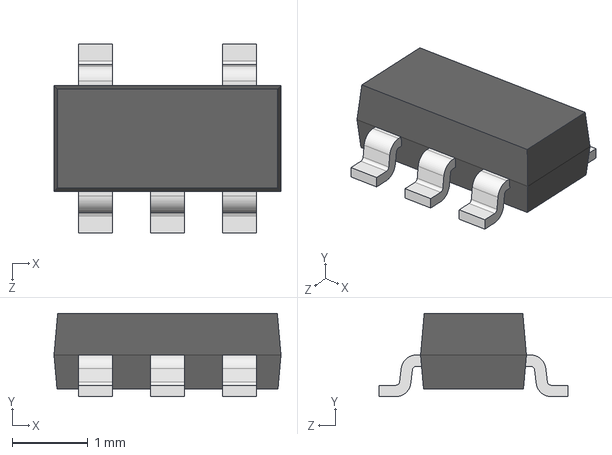
[picture p136: CAD file, 2025-02-11]
3D_Models/IC/SOT-23-5.step
3.00 x 1.10 x 2.50 mm
