MEC-ETS/KiCad_Library/3D_Models/Resistors/R1210.step

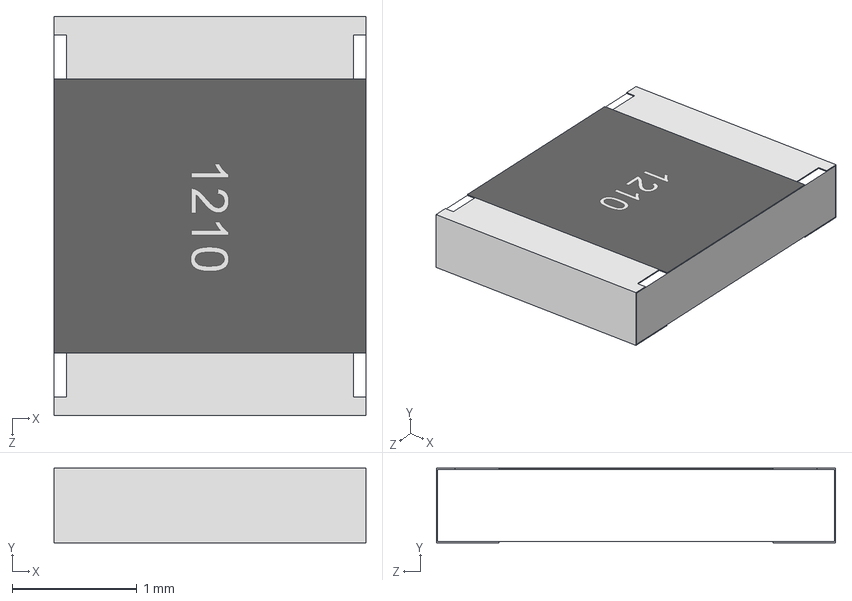
[picture p137: CAD file, 2025-02-11]
3D_Models/Resistors/R1210.step
2.50 x 0.6 x 3.20 mm
