MEC-ETS/KiCad_Library/3D_Models/Diodes/USBLC6-2SC6.STEP

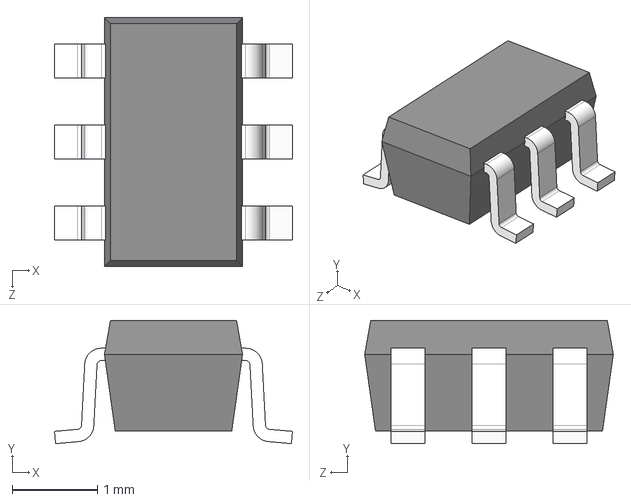
[picture p138: CAD file, 2025-02-11]
3D_Models/Diodes/USBLC6-2SC6.STEP
2.80 x 1.45 x 2.92 mm
