MEC-ETS/KiCad_Library/3D_Models/Resistors/TO220_2PIN.STEP

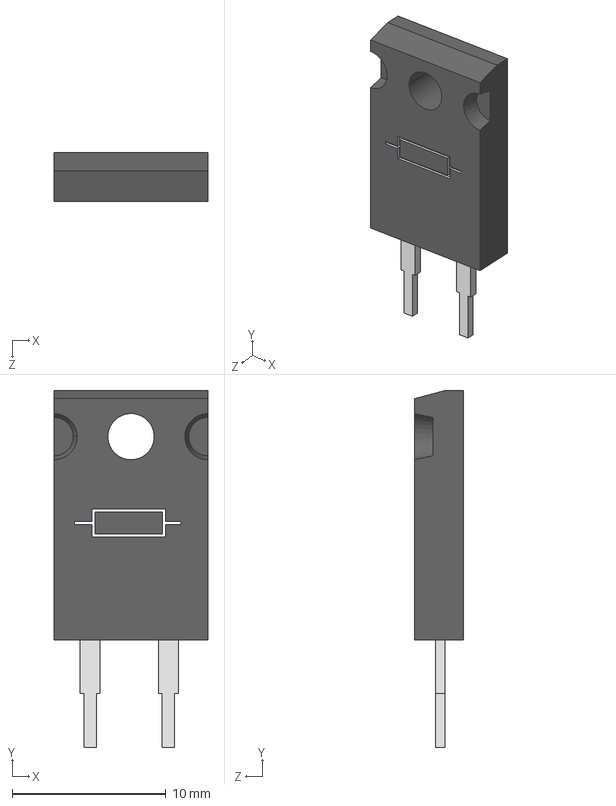
[picture p140: CAD file, 2025-02-11]
3D_Models/Resistors/TO220_2PIN.STEP
10.0 x 23.2 x 3.20 mm
