MEC-ETS/KiCad_Library/3D_Models/Connectors/54-00127.step

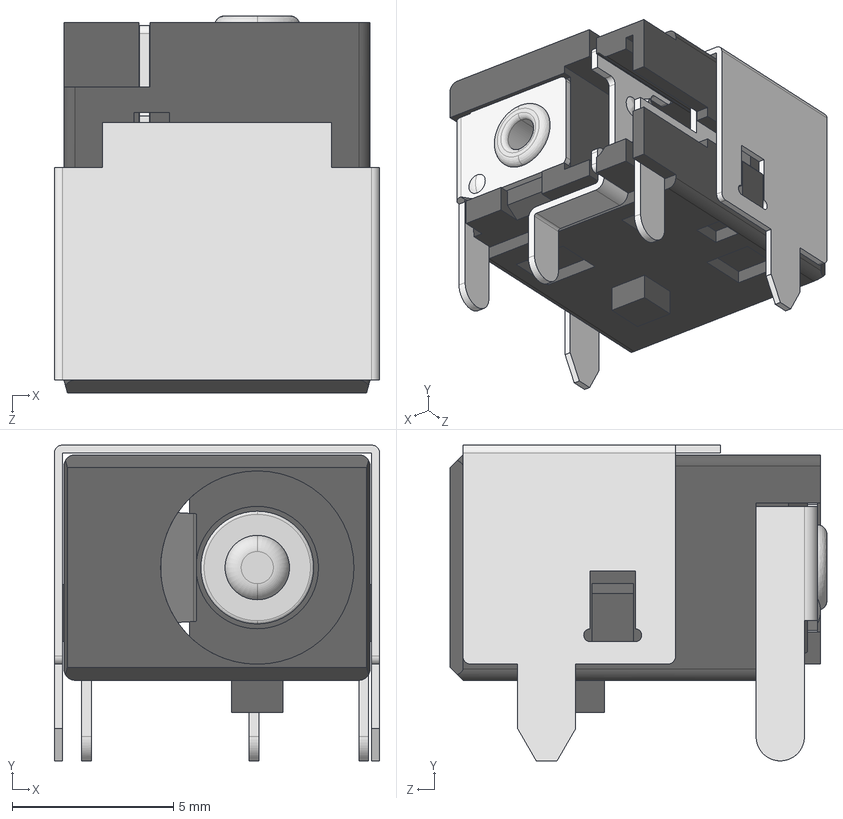
[picture p141: CAD file, 2025-03-04]
3D_Models/Connectors/54-00127.step
10.1 x 9.80 x 11.7 mm
