MEC-ETS/KiCad_Library/3D_Models/Diodes/T4F16AHM3_H.stp

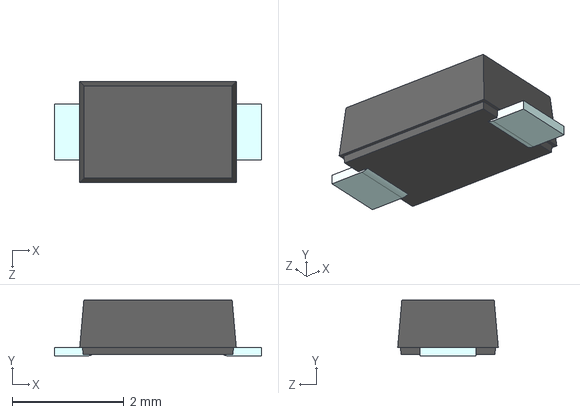
[picture p142: CAD file, 2025-02-11]
3D_Models/Diodes/T4F16AHM3_H.stp
3.70 x 1 x 1.80 mm
