MEC-ETS/KiCad_Library/3D_Models/Diodes/SBRD10200TR--3DModel-STEP-56544.STEP

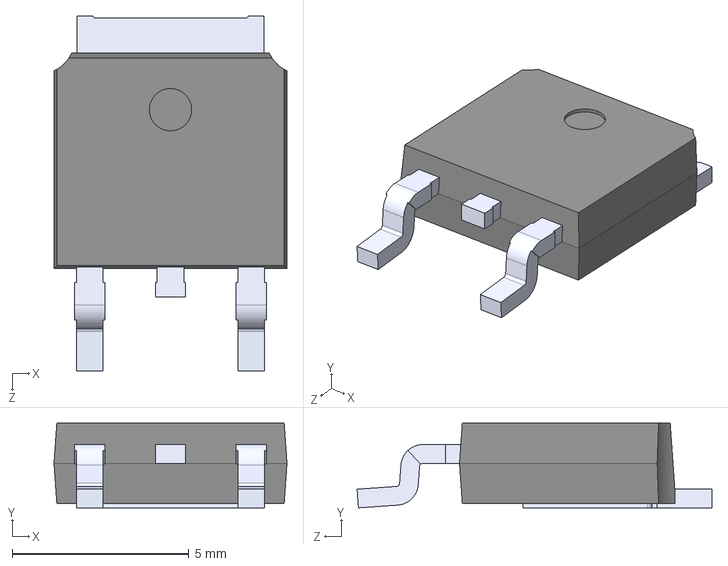
[picture p143: CAD file, 2025-02-11]
3D_Models/Diodes/SBRD10200TR--3DModel-STEP-56544.STEP
6.60 x 2.40 x 10.1 mm
