MEC-ETS/KiCad_Library/(list of files, cad)

Other CAD files:
3D_Models/IC/SOT-23_TO-236_VIS.step
3D_Models/Relays/c-2-1462039-9-b5-3d.stp
3D_Models/Relays/c-9-1393792-9-c-3d.stp
3D_Models/Diodes/WL_SMCW-0805_BLUE.stp
3D_Models/IC/SOLID-11.step.SLDPRT
3D_Models/Assembly/367661_dec_module_24-2.stp
3D_Models/Assembly/380200_dec_module_50-5.stp
3D_Models/Assembly/ACZ11BR4E.stp
3D_Models/Capacitors/860010674014.stp
3D_Models/Choke/744231061_WE-CNSW-0805_rev1.stp
3D_Models/Connectors/022272041.stp
3D_Models/Connectors/039281083.stp
3D_Models/Connectors/039291048.stp
3D_Models/Connectors/039299042.stp
3D_Models/Connectors/039301080.stp
3D_Models/Connectors/0430450600.step
3D_Models/Connectors/1050170001.STEP
3D_Models/Connectors/1694224.stp
3D_Models/Connectors/1694240.stp
3D_Models/Connectors/1837N12_Stackable Snap-in Supports.stp
3D_Models/Connectors/1935161.stp
3D_Models/Connectors/1935174.step
3D_Models/Connectors/1935174.stp
3D_Models/Connectors/1935187.stp
3D_Models/Connectors/2068320601.stp
3D_Models/Connectors/2125201004.stp
3D_Models/Connectors/430450613.step
3D_Models/Connectors/430450821.stp
3D_Models/Connectors/436500404.step
3D_Models/Connectors/436500409.step
3D_Models/Connectors/61300211021_STP_61300211021_rev1.stp
3D_Models/Connectors/61400413321.stp
3D_Models/Connectors/61400416121.stp
3D_Models/Connectors/615008137121.stp
3D_Models/Connectors/61900611121.step
3D_Models/Connectors/629105136821.step
3D_Models/Connectors/64900221122.stp
3D_Models/Connectors/649002227222.stp
3D_Models/Connectors/64900311122.step
3D_Models/Connectors/64900311122.stp
3D_Models/Connectors/649003127222.stp
3D_Models/Connectors/649004127222 (rev1).stp
3D_Models/Connectors/649004227222.stp
3D_Models/Connectors/64900621122.stp
3D_Models/Connectors/649006227222.stp
3D_Models/Connectors/649008227222.stp
3D_Models/Connectors/649012227222.stp
3D_Models/Connectors/649016227222.stp
3D_Models/Connectors/649022227222.stp
3D_Models/Connectors/66200221122.stp
3D_Models/Connectors/6871XX14522_68711014522.step
3D_Models/Connectors/691137710002.step
3D_Models/Connectors/691317710003.stp
3D_Models/Connectors/691317710004.stp
3D_Models/Connectors/74650094 (rev1) (1).stp
3D_Models/Connectors/74655095 (rev1).stp
3D_Models/Connectors/B7P-VH.step
3D_Models/Connectors/CT3149-X.stp
3D_Models/Connectors/CUI_DEVICES_PJ-047AH.step
3D_Models/Connectors/Editable-Header_Male_40Pin.STEP
3D_Models/Connectors/JST 2_54 4x.STEP
3D_Models/Connectors/KF2-M3-ET.stp
3D_Models/Connectors/NPPN101BFCN-RC.stp
3D_Models/Connectors/PJ-082BH.step
3D_Models/Connectors/S4B-XH-SM4-TB.STEP
3D_Models/Connectors/T-Plug_male_Deans.step
3D_Models/Connectors/TORX1350A_F_.stp
3D_Models/Connectors/TOTX1350_V,F_.stp
3D_Models/Connectors/TSW-125-14-F-D.stp
3D_Models/Connectors/Test_Point_Keystone_5001_BLACK.STEP
3D_Models/Connectors/USB4110GFA.step
3D_Models/Connectors/XSxx43.step
3D_Models/Connectors/XT30PB.stp
3D_Models/Connectors/c-2350514-4-a-3d.stp
3D_Models/Connectors/c-2350514-8-a-3d.stp
3D_Models/Connectors/female_header_2_54_2X19.stp
3D_Models/Connectors/male_header_2_54_1X1.step
3D_Models/Connectors/male_header_2_54_1X10.step
3D_Models/Connectors/male_header_2_54_1X11.step
3D_Models/Connectors/male_header_2_54_1X12.step
3D_Models/Connectors/male_header_2_54_1X13.step
3D_Models/Connectors/male_header_2_54_1X14.step
3D_Models/Connectors/male_header_2_54_1X15.step
3D_Models/Connectors/male_header_2_54_1X16.step
3D_Models/Connectors/male_header_2_54_1X17.step
3D_Models/Connectors/male_header_2_54_1X18.step
3D_Models/Connectors/male_header_2_54_1X19.step
3D_Models/Connectors/male_header_2_54_1X2.step
3D_Models/Connectors/male_header_2_54_1X20.step
3D_Models/Connectors/male_header_2_54_1X21.step
3D_Models/Connectors/male_header_2_54_1X22.step
3D_Models/Connectors/male_header_2_54_1X23.step
3D_Models/Connectors/male_header_2_54_1X24.step
3D_Models/Connectors/male_header_2_54_1X25.step
3D_Models/Connectors/male_header_2_54_1X26.step
3D_Models/Connectors/male_header_2_54_1X27.step
3D_Models/Connectors/male_header_2_54_1X28.step
3D_Models/Connectors/male_header_2_54_1X29.step
3D_Models/Connectors/male_header_2_54_1X3.step
3D_Models/Connectors/male_header_2_54_1X30.step
3D_Models/Connectors/male_header_2_54_1X31.step
3D_Models/Connectors/male_header_2_54_1X32.step
3D_Models/Connectors/male_header_2_54_1X33.step
3D_Models/Connectors/male_header_2_54_1X34.step
3D_Models/Connectors/male_header_2_54_1X35.step
3D_Models/Connectors/male_header_2_54_1X36.step
3D_Models/Connectors/male_header_2_54_1X37.step
3D_Models/Connectors/male_header_2_54_1X3_angle.step
3D_Models/Connectors/male_header_2_54_1X4.step
3D_Models/Connectors/male_header_2_54_1X5.step
3D_Models/Connectors/male_header_2_54_1X6.step
3D_Models/Connectors/male_header_2_54_1X6_angle.step
3D_Models/Connectors/male_header_2_54_1X7.step
3D_Models/Connectors/male_header_2_54_1X8.step
3D_Models/Connectors/male_header_2_54_1X9.step
3D_Models/Connectors/pxc_1924101_03_02_MSTB-2-5-HC-4-GF-5-08_3D.stp
3D_Models/Diodes/4-sip_KBU.step
3D_Models/Diodes/4-square.step
3D_Models/Diodes/DO-214AC_SMA.step
3D_Models/Diodes/SBR1U400P1-7.stp
3D_Models/Diodes/SOD-123FL.step
3D_Models/Diodes/SOD-323.step
3D_Models/Diodes/SOD-80.step
3D_Models/Diodes/SOT143-4L.stp
3D_Models/Diodes/TO-263.stp
3D_Models/Diodes/WL-SMCW-0805.stp
3D_Models/Diodes/WL_SMCW-0805_RED.stp
3D_Models/Diodes/WL_SMCW-0805_YELLOW.stp
3D_Models/Diodes/XSxx43.step
3D_Models/Diodes/ll-34.step
3D_Models/Fuses/696108003002.stp
3D_Models/IC/1769205241.stp
3D_Models/IC/4-SMD.step
3D_Models/IC/6-SMD.step
3D_Models/IC/74LVC4245APW.stp
3D_Models/IC/8MA2_ATM.step
3D_Models/IC/ACPL-C87AT-000E.step
3D_Models/IC/AnalogDevices_16-MSOP.step
3D_Models/IC/BNO055.step
3D_Models/IC/COMPOUND-23.step.SLDPRT
3D_Models/IC/COMPOUND-24.step.SLDPRT
3D_Models/IC/COMPOUND-3.step.SLDPRT
3D_Models/IC/CQB60W-110S24.stp
3D_Models/IC/D0008A.stp
3D_Models/IC/DPAK-5L.stp
3D_Models/IC/DRV0006A.stp
3D_Models/IC/GPS_sam-m8q.STEP
3D_Models/IC/INA2181A2IDSQR.stp
3D_Models/IC/LM5165XDRCT.step
3D_Models/IC/LQFP-64.step
3D_Models/IC/LQFP64.step
3D_Models/IC/LTC4421CG#PBF.stp
3D_Models/IC/LTC6362CDD_TRPBF.step
3D_Models/IC/M-C448_Heat_Sink_Kit.stp
3D_Models/IC/MCB90N12A-TP.step
3D_Models/IC/MCP4728T-E_UN.step
3D_Models/IC/MCP6002-I_SN.stp
3D_Models/IC/MSOP-10.step
3D_Models/IC/MSOP-12.step
3D_Models/IC/MSOP-16.step
3D_Models/IC/MSOP-8.step
3D_Models/IC/NAU7802SGI.stp
3D_Models/IC/R-78E5.0-0.5.step
3D_Models/IC/R1SE-0505-R--3DModel-STEP-56544.STEP
3D_Models/IC/SC70-4.step
3D_Models/IC/SN74HCS08QDRQ1.stp
3D_Models/IC/SO-8.step
3D_Models/IC/SOIC-14.step
3D_Models/IC/SOIC-16.step
3D_Models/IC/SOIC-24-300.STEP
3D_Models/IC/SOIC-8_Wide_5mmx5mm.step
3D_Models/IC/SOLID-10.step.SLDPRT
3D_Models/IC/SOLID-12.step.SLDPRT
3D_Models/IC/SOT-223.step
3D_Models/IC/SOT-23-6.step
3D_Models/IC/SOT-89.step
3D_Models/IC/SSOP-20.step
3D_Models/IC/SSOP-24.step
3D_Models/IC/TCA9617BDGKR.step
3D_Models/IC/TLA2528IRTER.stp
3D_Models/IC/TO-220-5.step
3D_Models/IC/TO-220-7.step
3D_Models/IC/TO-220-Coucher.step
3D_Models/IC/TO-220.step
3D_Models/IC/TO-263-3.step
3D_Models/IC/TO-263-5.step
3D_Models/IC/TO-263-7.step
3D_Models/IC/TO-263.step
3D_Models/IC/TO-3P(N).step
3D_Models/IC/TPS62125DSGR.step
3D_Models/IC/TSOT-23-5.STEP
3D_Models/IC/TSSOP-14.step
3D_Models/IC/TSSOP-16.step
3D_Models/IC/TSSOP-28.STEP
3D_Models/IC/UFQFPN-48_7X7X0P55MM.step
3D_Models/IC/VQFN-24.step
3D_Models/IC/VSSOP-10.step
3D_Models/IC/VSSOP-8.step
3D_Models/IC/VSSOP-8_DGK.STEP
3D_Models/IC/Vicor VI-200.stp
3D_Models/IC/Vicor_Micro.STP
3D_Models/IC/Vicor_Mini.step
3D_Models/IC/ncs1.step
3D_Models/IC/ten8wi.stp
3D_Models/IC/tmr6wir.stp
3D_Models/IC/tmr6wir_3d_drawing.stp
3D_Models/Inductors/744043151.stp
3D_Models/Inductors/74438335100.stp
3D_Models/Inductors/744821201.stp
3D_Models/Resistors/35221M5JT.step
3D_Models/Resistors/352220RFT.step
3D_Models/Switches/416131160803.stp
3D_Models/Switches/428527320916.step
3D_Models/Transformers/7508110151.step
