MEC-ETS/KiCad_Library/Spice_Models/Manufacturer/Maxim Integrated/ReadMe.txt

SPICE Models

SPICE Macromodel Files

Information furnished by Maxim Integrated Products is believed to be accurate and reliable. However, the company cannot assume responsibility for use of any circuitry other than the circuitry entirely embodied in a Maxim product; nor for any infringements of patents or other rights of third parties that may result from its use. No license is granted by implication or otherwise under any patent rights of Maxim Integrated Products. Maxim reserves the right to change the circuitry and specifications without notice. 

Op-Amp/Comparator Macromodels
Performance parameters incorporated in models are based primarily on measured performance as taken from bench tests and production run averages, and secondarily on split between data sheet MIN/MAX parameter values. Macromodels are intended as an aid for design and prototyping. Industry standard macromodels for op-amps and comparators, including those supplied by Maxim, are based on simplified circuit expressions, and/or replacement of active circuit elements with ideal controlled voltage and current sources. As such, simulation with macromodels should not be relied upon as final proof-of-design. Use of macromodel descriptions is not a substitute for worst-case design analysis, nor for testing real circuits over temperature, supply, and other operating limits.

Op-Amps and Comparators are grouped into families with similar characteristics. These families appear in files named MAXxxx.FAM where MAXxxx is the first part number of the family.
