MEC-ETS/KiCad_Library/(commit log)

2025-02-26 ajout nucleo stm32f446re
2025-02-26 update nucleo footprint assignation TODO: update fields
2025-02-26 ajout ac dc
    [power_supply_irm-30-5.stp]
2025-02-26 modif nucleo
    [039281083.stp]
2025-02-26 ajout driver moteur
    [367661_dec_module_24-2.stp, 380200_dec_module_50-5.stp]
2025-02-27 pcb H_Bridge
2025-02-28 update pcb puissance komodoControl
    [2125201004.stp, 35221M5JT.step, 352220RFT.step, 4628.step, 74LVC1G14GW_125.step, 7508110151.step, B7P-VH.step, C5750X7R2E105K230KA.step]
2025-02-28 update library
    [430450613.step]
2025-03-04 komodo control librairie update
    [54-00127.step, 691137710002.step, DBV0006A.stp, PJ-002A.step, TBL004-508-24BE-2GY.step, TO-220_STM.step]
2025-03-04 komodo control librairy update
    [SOT-23_TO-236_VIS.step]
2025-03-08 biblio update
    [1-796949-3.step]
2025-03-10 ajout 3d model
    [6120XX21621_61201021621.step]
2025-03-13 ajout connecteurs jst
    [B2B-XH-A.step, B3B-XH-A.step, B4B-XH-A.step, B5B-XH-A.step]
2025-03-14 ajout tvs, resistances et fix connecteurs molex
    [XT60PW MALE.STEP]
2025-03-17 edit footprint
    [039301080.stp]
2025-03-18 update lib
    [022272041.stp, 039299042.stp, KTT0003B.stp, LD1117DT33CTR.step, LQFP144-20x20mm.step, OBJ_GREGS-SK6812MINI-E-DOWN-POINTING.obj, SMD WS2812B Mini.step, SOT-23_ONS.step]
2025-03-18 ajout switch
    [D501J12S2APQA.stp]
2025-03-18 update rocker switch symbol
2025-03-18 update switch
2025-03-21 update footprints
2025-08-30 rajout des composantes
    [SRD-05VDC-SL-C.step]
